giandcdalcorso11-coder/CNC-2D/documento-sessione-cnc-2d.md

# Documento di Sessione — CNC 2D Plotter

**Versione:** 32
**Ultimo aggiornamento:** 2026-10-17 09:24

## Regole di co-editing

Questo documento è scritto da **due sessioni Claude Code in parallelo sullo stesso branch**: una sul fronte **meccanica/firmware**, una sul fronte **contenuti e serie social**. Per non perdere voci a vicenda:

1. **`git fetch` e rebase prima di scrivere, push subito dopo.** Non lasciare modifiche locali non pushate: la finestra di collisione è tutta lì.
2. **Marca la voce di storico con il fronte di lavoro**, es. `### [2026-09-26 17:48] (meccanica) …`. Due sessioni diverse sono due voci diverse: la regola "una voce per sessione" non impone di fonderle.
3. **Le note dei singoli Step si appendono in fondo al proprio Step**, quindi non collidono mai finché le due sessioni lavorano su Step diversi.
4. **Se la Versione va in conflitto**, chi risolve mette `max(A, B) + 1` e tiene **entrambe** le voci, ordinate per data decrescente. Mai scartarne una.
5. Gli unici punti di contesa reali sono **le due righe di testata** e **la prima riga dopo `## Storico sessioni`**. Tutto il resto è partizionato per costruzione.

## Vision

Macchina CNC 2D per disegno/plotter, con:
- Assi X/Y motorizzati (NEMA17 modello 17HS4023 + driver A4988)
- Asse Z tramite servomotore per alzare/abbassare la penna
- Controllo firmware via ESP32 con FluidNC
- Invio G-code via Wi-Fi (WebUI di FluidNC), senza necessità di cavo USB durante il disegno
- In prospettiva, un software "stile slicer" per convertire SVG/immagini in G-code e caricarlo sulla macchina

## Pipeline

### Convenzioni valide per tutta la pipeline

**Nomi degli assi (dal 2026-10-15).** Secondo la convenzione cartesiana del
foglio, decisa dall'utente:

| Asse | Che cosa è | Staffa | Motore |
|---|---|---|---|
| **X** | la trave del portale: ci corre sopra il carrello che porta la penna | staffa LL, 550 | STEP D25 · DIR D33 |
| **Y** | le due rotaie di base: ci scorre sopra tutto il portale | staffe TT, 2 × 400 | STEP D4 · DIR D26 |

**Attenzione leggendo il resto del documento:** tutte le voci dello storico e
tutte le note anteriori al 2026-10-15 usano la nomenclatura precedente, in cui
X e Y erano **scambiati** rispetto a questa tabella. Non sono state riscritte —
le voci passate non si toccano. Quando una nota vecchia dice "corsa X 242,475"
intende la corsa del portale sulle rotaie di base, che oggi si chiama Y.

**Nomi delle staffe (dal 2026-10-12).** **Staffa TT** = le due rotaie da 400.
**Staffa LL** = la trave del portale da 550.

**Nomi delle due applicazioni (dal 2026-10-15).** Il progetto ne ha due, con
ruoli diversi, e non si sostituiscono a vicenda:

- **GDC CNC 2D SLICER** — l'applicazione vera: la webapp dello Step 4 (`webui/`)
  più la configurazione FluidNC che la esegue (`firmware/fluidnc/`). Importa il
  disegno, genera il G-code, comanda la macchina
- **Pannello di controllo manuale GDC CNC 2D** — lo strumento di collaudo dello
  Step 1.1 (`firmware/cnc2d_dashboard/`): frecce, un giro di pignone, slider del
  servo, log, OTA. Serve a montare e diagnosticare, non a disegnare

La cartella e il file dello sketch restano `cnc2d_dashboard`: l'IDE Arduino
esige che cartella e sketch abbiano lo stesso nome e non accetta spazi, quindi
il nome esteso vive nel titolo della pagina e nei README, non nel filesystem.

**Il repository GitHub si chiama `GDC-CNC-2D`** (rinominato dall'utente il
2026-10-15; GitHub non accetta spazi nei nomi e li sostituisce con trattini).
Non ha rotto nessun link: GitHub Pages non è attivo su questo repository,
l'applicazione è servita dall'ESP32 sulla rete locale, e GitHub redirige
automaticamente il vecchio URL. L'unico modo di rompere la redirezione è
creare un giorno un altro repository chiamato `CNC-2D` sullo stesso account.

### Step 1 — Bring-up alimentazione e logica ESP32

**Stato:** completato

**Obiettivo:** ESP32 funzionante e alimentabile sia da USB che da batteria, con GPIO verificati

**Decisioni progettuali:**
- Ramo alimentazione logica (5V, ESP32) separato dal ramo 24V dei motori
- **Una spina sola per tutta la macchina: 12 V / 3 A, due 7805 indipendenti.** Supera sia il ramo a 24 V sia la batteria 18650. Il mattone (DVE DSA-36W-12, 36 W) alimenta direttamente i VMOT dei due driver e, attraverso **due L7805CV separati**, il 5 V della logica e il 5 V del servo. Il punto non è il numero di regolatori: è che **i due 5 V non si possono tirare giù a vicenda**, perché ciascuno ha 7 V di margine e oltre 60 dB di reiezione. Un interruttore unico sui 12 V, a monte di tutto. Bilancio: picco ~2,15 A sui 3 A disponibili. **Alternative scartate:** un solo regolatore condiviso (è la configurazione che ha causato il brownout del servo); uno switching LM2596 (più efficiente e sarà l'upgrade, ma non ce l'aveva e due lineari separati sono elettricamente più puliti di uno switching condiviso); alimentazione separata del servo da una seconda presa, rifiutata dall'utente — una macchina si accende con una spina
- **Il 18650 e il modulo di ricarica escono dal progetto.** Hanno fatto il loro lavoro nel bring-up dei LED. Per motori e servo non reggono: il modulo dà ~1 A dichiarato con protezione che interviene prima, mentre il solo servo chiede 700 mA di spunto (1,4 A per un MG90S) e il boost ne tira 1,6 dalla cella per darne 1 in uscita
- **La breadboard resta il circuito definitivo, ma solo per i segnali.** Decisione dell'utente, con tre eccezioni concordate: i due 7805 coi loro condensatori vanno su millefori saldata (sono la parte più calda e con più corrente, e non cambieranno mai più); il ramo 12 V di potenza va su morsetti a vite (un contatto di breadboard è dato per ~1 A e lì ne passano fino a 2); la breadboard va fissata meccanicamente e i cavi ancorati con fascette. Il motivo delle eccezioni è la vibrazione: il portale accelera a 0,3 g sulla stessa tavola, e un contatto a frizione che diventa intermittente sulla linea STEP dà **passi persi**, cioè un difetto che si va a cercare nella meccanica dove non c'è
- Batteria 18650 + modulo boost/carica 5V Type-C (supporta "discharge while charging", quindi utilizzabile anche mentre è in carica)
- Interruttore SPST inserito solo sulla linea 5V+ verso il pin VIN dell'ESP32 (non sulla batteria), per non interrompere la ricarica quando la macchina è spenta
- GND comune tra guida breadboard, modulo batteria ed ESP32, verificato in continuità

**Criterio di completamento:** LED collegato a D2 lampeggia correttamente sia alimentato da USB sia da batteria+interruttore

**Note (cronologia dello step):**
- [2026-09-19] Verificati componenti hardware (batteria NASTIMA 12V, motori 17HS4023, driver A4988, alimentatore 24V riciclato da striscia LED) tramite confronto con i link Amazon e datasheet
- [2026-09-19] Test ESP32 standalone via USB-C con sketch Blink su D2 (GPIO2) e resistenza 220 ohm — riuscito
- [2026-09-19] Aggiunto modulo batteria 18650 (boost 5V + carica Type-C) e interruttore sulla linea 5V+ verso VIN — testato e funzionante
- [2026-09-26] **L'alimentatore non è più il 24 V recuperato dalla striscia LED**, ma un DVE DSA-36W-12: **12 V, 3 A, 36 W**. Supera il dato del 2026-09-19. Nota importante sulle conseguenze: a corrente impostata uguale, **la tensione di alimentazione non cambia né la coppia né la temperatura dei motori**, perché l'A4988 è un driver a corrente controllata — la tensione decide solo quanto in fretta la corrente sale, quindi conta alle alte velocità. Bilancio a 12 V con tre motori a 0,6 A: 0,28 A ciascuno, 0,85 A in totale, ~14 W su 36 disponibili (28% della corrente). L'unico punto in cui i 12 V stringono è il collegamento di due motori in serie su un solo driver: 6,0 V dei 12 se ne vanno fra caduta resistiva, induttanza e forza controelettromotrice, contro i 3,0 V di un motore per driver

#### Step 1.1 — Dashboard web di controllo e test

**Stato:** completato

**Obiettivo:** dashboard web autonoma ospitata direttamente sull'ESP32, raggiungibile dalla rete Wi-Fi di casa, con un controllo di test sul LED e configurazione Wi-Fi senza dover ricompilare/riflashare

**Decisioni progettuali:**
- Web server nativo (`WebServer.h`, incluso nel core ESP32) invece di `ESPAsyncWebServer`, per non richiedere librerie esterne da installare
- Credenziali Wi-Fi salvate in NVS (`Preferences`) e configurabili da una tab dedicata nella dashboard; fallback automatico ad Access Point di emergenza (`CNC-2D-Setup`) se la connessione alla rete salvata fallisce, così la pagina resta sempre raggiungibile per correggerle
- mDNS (`cnc2d.local`) per raggiungere la dashboard senza dipendere dall'IP assegnato dal router
- Frecce direzionali presenti in UI ma non collegate a nessuna funzione, in previsione del controllo assi X/Y (Step 2)
- Tab "Codice" lasciata come placeholder: in futuro servirà per caricare direttamente un file G-code dal browser (non per compilare sketch — l'ESP32 non può compilare C++ da solo), da attivare dopo aver validato motori (Step 2) e servo/pen-lift (Step 3)

**Criterio di completamento:** dashboard raggiungibile da browser sulla rete di casa, pulsante centrale che accende/spegne il LED su D2 in tempo reale, funzionamento verificato sia con ESP32 alimentato da USB sia da batteria+interruttore

**Note (cronologia dello step):**
- [2026-09-19] Implementato sketch `firmware/cnc2d_dashboard/cnc2d_dashboard.ino` con web server, pagina a 3 tab (Controllo, Wi-Fi, Codice), salvataggio credenziali Wi-Fi su NVS e fallback ad AP di emergenza
- [2026-09-19] Bug: errore di compilazione "unterminated raw string" — causato da copia-incolla manuale del codice in un nuovo sketch anziché apertura diretta del file `.ino`, con probabile perdita dell'ultima riga di chiusura della stringa raw; risolto scaricando il file raw direttamente da GitHub
- [2026-09-19] Test completo riuscito: provisioning Wi-Fi di casa dalla tab dedicata, dashboard raggiungibile su `http://cnc2d.local`, LED su D2 controllato correttamente sia da alimentazione USB sia da batteria 18650+interruttore
- [2026-09-20] Aggiunti alla dashboard: 2 nuovi LED di stato (verde su D18, giallo su D19) con pulsanti dedicati Rosso/Giallo/Verde sotto le frecce (il pulsante centrale del joystick è stato disabilitato, non usa più il LED); supporto ArduinoOTA per aggiornare il firmware via Wi-Fi dopo il primo upload USB; tab "Log" che mostra in tempo reale gli stessi messaggi del Serial Monitor (utile perché il Serial Monitor via USB non è più disponibile quando si aggiorna via OTA)
- [2026-09-20] Frecce sinistra/destra collegate al motore X (STEP/DIR/ENABLE): click singolo = un passo, pressione prolungata = rotazione continua non bloccante; aggiunti pulsanti "Giro completo ←/→" (200 passi) per test rapido — dettagli del cablaggio e del debug nello Step 2
- [2026-09-20] Rifattorizzato il motore della dashboard: il movimento non è più eseguito dentro l'handler HTTP (che bloccava per 3 secondi affamando `server.handleClient()` e l'OTA) ma da una coda di passi servita in `loop()`, prima e dopo `handleClient()`; DIR impostato una sola volta a inizio movimento con tempo di assestamento invece che a ogni impulso; aggiunta rampa di accelerazione opzionale sui primi 40 passi
- [2026-09-20] Aggiunta tab "Motore": intervallo tra i passi regolabile da browser (300 µs – 200 ms), numero di passi, rampa on/off, abilitazione diretta del driver e sezione "Test pin" che forza STEP/DIR/EN a un livello fisso per poterli misurare col multimetro. Ogni movimento registra nel log i passi effettivamente emessi, così si distingue subito un problema firmware da uno elettrico
- [2026-10-12] **Bug: il servo non si muove e la scheda si spegne**
  **Sintomo:** a ogni comando del servo il LED rosso dell'ESP32 e quello del modulo di ricarica si spegnevano per un istante; il servo non si muoveva affatto. I LED comandati dalla dashboard funzionavano, quindi scheda e rete erano sane. Con l'ESP32 spostato su alimentatore da muro il sintomo cambiava: la scheda restava accesa, il servo **vibrava** e i LED del modulo batteria lampeggiavano in continuazione
  **Causa:** il servo e la logica condividevano il 5 V del modulo 18650. Lo spunto del servo (700 mA, 1,4 A per un MG90S) faceva collassare quel ramo; l'ESP32 andava in brownout e, resettandosi, smetteva di generare il PWM — quindi il servo non arrivava mai in posizione. Nella seconda configurazione il collasso restava sul solo ramo servo e si vedeva per quello che era: **protezione che scatta e riparte in ciclo** (*hiccup mode*), con il servo alimentato a singhiozzo
  **Fix applicato:** due L7805CV separati dai 12 V, uno per la logica e uno per il servo. **Confermato dall'utente: tutti i test passano.** Il percorso diagnostico è costato due giorni perché l'alimentazione era stata classificata come causa poco probabile (vedi voce di storico del 2026-10-13)
- [2026-10-13] **Mancano i condensatori ceramici e per ora si va avanti così.** Montati solo gli elettrolitici. Funziona, ma l'elettrolitico alle alte frequenze non c'è: senza un ceramico vicino ai piedini il 7805 può oscillare nei MHz, e il sintomo non è un guasto netto — è riscaldamento inspiegabile, rumore sul 5 V, qualche reset a caso. Da aggiungere: **100 nF su IN e su OUT di ogni regolatore**, più uno in parallelo ai 100 µF sul VMOT di ogni driver

### Step 2 — Bring-up driver A4988 e motori (X/Y)

**Stato:** completato

**Obiettivo:** un motore NEMA17 pilotato correttamente da un driver A4988 tramite ESP32, poi due motori in parallelo

**Decisioni progettuali:**
- Vref target ~0.5-0.56V per 0.7A per fase (corrente nominale reale del 17HS4023, non 1.0A come inizialmente indicato da una fonte esterna consultata)
- Alimentazione di potenza: alimentatore switching DC **12V/3A** (DVE DSA-36W-12). Sostituisce l'alimentatore riciclato dalla striscia LED RGB, che si è rivelato inutilizzabile (vedi bug sotto). 12V sono ampiamente sufficienti per il plotter e fanno scaldare molto meno il driver rispetto a 24V
- **Condensatore elettrolitico 100 µF / 50 V obbligatorio tra VMOT e GND del driver**, il più vicino possibile al modulo: senza, i picchi induttivi generati dalle bobine a ogni commutazione distruggono l'A4988 (è la causa della perdita dei primi due moduli)
- Collaudo di accettazione di ogni nuovo modulo A4988 prima di alimentarlo: continuità tra STEP, DIR, EN e GND deve essere **muta** su tutti e tre. Venti secondi che smascherano subito un ingresso in corto
- Pin driver: STEP su D4, DIR su D26 (era D16), ENABLE su D27 (era D17) — spostati da D16/D17 per un problema di instabilità non ancora confermato con certezza (vedi bug nello storico sessioni)
- Bobine motore identificate via continuità: bobina 1 = fili rosso+blu, bobina 2 = fili nero+verde; mappate sul driver rispettivamente su 1A/1B e 2A/2B (l'assegnazione "1"/"2" rispetto ai colori è invertita rispetto al primo tentativo ma elettricamente corretta, non causa malfunzionamenti — cambia solo il verso di rotazione)
- Alimentatore 24V riciclato da striscia LED RGB: verificato con multimetro che il filo bianco è il vero 24V+ e il filo rosso è il GND (contro-intuitivo rispetto al colore); i fili blu e verde sono ridondanti (stesso nodo del bianco) e isolati, non utilizzati
- Scheda "Nano Terminal Adapter" (pensata per Arduino Nano) riadattata come morsettiera generica per i collegamenti di potenza (24V e fili motore), sfruttando il fatto che è puramente passiva (screw terminal + header pin sullo stesso nodo) — alternativa scartata: morsetti a vite dedicati, non disponibili al momento
- Velocità di step di partenza volutamente prudente (senza rampa di accelerazione) per il primo test, da aumentare più avanti con una rampa vera

**Criterio di completamento:** rotazione controllata e affidabile di entrambi i motori tramite comandi step/dir dall'ESP32

**Note (cronologia dello step):**
- [2026-09-20] Cablaggio completo del driver A4988 (logica + potenza) e del motore X, con verifica pin ENABLE tramite conteggio sull'etichettatura reale del modulo (foto)
- [2026-09-20] Bug: primo driver A4988 non muoveva il motore
  Sintomo: nessuna reazione del motore a "Giro completo" né alle frecce, solo un leggero ronzio; bloccato con forza al tatto (normale per uno stepper abilitato, non diagnostico da solo)
  Causa: sospetto danneggiamento del chip driver (probabile durante le prove di cablaggio in tensione) — tutti i controlli di continuità su STEP/DIR/ENABLE/VDD/RESET-SLEEP/VMOT/GND risultati corretti
  Fix applicato: sostituito con un secondo modulo A4988 di scorta — con il nuovo modulo il motore ha iniziato a muoversi (parzialmente), confermando che il primo era guasto
- [2026-09-20] Bug: Vref bloccato a 0,20V sul secondo modulo, il potenziometro sembrava non avere effetto
  Sintomo: valore instabile e comunque fermo a 0,20V (target 0,50–0,56V) girando il trimmer
  Causa: misura instabile a causa del motore collegato durante la prova (rumore/carico sul riferimento)
  Fix applicato: misurato Vref a motore scollegato — tarato correttamente a 0,55V
- [2026-09-20] Bug: il motore gira solo con passi singoli, non con pressione prolungata né con "Giro completo"
  Sintomo: ogni click singolo produce un piccolo movimento pulito senza perdere passi; in sequenza continua il motore non si muove (con solo un leggero ronzio) oppure avanza a scatti di circa 1/5 di giro senza completare la rotazione
  Causa: individuata con un test del "wiggle" — muovendo il filo che collega ENABLE (D17) durante il funzionamento, il motore si mette a girare; il problema persiste anche sostituendo il filo con uno nuovo o cambiando i fori della breadboard, e la continuità elettrica su quel filo risulta comunque corretta a riposo. Causa non ancora confermata con certezza: si sospetta un comportamento specifico dei pin GPIO16/GPIO17 (usati per DIR/ENABLE), che su alcune varianti di modulo ESP32 con PSRAM (WROVER) sono riservati e non utilizzabili come GPIO liberi — dalla foto del modulo (etichettato solo "ESP-32", nessuna scritta "WROVER" visibile) non è stato possibile confermare con certezza se questo sia il caso
  Fix applicato: non ancora confermato — spostati DIR (D16→D26) ed ENABLE (D17→D27) su pin sicuramente liberi da questo vincolo su qualunque variante ESP32; il test dopo lo spostamento non è ancora stato riportato a fine sessione — **da riprendere nella prossima sessione**
- [2026-09-20] Il bug sopra è stato **risolto**: lo spostamento su D26/D27 non c'entrava nulla e l'ipotesi PSRAM/WROVER era sbagliata. La causa reale era l'alimentatore di potenza (vedi bug successivo). I pin sono stati comunque lasciati su D26/D27, che vanno benissimo
- [2026-09-20] Bug: alimentatore di potenza inutilizzabile — **causa radice di tutta la sessione**
  Sintomo: tensione su VMOT del driver oscillante tra 1 V e 20 V invece che ferma; coppia di tenuta debolissima (l'albero si girava con due dita, mentre a 0,69 A/fase dovrebbe essere immobile); passi singoli occasionalmente corretti, rotazione continua mai
  Causa: l'alimentatore riciclato è un **controller per strisce LED RGB**, non un alimentatore DC. Dei 4 fili, il bianco è il +24V comune e rosso/verde/blu sono le tre uscite di canale, cioè MOSFET pilotati in PWM. Usare il filo rosso come massa significava alimentare il driver attraverso un interruttore che si apriva e chiudeva continuamente. Verificato misurando sotto carico su tutti e tre i canali: instabili tutti
  Fix applicato: sostituito con un alimentatore switching DC 12V/3A, misurato stabile a 12,2 V. **Confermato**
- [2026-09-20] Bug: secondo driver A4988 con ingresso STEP in corto verso massa
  Sintomo: dopo aver risolto l'alimentazione, l'albero era finalmente duro e il test ENABLE rispondeva, ma nessun comando produceva movimento e il motore restava in silenzio assoluto. Misurando il pin STEP sul driver si leggeva sempre 0 V pur avendo continuità verso D4
  Causa: individuata dividendo il nodo STEP in due metà e misurandole separatamente — lato ESP32 muto (GPIO4 sano), lato driver in corto a 0,2 Ω, e sfilando il modulo la breadboard tornava muta. L'ingresso STEP era quindi in corto **dentro il chip**, inchiodato a 0 V. Danno provocato dallo stesso alimentatore RGB
  Fix applicato: sostituito con il terzo modulo A4988, collaudato prima dell'installazione con il test di continuità STEP/DIR/EN verso GND. **Confermato**
- [2026-09-20] Motore X funzionante: Vref tarato a 0,54 V sul nuovo modulo, test ENABLE corretto (albero bloccato con spunta, libero senza) e movimento comandato dalla dashboard riuscito
- [2026-09-21] Sweep di velocità completato su tutta la gamma disponibile fino a 500 passi/s: nessuna banda di risonanza, nessun microstepping necessario per la stabilità
- [2026-09-21] Secondo asse cablato: driver Y con STEP su D25 e DIR su D33, ENABLE condiviso con X su D27. Al primo avvio il motore Y girava da solo senza controllo — causa: D25/D33 non erano ancora configurati come uscite nel firmware e, restando ingressi flottanti, raccoglievano rumore che il driver interpretava come impulsi di STEP. Risolto portando i pin STEP a livello basso come prima istruzione di `setup()`
- [2026-09-21] **Step chiuso:** entrambi gli assi pilotati correttamente, singolarmente e in contemporanea
- [2026-10-12] **Microstep confermati 1/16 da un dato dell'utente**, non più per ipotesi: MS1, MS2 e MS3 sono ponticellati insieme e portati a VCC, e sulla tabella dell'A4988 tutti e tre alti = sedicesimo di passo. Quindi **33,953 passi/mm** è il numero vero, e il default della dashboard era già giusto
- [2026-10-12] **Dashboard riscritta per la trasmissione reale.** Tre cambiamenti strutturali: (a) i passi non escono più da `loop()` ma da un **timer hardware a 20 kHz** con accumulatore a virgola fissa — con i microstep attivi la frequenza sale a qualche migliaio di impulsi al secondo e `server.handleClient()` può bloccare il loop per centinaia di millisecondi, cioè buchi nel treno di impulsi; (b) l'interfaccia parla in **millimetri** (velocità 1÷100 mm/s, distanza in mm) invece che in passi, e il pulsante "360°" diventa "1 giro" = 94,2478 mm calcolati dai microstep impostati; (c) due pulsanti eseguono **quadrato da 40 mm e cerchio R20** come macchina a stati non bloccante, movimenti di penna compresi, replicando i file in `gcode/test/`. Aggiunto anche uno slider dell'angolo servo dal vivo nella tab Controllo
- [2026-10-12] **Bug: lo sketch non compila, "variable or field 'setDir' declared void"**
  **Sintomo:** errori a catena su tutte le funzioni che prendono `Motor&` o `DemoStep&`, indicando righe di definizione scritte correttamente e con la struct dichiarata cinquanta righe più su
  **Causa:** l'IDE Arduino genera da solo i prototipi di tutte le funzioni e li inserisce **subito prima della prima funzione del file**, con una direttiva `#line` che fa riportare l'errore alla riga della definizione originale. Spostando le costanti della trasmissione in cima, la prima funzione era diventata `stepsPerMm()`, che sta sopra `struct Motor`: i prototipi generati nominavano un tipo non ancora dichiarato. Nelle versioni precedenti funzionava **per caso**, perché la prima funzione era `logMsg()`, che sta sotto la struct
  **Fix applicato:** `Motor` e `DemoStep` spostate in una sezione "Tipi" in cima al file, prima di qualunque funzione, col commento che spiega perché non stanno vicino al codice che le usa. **Confermato: compila e gira.** Il controllo di sintassi fatto qui con g++ non poteva vedere l'errore per costruzione, perché g++ non inietta prototipi — il controllo è stato esteso emulando quel passaggio, e validato al contrario facendogli riprodurre l'errore sulla versione vecchia
- [2026-10-12] **Rampa del servo in firmware** (`servoGoTo` + `serviceServo`): invece di saltare all'angolo richiesto il servo ci arriva di N gradi ogni 10 ms, con N impostabile da 0 (salto secco) a 10. Serve contro il brownout — un servo che vede un errore grande parte alla corrente di stallo — ma **non sostituisce l'alimentazione**: abbassa il picco, non il consumo totale. Come diagnosi era decisiva, come cura no, ed è andata così. Le prove d'insieme ora aspettano che la penna sia **arrivata** invece di un ritardo fisso
- [2026-10-13] **I motori rallentano mentre si muove il servo, e non è un problema.** Lo stack Wi-Fi maschera le interruzioni per brevi istanti durante il traffico HTTP, quindi qualche tick del timer salta. Ma il contatore dei passi scala **solo quando un impulso esce davvero**: un tick saltato allunga il tempo, non toglie un passo. **Costa tempo, non posizione** — e quindi non invalida la taratura dei passi/mm, che si misura in distanza. Sparisce comunque da sé: nella macchina vera la penna si muove solo a carrelli fermi, ed è il G-code a imporlo

### Step 3 — Configurazione FluidNC

**Stato:** completato

**Obiettivo:** FluidNC installato e configurato come firmware definitivo della macchina, con movimento coordinato X/Y e pen-lift sul servo

**Decisioni progettuali:**
- **FluidNC è il firmware definitivo**, lo sketch `cnc2d_dashboard` retrocede a strumento di collaudo hardware. Motivo: interpolazione coordinata, pianificazione dell'accelerazione fra segmenti e interpretazione del G-code sono settimane di lavoro già risolte e collaudate su migliaia di macchine
- **Pen-lift come asse Z vero** tramite il tipo motore `rc_servo`, non tramite l'uscita PWM dello spindle con M3/M5. Supera la decisione originale dello Step 3: trattare la penna come un asse permette al generatore di G-code di gestirla come un movimento qualsiasi
- **Microstepping 1/16** (MS1/MS2/MS3 a VDD su entrambi i driver): a passo intero la risoluzione sarebbe di circa 0,2 mm per passo, uno scalino visibile a occhio sul tratto. A 1/16 si scende attorno ai 0,02 mm. Il valore esatto di `steps_per_mm` dipende dal pignone scelto (vedi Step 5) e va comunque tarato sulla macchina
- **Nessun azzeramento automatico**: niente finecorsa di riferimento, l'origine si imposta a mano con `G92 X0 Y0`. Conseguenza: `soft_limits` resta disattivo, perché FluidNC lo consente solo su macchina azzerata, e la protezione contro le uscite dall'area passa all'interfaccia web
- **Driver mai disabilitati** (`idle_ms: 255`): con l'azzeramento manuale, un asse che si ammorbidisce e viene spostato a mano farebbe perdere la posizione senza che nessuno se ne accorga. Annulla l'idea, discussa e poi scartata, di un auto-spegnimento dei driver dopo inattività
- **Due pulsanti di emergenza** su D13/D14 nell'angolo in basso a sinistra, configurati come finecorsa rigidi: in teoria non vengono premuti mai, se succede FluidNC ferma tutto e va in allarme. Cablati normalmente aperti verso massa — accettabile per un backstop, da rivedere con microswitch veri
- **LED di stato come `user_outputs`**, comandati dall'interfaccia web con M62/M63: verde = tutto bene, giallo = attenzione (non calibrato, posizione non attendibile, in pausa), rosso = errore
- **Azzeramento sui due pulsanti d'angolo, `soft_limits` attivi e `must_home` vero.** Supera la decisione "nessun azzeramento automatico" presa il 2026-09-21. I due pulsanti su D13/D14 esistono già e sono cablati: aggiungendo un blocco `homing` per asse diventano **anche** riferimenti di azzeramento, e questo sblocca `soft_limits`, cioè il **rifiuto dei movimenti fuori area nel pianificatore** invece che nell'interfaccia. Costo in componenti: zero, è una modifica al YAML. Il motivo per cui conta: un limite che vive solo nella UI non è una protezione ma un suggerimento — un comando battuto a mano nella console di FluidNC, un file malformato o un bug nel generatore lo scavalcano. La ripetibilità di un pulsante a cupola è scarsa (±1 mm), ma per la **sicurezza** basta che sia conservativo, non preciso: la dispersione sposta il disegno sul foglio, il margine copre l'incidente. Microswitch veri (±0,03) restano l'upgrade
- **I limiti stanno in due posti diversi perché sono due cose diverse.** Le **corse meccaniche** sono proprietà della macchina e vivono in FluidNC (`max_travel_mm`); il **foglio** è proprietà del lavoro e vive nell'app (`paper` + `sheetOrigin`); il **margine di sicurezza** è un numero proprio, esplicito ed editabile, e il limite effettivo (`corsa − margine`) è calcolato e mostrato, mai salvato. Applicazione della regola già scritta in `webui/js/settings.js`: "due posti in cui scrivere lo stesso numero sono due posti che prima o poi si contraddicono". Azzerando in un angolo basta **un numero per asse** invece di min e max, che è anche la convenzione di FluidNC
- **Il riferimento va sul metallo, il margine nel software.** Parcheggiare "a circa 2÷3 cm dal fondo" a occhio fa diventare l'errore di parcheggio un errore di margine: si crede di essere a 25 mm e si è a 12. Si va in battuta su qualcosa di fisico (errore zero per definizione) e il margine lo sottrae il firmware. Corollario: **i limiti sopravvivono al riavvio, il riferimento no** — un passo-passo senza encoder non può sapere se qualcuno ha spostato il carrello mentre era spento. Serve uno stato `NON AZZERATA` in cui sono permessi solo jog relativi a passo limitato, e nessun movimento assoluto né esecuzione di file

**Criterio di completamento:** la macchina disegna un quadrato e un cerchio con movimento coordinato dei due assi, verificabile a vista sui motori anche senza struttura montata

**Note (cronologia dello step):**
- [2026-09-21] Scritta la configurazione di partenza `firmware/fluidnc/cnc2d-config.yaml` con la mappa dei pin già validata. Restano da tarare `steps_per_mm`, `max_travel_mm` e gli estremi dell'impulso del servo, tutti dipendenti dalla meccanica
- [2026-09-21] Installazione FluidNC avviata dal web installer (`installer.fluidnc.com`, richiede Chrome o Edge perché usa WebSerial). Scelte: versione **v4.1.0** (ultima non pre-release), processore **esp32** (DevKit WROOM-32 a 30 pin), variante **wifi** (l'unica con WebUI), tipo **fresh-install**, interfaccia **WebUI-2** — scelta fra le tre disponibili perché è quella su cui è costruita la documentazione del wiki, e se ne può installare una sola
- [2026-09-21] Da verificare alla prima accensione: la configurazione è stata scritta sullo schema FluidNC 3.x, mentre la versione installata è la 4.1.0. Eventuali nomi di campo cambiati vengono segnalati dal validatore all'avvio
- [2026-09-21] **Lo schema 4.1.0 ha accettato la configurazione scritta sul 3.x senza una sola modifica.** Il dubbio segnalato nella nota precedente è risolto: nessun nome di campo è cambiato fra le due versioni per i costrutti che usiamo
- [2026-09-21] Attivazione della configurazione: il pulsante "Seleziona configurazione" del browser dei file non ha avuto effetto, si è dovuto usare `$Config/Filename=cnc2d-config.yaml` dal terminale. Il comando di modifica a runtime `$/axes/shared_stepper_disable_pin=...` non restituisce nulla sulla 4.1.0, quindi le correzioni alla configurazione si applicano ricaricando il file e riavviando con `$Bye`
- [2026-09-21] WiFi configurato in modalità STA, hostname `cnc2d`, raggiungibile su `http://cnc2d.local` e `http://192.168.1.11`. Da qui in avanti l'installer non serve più: si lavora dalla WebUI-2
- [2026-09-21] LED verificati funzionanti con `M62 P0/P1/P2` e `M63 P0/P1/P2` (P0 verde gpio.18, P1 giallo gpio.19, P2 rosso gpio.2). La variante immediata M64/M65 non è stata necessaria. Il canale per legare le spie allo stato della macchina è quindi disponibile
- [2026-09-21] Microstepping 1/16 verificato su entrambi gli assi: 40 mm comandati (3200 microscatti con `steps_per_mm: 80`) producono un giro esatto dell'albero. A passo intero ne avrebbero prodotti sedici, quindi il test è inequivocabile a occhio. Ponticelli realizzati a catena RST→MS3→MS2→MS1, sfruttando il fatto che RST è già a VDD ed è adiacente a MS3: tre ponticelli cortissimi per driver, nessun filo lungo
- [2026-09-21] **Step completato**: quadrato da 40 mm e cerchio da raggio 20 mm eseguiti correttamente, con ritorno alle coordinate di partenza. Il criterio di completamento è soddisfatto
- [2026-10-06] **`steps_per_mm` nella configurazione è sbagliato di 2,36×, ed è il primo numero da correggere.** `cnc2d-config.yaml` porta ancora `steps_per_mm: 80` con il commento "vale per cinghia GT2 + puleggia 20 denti". La macchina non ha più cinghie: con pignone e cremagliera m1.5 z=20 il giro vale `π · m · z = 94,2478` mm (= 20 denti × passo 4,7124), e con 200 passi × 16 microstep fa **33,953 passi/mm**. Finché quel numero è sbagliato ogni limite inserito è sbagliato dello stesso fattore — si scrive "300 mm di corsa" e la macchina ne percorre 707 — e nessun pannello può intercettarlo, perché il pannello parla in mm e il mm è falso. Il criterio di completamento dello step resta soddisfatto (quadrato e cerchio verificati a vista sui motori), ma le quote erano 2,36× quelle comandate
- [2026-10-06] Conseguenze collaterali del rapporto vero: risoluzione **0,0295 mm per microstep** (il gioco di 0,235 è 8× il passo, quindi è il gioco a dominare, non la risoluzione) e `max_rate_mm_per_min: 2000` corrisponde ora a 1132 microstep/s invece di 2667, cioè **un settimo** di quello che la meccanica regge (il motore è validato a 500 passi interi/s ≈ 235 mm/s). Verifica del rapporto: `G91 G0 X100`, misurare col calibro, correggere in proporzione

### Step 4 — GDC CNC 2D SLICER (interfaccia web e generazione G-code)

**Stato:** in corso

**Obiettivo:** un'unica pagina web da cui caricare un disegno, vederne l'anteprima sul foglio, generare il G-code e mandarlo in esecuzione

**Decisioni progettuali:**
- **Tutta l'elaborazione nel browser, l'ESP32 solo esegue.** L'ESP32 ha circa 300 KB di RAM utilizzabile: vettorializzare un'immagine e generare G-code è fuori portata. Il browser produce il file, l'ESP32 lo conserva ed esegue — così il disegno prosegue anche se si chiude il portatile o cade il Wi-Fi
- **Vettorializzazione con algoritmi deterministici** (Potrace o equivalente in JavaScript), non con un modello generativo. Alternativa scartata: passare l'immagine a un AI esterna con prompt da copiare e incollare — un modello linguistico non ricalca un'immagine, inventa percorsi plausibili, diversi a ogni tentativo e senza controllo su dove passa la penna. L'AI resta utile a monte, per preparare il soggetto come disegno a tratto
- **Si parte dall'SVG e basta.** I percorsi sono già vettoriali, non serve tracciamento: è il caso d'uso più frequente e costa una frazione del lavoro. Line art e planimetrie (soglia + tracciamento) vengono dopo. Le foto richiedono algoritmi dedicati — stippling, campi di flusso, retinatura — e sono un progetto a sé
- **Interfaccia servita dall'ESP32 come file separati**, non più come stringa dentro lo sketch: il codice resta leggibile e l'interfaccia si aggiorna dal browser senza ricompilare
- **Layout**: colonna menu a sinistra, foglio centrale con formati A4/A5/A6 e dimensioni modificabili, drop box con anteprima, colonna a destra per scorrere l'anteprima del movimento — che durante il disegno vero diventa indicatore di avanzamento. Tab separate per log e impostazioni
- L'anteprima distingue **tratti disegnati e spostamenti a vuoto** con colori diversi: vedere gli spostamenti a vuoto è il modo per accorgersi che il disegno è ordinato male
- **L'interfaccia dovrà essere servita dall'ESP32 per comandare la macchina.** FluidNC espone il suo HTTP senza intestazioni CORS, e una pagina in HTTPS non può comunque interrogare un dispositivo in HTTP semplice: online-ovunque più comando diretto è una combinazione che il browser vieta. Conseguenza operativa: niente framework, niente librerie, niente processo di build, perché la pagina deve stare nella memoria dell'ESP32
- **Il calcolo resta nel browser anche quando la pagina è servita dall'ESP32.** Il microcontrollore consegna il file, il processore del PC o del telefono fa il lavoro. L'ottimizzazione del percorso del logo di prova ha impiegato 1 ms
- **Il criterio dell'ottimizzazione è il tempo, non la distanza.** Un'alzata di penna costa circa mezzo secondo fra movimento del servo e assestamento; cinquanta millimetri di spostamento a 2000 mm/min ne costano uno e mezzo. Saldare i tratti contigui vale quindi più che accorciare gli spostamenti, e viene prima nella catena
- **Modalità finta sempre disponibile**: l'interfaccia simula le risposte della macchina, così ci si lavora senza accendere nulla — che è la maggior parte del tempo
- **Il nome è GDC CNC 2D SLICER** (deciso dall'utente il 2026-10-15). Regge il confronto con quello che l'applicazione fa davvero: non è solo una pulsantiera, converte un disegno in percorsi utensile — che è esattamente il lavoro di uno slicer, con la differenza che il risultato è piano invece che a strati
- **La tab Impostazioni è l'unica fonte di verità dei numeri della macchina** (deciso il 2026-10-15). Oggi gli stessi valori vivono in tre posti che non si parlano: i `#define` del firmware della dashboard, il `cnc2d-config.yaml` di FluidNC e i default dell'anteprima nel browser. Finché è così, tarare la macchina vuol dire ricordarsi di cambiare lo stesso numero tre volte, e il giorno che se ne dimentica uno l'anteprima mostra un disegno che la macchina non fa. La tab deve **contenere i valori, salvarli e poterli esportare**, e anteprima, generatore di G-code e macchina devono leggerli tutti da lì
- **Due passi/mm, uno per asse, non uno globale** (2026-10-15). Le due cremagliere sono stampate separatamente e si sono ritirate di quantità diverse: un valore solo fa uscire i quadrati rettangoli. Oggi il firmware della dashboard ne ha uno solo, calcolato da `MM_PER_REV`; FluidNC li ha già separati per asse

**Che cosa deve contenere la tab Impostazioni** (lista di lavoro, da completare
mano a mano che le misure arrivano):

| Gruppo | Valori |
|---|---|
| Trasmissione | passi/mm **per asse**, microstep impostati sui ponticelli, inversione di direzione per asse |
| Corse | corsa utile per asse (`max_travel_mm`), origine dell'area di disegno, posizione e formato del foglio nel piano |
| Dinamica | velocità massima e accelerazione per asse, velocità di disegno distinta da quella di spostamento a vuoto |
| Penna | **angolo di battuta** (cuscinetti in fondo ai blocchi inferiori: limite meccanico, il software non scende sotto), **angolo penna appoggiata** (sopra la battuta; è anche l'angolo a cui tenere il servo mentre si infila e si stringe la penna), **angolo penna alzata** (sopra l'appoggio), **angolo di battuta alta** (secondo limite meccanico), raggio del pignone del servo (18,750 → 0,32725 mm/grado, per inserire alzata e appoggio in millimetri invece che in gradi), verso di rotazione, passo della rampa del servo, pausa dopo ogni su/giù (150÷250 ms) |
| Utensile | offset della punta rispetto al riferimento del carrello (X e Y), altezza del piano carta |
| Compensazioni | gioco d'ingranamento per asse, se si deciderà di compensarlo |

**Criterio di completamento:** caricare un SVG, vederlo posizionato nel foglio, generare il G-code e farlo eseguire alla macchina

**Note (cronologia dello step):**
- [2026-09-24] Costruita l'impalcatura completa (`webui/`, dodici file): tre colonne, tab Disegno/Log/Impostazioni, foglio con formati, cursore verticale per scorrere l'anteprima del percorso
- [2026-09-24] Rifatta l'area centrale: il riquadro è ora **il piano della macchina**, fisso, con reticolo da 10 mm e lo zero macchina marcato; il foglio è un rettangolo disegnato dentro, trascinabile col puntatore, e il suo bordo diventa rosso quando esce dall'area. Il disegno è tenuto in coordinate del foglio, quindi lo segue per costruzione
- [2026-09-24] Importazione SVG funzionante: l'appiattimento delle curve lo fa il browser campionando `getPointAtLength` per lunghezza d'arco, e lo stesso campionamento riconosce i sotto-tracciati (due campioni non possono distare più del passo, quindi un salto più lungo è uno stacco di penna dentro lo stesso elemento — il foro di una "o")
- [2026-09-24] Ottimizzazione e G-code funzionanti. Sul logo dell'utente: 11 tratti, 294 punti, spostamenti da 769 a 424 mm, circa 1 min 15 s stimati, calcolo in 1 ms. La stima del tempo usa un profilo trapezoidale per polilinea, perché il look-ahead di FluidNC mantiene la velocità fra segmenti consecutivi
- [2026-09-24] Resta da fare: invio del programma alla macchina, avanzamento in tempo reale, caricamento della pagina sull'ESP32, conversione da fotografia a tracciato
- [2026-10-15] **Battezzata GDC CNC 2D SLICER** su proposta dell'utente, e stabilito che la tab Impostazioni va riprogettata bene prima di riprendere il resto: è lì che finiranno tutte le misure di taratura, e progettarla male significa doverla rifare dopo averci messo dentro i numeri
- [2026-10-15] Registrato che **il firmware della dashboard espone un solo passi/mm** per entrambi gli assi (`stepsPerMm()`, calcolato da `MM_PER_REV`): va separato per asse prima della taratura
- [2026-10-17] **Il gruppo Penna della tab Impostazioni diventa quattro angoli più una conversione**, su richiesta dell'utente. Il valore che mancava è l'**angolo di battuta**, cioè quello a cui i cuscinetti arrivano in fondo ai blocchi inferiori: è un limite meccanico, non una preferenza, e il software non deve poter scendere sotto. Sopra c'è l'angolo di appoggio — che è anche quello a cui tenere il servo mentre si infila la penna e si stringono i morsetti, perché è la stessa posizione — e sopra ancora quello di penna alzata. Aggiunta mia: serve anche la **battuta alta**, perché la pista è limitata dalle due parti (15,350 di salita contro 11,000 di discesa), e serve il **raggio del pignone** come unico parametro di conversione, così alzata e appoggio si inseriscono in millimetri e la pagina li traduce in gradi (0,32725 mm/grado a r = 18,750). Senza quel campo ogni numero della sezione penna è in gradi e nessuno è leggibile

### Step 5 — Struttura meccanica

**Stato:** completato nella struttura (2026-10-15) — staffa LL tagliata, portale montato sulla base, i due assi si muovono da dashboard senza difficoltà. Resta aperto solo il modulo penna (Step 6), senza il quale la macchina non disegna e non si può tarare

**Obiettivo:** struttura a portale che porta la penna su un'area di **circa 242 × 256 mm**, con entrambi gli assi motorizzati e il pen-lift solidale al carrello Y. *(Formato ridimensionato il 2026-10-06: l'obiettivo originale era "tutta l'area di un foglio A4 in orizzontale", ma con cremagliere in un pezzo solo il lato da 297 non entra su nessuno dei due assi — il massimo raggiungibile è 281,6 × 292,8. L'area è equivalente a un A4, la forma è quadrata. Un A4 vero richiede una cremagliera giuntata.)*

**Decisioni progettuali:**
- **Trasmissione a cremagliera e pignone**, non a cinghia. Motivo: si stampa in 3D a costo quasi nullo, mentre le cinghie richiedono cinghia, pulegge e tenditori acquistati. Alternativa scartata: cinghia GT2, che avrebbe gioco quasi nullo e motori fissi — resta la via di ripiego se il gioco della cremagliera risultasse ingestibile, e non richiederebbe di rifare la struttura ma solo i supporti dei motori
- **Motore solidale al carrello**, conseguenza intrinseca della cremagliera: per tenere il motore fermo dovrebbe muoversi la cremagliera, raddoppiando lo spazio necessario. Comporta ~300 g di massa mobile in più sull'asse X, da compensare con velocità moderate
- **Gioco gestito assottigliando il dente della cremagliera di 0,2 mm, non con un precarico a molla.** Supera la decisione del precarico a molla: il gioco effettivo si regola con la profondità di ingranamento (per una cremagliera `j = 2·Δc·tan20°`, quindi 0,2747 mm di avvicinamento azzerano lo 0,2), e il metodo pratico è la striscia di carta da 0,10 mm nel punto più stretto. Una molla avrebbe aggiunto un grado di libertà su un carrello che ne ha già abbastanza. Impostazione precedente: precarico a molla del pignone contro la cremagliera: il motore non è fissato rigido ma su una piastrina che oscilla attorno a un perno, tirata verso i denti da una molla. È la contromisura al gioco fra denti stampati, che su un plotter — che inverte direzione a ogni segmento — si tradurrebbe in contorni che non chiudono e tratti sdoppiati
- **Due vincoli a livelli diversi**: il carrello è catturato dalla guida e non può sollevarsi, il motore resta libero di flottare sul carrello. I due vincoli agiscono su corpi diversi e non si annullano a vicenda
- **Cuscinetti 608ZZ (8 × 22 × 7) per la pinza sui labbri, MR63 (3 × 6 × 2,5) per la guida laterale.** Supera la scelta dei 623ZZ del 2026-09-25: i 608 erano già in casa, e il profilo reale acquistato ha labbri sporgenti che si prestano a essere pinzati da una ruota sopra e una sotto. Otto 608 (due per stazione, due stazioni per fianco) più quattro MR63 dentro il canale. La pressione di contatto di un 608 a 3 N è 27 MPa contro i 150 a cui cede l'alluminio: margine 5×. Impostazione precedente, mantenuta come principio: cuscinetti 623ZZ (3 × 10 × 4) che rotolano su guide metalliche, non cuscinetti lineari su barre tonde. Il diametro è scelto sulla pressione di contatto: a 3 N un Ø10 preme sull'alluminio con 53 MPa contro i 27 di un 608 e gli 86 di un MR62, e l'alluminio cede attorno ai 150. Il foro da 3 mm è M3, **la stessa vite di tutto il resto della macchina** — motore, cremagliera, regolazioni. Le superfici di rotolamento devono essere metallo: l'anello esterno è acciaio temprato e in poche ore scava un solco nella plastica stampata
- **Ruote impilate a coppie, non sfalsate**, possibile perché due Ø10 stanno in 20 mm. La ruota di sopra e quella di sotto pinzano lo stesso punto del canale, quindi la regolazione è diretta invece che a distanza
- **Regolazione con asole M3, non con eccentrici.** Un eccentrico da mezzo millimetro di offset copre un millimetro di corsa; il gioco da recuperare può essere di due o tre. L'asola dà tutta la corsa che serve e usa M3 invece di M8
- **Perni stampati Ø3 per le ruote fisse, viti M3 con tratto liscio per quelle regolabili.** Il conto sul perno stampato dà 5,7 MPa contro i 50 del PLA. Il cuscinetto non deve mai girare sulle creste di un filetto: appoggia su tre punti e balla
- **Un profilo unico a U al posto di due staffe separate.** Le due pareti di un estruso sono parallele per costruzione, mentre due staffe avvitate a mano divergono di qualche decimo lungo la corsa. Questo toglie alla radice il problema dell'iper-vincolo, e sull'asse X rende superflua la regola della guida maestra qui sotto — che resta però valida sull'asse Y, dove le due guide sono per forza pezzi distinti a distanza di 385 mm
- **Una guida comanda, l'altra sostiene** (vale sull'asse Y, dove le guide restano due pezzi separati). La maestra vincola quota verticale, beccheggio, posizione laterale e imbardata; la secondaria vincola solo il rollio e resta libera lateralmente. Due guide montate a mano sul legno non sono mai parallele entro un decimo, e se entrambe vincolassero il laterale quell'errore diventerebbe attrito variabile lungo la corsa — il tipo di errore che non si riesce nemmeno a compensare
- **Un eccentrico per carrello**, sul cuscinetto laterale di contrasto: stampando non si azzecca mai il gioco al primo colpo. Il gioco verticale si regola invece con le asole dei profili superiori, che agiscono su tutta la lunghezza in una volta sola
- **Motore, pignone con cremagliera e cuscinetti occupano bande laterali distinte.** Il corpo del motore è 42 mm e scende quindi 21 mm sotto l'asse, mentre la cremagliera arriva a 15 mm sotto: si sovrappongono in altezza e devono per forza stare affiancati. Circa 110 mm di larghezza complessiva del carrello. Conseguenza: la flangia di fissaggio della cremagliera va su un lato solo, quello opposto al motore
- **Formato A4 in orizzontale**, corsa X ~230 mm (cremagliera da 59 denti, corsa utile ~250) e corsa Y ~317 mm. Supera il formato A5 del 2026-09-21: l'A4 in orizzontale copre l'A4 senza bisogno della corsa X da 317, perché il disegno si ruota di 90° nel software. Il vincolo che teneva la macchina piccola era la massa mobile, e si è rivelato inesistente (tetto 3410 g contro ~1150 stimati). Impostazione precedente: formato massimo A5, corse utili 200 mm su X e 300 mm su Y; un portale corto riduce anche la tendenza del ponte a mettersi di traverso, essendo spinto da un lato solo
- **Ponte in alluminio rigido**: un ponte che non flette non può sbandare
- **Base in compensato da 10 mm, 385 × 455 mm** (acquistata). Rigida e pesante: la massa assorbe le vibrazioni invece di trasmetterle alla penna. Supera l'indicazione precedente dell'MDF da 15-18 mm, scelta prima di sapere cosa si trovasse
- **Ogni millimetro di lunghezza del carrello è un millimetro di corsa in meno**, mentre la larghezza trasversale non costa corsa. Le due dimensioni vanno quindi trattate in modo diverso: stringere in larghezza quanto si vuole, non accorciare lungo la corsa per guadagnare foglio che non serve
- **Pignone modulo 1,5 con 20 denti, tutto stampato in PLA+.** Diametro primitivo 30 mm, 33,95 passi/mm, risoluzione 0,029 mm. La risoluzione non è il fattore limitante — l'errore reale della macchina sarà attorno ai 0,2 mm, dieci volte tanto — quindi quel margine conviene spenderlo in robustezza del dente
- **La compensazione dimensionale sta nello slicer, non nei modelli** (`X-Y contour compensation` a circa −0,10, `hole compensation` a 0). È una proprietà della stampante, non del pezzo: nel modello andrebbe replicata su pignone e cremagliera e si sommerebbe a quella dello slicer
- **Foro sagomato sull'albero, senza grano, da verificare sul campo.** Il calcolo dà 0,6 MPa contro i circa 50 a cui cede il PLA, quindi la coppia non è un problema; i rischi veri sono lo sfilamento assiale e l'arrotondamento dello spigolo del piatto dopo migliaia di inversioni. Verifica prevista: una riga di pennarello che attraversa pignone e albero, controllata dopo un'ora di movimento
- **Cavi mobili da progettare subito**: sette fili fra motore X e servo seguono il carrello per migliaia di cicli, servono catena portacavi o ansa flessibile
- **Motore dell'asse Y sotto la trave, a cavallo dell'anima.** La gabbia del motore è centrata sul piano dell'anima (interno Y da −6,750 a +17,250), quindi il corpo può stare solo sotto il bordo inferiore dell'anima: la quota dell'asse non è un parametro libero, è una conseguenza. Alternative verificate e scartate: **motore sopra il carrello** (costa 44 mm di franco verticale alla macchina, perché il punto più basso passerebbe da −7 a −51 — ma il modulo penna verrebbe più corto, quindi il conto vero è quasi in pari e ha deciso la comodità di attacco del modulo punta); **motore tutto fuori sul lato −Y** con la cremagliera direttamente sotto l'ala, che geometricamente funziona ma porta il baricentro a Y ≈ −37, fuori dalla carreggiata, e l'ala finisce a −42,05 quindi non c'è dove allargare l'appoggio. **Conseguenza accettata: la cremagliera non può stare sull'ala della trave, deve scendere su una base alta ~44 mm**
- **Anti-sollevamento sul bordo inferiore dell'anima, non sotto l'ala.** Due MR63 ad asse Y spingono verso l'alto contro il bordo inferiore dell'anima. Alternativa scartata: una seconda coppia di 608 sotto l'ala, che avrebbe leva migliore (Y −19,45 invece di Y 0) ma cadrebbe esattamente dove scende la cremagliera. Il carico lo giustifica: la forza tangenziale agisce sul punto primitivo a Z −20,881 mentre l'attrito che la contrasta agisce sui 608 a Z 23,500, cioè **44,381 mm di braccio** scaricati sui 60 mm di passo perni — a stallo sono ±5,4 N contro 2,15 N di peso per stazione, e una stazione si stacca
- **Un solo lato dell'asse X motorizzato, l'altro folle.** Il secondo carrello è lo stesso pezzo specchiato a X = 0, con la sede motore predisposta ma vuota. Il conto che ha deciso: con spinta da un solo lato l'estremità libera ritarda della propria deflessione elastica, `EI ≈ 2,6·10⁹ N·mm²` per la sezione a T, e a 0,3 g fa **3÷9 µm con trave da 430** (50÷150 con 1002). Contro i **235 µm di gioco** dell'ingranamento e i **0,83 mrad** di imbardata per carrello: 25÷80 volte meno, e motorizzare il secondo lato non tocca nessuno dei due. E la forza non è mai stata il problema: il pancake dà 8,67 N sul raggio 15,000, cioè **0,86÷1,1 g** di accelerazione disponibile, mentre la configurazione ne chiede 0,02 — **40×** di margine. Se il portale farà fatica sarà sovravincolo o attrito, non coppia. Alternative scartate: un motore con albero di collegamento fra i due lati (squadratura perfetta, meccanica complicata); due motori in serie su un driver (sincronismo garantito ma induttanza doppia); due motori in parallelo (ripartizione di corrente non garantita); due driver con squadratura in firmware (serve un driver libero e una routine). **Da rivedere se:** la spinta a mano sul lato folle varia di più del doppio lungo la corsa (sovravincolo) o è uniformemente oltre ~3 N (precarico dei cuscinetti)
- **Fisso e flottante sul montaggio della trave Y, con i due gradi di libertà in direzioni diverse.** Due staffe che stringono rigidamente le due estremità sovravincolano il portale: il non-parallelismo fra le rotaie diventa precarico, e il sintomo è attrito che cambia lungo la corsa — cioè esattamente quello che farebbe dire "serve il secondo motore". Lato motorizzato = fisso, vincola tutto. Lato folle = **scorrimento lungo l'asse della trave** (permanente, assorbe il non-parallelismo) **più registrazione di squadratura in direzione di corsa** (bloccabile). Le due direzioni non vanno confuse: nel giunto a guance con viti ad asse Y il gioco dei fori Ø4,600 registra in X e in Z, **non** in Y, e Y è la direzione della squadratura — quindi serve l'asola larga con grani laterali sul lato folle
- **La trave Y appoggia sotto l'ala, non sotto l'anima, e il serraggio è nello stesso punto dell'appoggio.** Le viti stanno nell'ala: se si appoggiasse l'anima sul piano e si tirasse l'ala in basso con le viti, si piegherebbe una lamina da 1,500 proprio dove corrono i 608. Corollario costruttivo: il piano che porta le nervature sta **0,500 sotto** il fondo dell'anima, perché non deve toccare — due appoggi in serie dovrebbero essere complanari e non lo saranno
- **Il vuoto dietro al motore si chiude, non si riempie di niente — e il motore si cambia smontando la trave.** Scelta fra accessibilità e piano d'appoggio: il piano lavora ogni secondo che la macchina gira, il motore si cambia forse una volta in due anni. Supera l'indicazione data poche ore prima di tenere il vuoto libero come via d'uscita del motore, che era incompatibile con il piano d'appoggio. Nota tecnica che smonta mezzo argomento: su un pezzo stampato **lo slicer svuota comunque**, quindi un blocco modellato pieno a 15% di infill fa ~37 g contro i ~35 di una scatola progettata a pareti da 4 mm. Il cuneo autoportante a ~27° dalla verticale che è stato scelto è meglio di entrambi: nessun ponte da stampare, materiale dove c'è il momento
- **Formato: ~242 × 256 mm, A4 rinviato.** Le cremagliere stampate danno 242,475 (X, 59 denti) e 256,613 (Y, 62 denti) di corsa. L'**area** è quella di un A4 (62.100 contro 62.370 mm²) ma la **forma** è quadrata, quindi il lato da 297 non entra su nessuno dei due assi. E non entrerebbe nemmeno rifacendo le cremagliere finché si vogliono in un pezzo solo: il piatto da 256 in diagonale (`a + b ≤ 362,04`) ammette al massimo 292,8 di corsa in Y e 281,6 in X. **Per un A4 vero serve una cremagliera giuntata**, con il gradino di passo alla giunzione che si era deciso di evitare. Da rivedere se: il formato A4 diventa un requisito invece di un desiderio

**Criterio di completamento:** gioco misurato sotto 0,1 mm e `steps_per_mm` tarato sulla macchina reale

**Note (cronologia dello step):**
- [2026-09-21] Definito il metodo di taratura in loco, da usare a struttura montata: muovere quasi tutta la corsa (non 100 mm: l'errore di misura è sempre mezzo millimetro, quindi più lunga è la corsa più la taratura è precisa), misurare lo **spostamento del carrello** con un calibro e non la lunghezza della linea disegnata, e partire sempre nello stesso verso per non includere il gioco nella misura. Formula: `nuovi passi/mm = vecchi × comandata / misurata`
- [2026-09-21] Definita la misura del gioco: comandare +200 mm, poi −200 mm, e misurare di quanto il carrello non è tornato al punto di partenza. Sotto 0,1 mm il precarico funziona, sopra 0,3 mm va ristudiato prima di procedere
- [2026-09-24] **Primo pignone stampato e provato.** Foro sagomato disegnato con 0,2 mm di gioco: "entra a fatica ma entra", che è il risultato voluto. Stampata anche la versione a doppia elica: la dentatura è venuta pulita, quindi la stampante regge il modulo 1,5
- [2026-09-24] **Bilancio dell'errore atteso** con questa costruzione: ripetibilità ±0,1÷0,2 mm, precisione assoluta ±0,3÷0,5 mm dopo la taratura. Sotto i due decimi tutto sparisce dentro la larghezza del tratto di un pennarello. L'errore più insidioso non è il gioco ma **l'ortogonalità fra i due assi**: mezzo grado fa 1,3 mm di sbieco sull'angolo di un A5, più di tutti gli altri messi insieme. Si misura confrontando le diagonali di un quadrato disegnato, e il residuo si compensa via software
- [2026-09-24] Segmenti delle cremagliere fissati: asse X un pezzo da 53 denti (249,76 mm) in diagonale sul piatto, asse Y due pezzi da 37 denti (174,36 mm) dritti. Ogni segmento è un multiplo esatto del passo con il primo dente a mezzo passo dall'estremità, così il passo si mantiene attraverso il giunto
- [2026-09-24] Fissaggio della cremagliera: **un solo foro tondo al centro dell'intera cremagliera, asole dappertutto altrove**, una ogni 50 mm alternate sui due lati. Il PLA si dilata tre volte più del legno e su 350 mm cresce di oltre tre decimi: bloccato rigidamente in più punti si inarcherebbe, cambiando l'interasse col pignone nel mezzo della corsa
- [2026-09-24] Geometria del carrello ancora aperta: l'utente ha proposto due staffe a T affacciate avvitate al legno, con il carrello stampato in mezzo. Da chiarire se i cuscinetti appoggiano sull'ala orizzontale o sul gambo verticale. Problema già individuato: le staffe avvitate solo al piede sono mensole che flettono sotto il precarico, che inverte verso a ogni cambio di direzione — rimedio previsto, viti ogni 40-50 mm più un dorso stampato dietro la gamba verticale
- [2026-09-25] **Materiali acquistati**, e il progetto si adatta a quello che si trova in ferramenta invece del contrario: base in compensato 385 × 455 × 10; viti M3 da 10, 16 e 25 mm **con tratto liscio sotto la testa** (indispensabile per i perni dei cuscinetti); angolare forato 23,5 × 23,5 × 1,5; profilo a U 67,5 × 23,5 × 1,5
- [2026-09-25] **Il profilo a U più due angolari formano il canale chiuso già progettato**, con misure che coincidono: interno 64,5 × 22 mm, e due ruote Ø10 impilate ne occupano 20, lasciando 2 mm da recuperare con le asole. Gli angolari bullonati sopra le ali, flangia verso l'interno, lasciano una fessura centrale di 20,5 mm per il collo del carrello. Quattro superfici di rotolamento in due pezzi comprati
- [2026-09-25] **Verifica delle corse sulla base reale**: con un carrello da 90 mm restano circa 325 mm di corsa in Y e 230 in X, contro i 260 × 200 che servono per un A5 con margine. Circa 65 mm di margine in Y — abbastanza da permettersi un carrello fino a 150 mm senza perdere foglio
- [2026-09-25] Geometria del carrello X definita: il carrello abbraccia **una guida centrale sola**, che va bene perché il profilo è largo 67,5 mm. Sull'asse Y non funzionerà: il ponte è largo 385 mm e su una guida sola si metterebbe di traverso
- [2026-09-25] Da verificare con una calamita: i profili sono acciaio o alluminio. Un metro di quel profilo pesa 1,35 kg in acciaio contro 465 g in alluminio, e sul ponte mobile dell'asse X quel peso lo muove il motore a ogni riga
- [2026-09-25] **La guida va rialzata dal pannello**, scoperto disegnando il CAD: le ruote inferiori sporgono sotto il profilo, quindi con la guida appoggiata direttamente al legno striscerebbero sul pannello. Serve un distanziale continuo sotto tutta la guida — non blocchetti isolati, perché il profilo da 1,5 mm flette fra un appoggio e l'altro sotto il precarico
- [2026-09-25] **Conseguenza da non dimenticare: il rialzo della guida alza tutto.** Il carrello sale, quindi sale l'asse del motore, quindi la cremagliera deve salire dello stesso identico valore perché il pignone continui a ingranare. La relazione resta `fondo cremagliera = asse motore − 26,875`: se si rialza la guida di 5 mm e ci si dimentica della cremagliera, il pignone non tocca più i denti
- [2026-09-25] Il rialzo va misurato, non stimato per eccesso: ogni millimetro in più allontana la penna dal piano delle ruote e amplifica l'errore di beccheggio e rollio di circa l'1% al millimetro. Regola: sporgenza reale delle ruote più 2 mm di franco
- [2026-09-26] **Sezione reale del binario ricavata dallo STEP**, e non è un U come si pensava: è un profilo a cappello, 66,4 largo × 23,2 alto, scatola centrale 23,7, canale interno 20,0 × 21,9, fondo e labbri 1,3 mm, pareti 1,85. I labbri sporgono in fuori da X 11,85 a 33,2: sono loro la superficie di rotolamento, pinzata fra un 608 sopra e uno sotto
- [2026-09-26] **Architettura del carrello: U rovesciata che cavalca il binario.** Due fianchi verticali da 3 mm fuori dal binario (X ±35 ÷ ±38, con 1,8 mm di aria dal bordo del labbro), perni Ø8,1 con collare Ø10,1 che puntano verso l'interno, e un ponte a Z ≈ 52 che lega i fianchi al blocco centrale. Verificato sullo STEP: i fianchi sono piastre **continue su tutti gli 80 mm** da Z 10,8 a Z 34,2, quindi l'anello di forza fra perno basso e perno alto sta interamente dentro un unico pezzo di materiale, e le due stazioni sono legate rigidamente
- [2026-09-26] **L'ordine dei pezzi lungo l'asse del motore è obbligato:** corpo motore → flangia → pignone → cremagliera. L'albero esce dal lato flangia, quindi mettendo il motore fuori dai cuscinetti il pignone finirebbe dentro, dove c'è il binario. Conseguenza: il corpo del motore deve stare verso l'interno, cioè sopra il carrello, e questo fissa l'altezza minima dell'asse
- [2026-09-26] **Interasse dei 608 a 23,40 mm** (labbro 1,3 + due raggi da 11 = 23,30), cioè 0,10 mm di gioco nella pinza. Validato: mezzo carrello scorre su tutta la lunghezza in entrambi i versi. Da rifare con il carrello completo, perché con entrambi i lati montati conta la complanarità dei due labbri lungo la corsa
- [2026-09-26] **Doppia elica a 30° su pignone e cremagliera, confermata funzionante.** Verificate sullo STEP la compatibilità geometrica (stesso modulo trasversale, stesso angolo, apice a metà fascia su entrambi) e la dentatura (spessore in testa 1,065 e vano al piede 1,191 sulla cremagliera, spessore su primitiva 2,3562 nominale sul pignone: gioco totale 0,20 tutto sulla cremagliera). Prezzo della doppia elica: il pignone va centrato sull'apice della cremagliera entro **±0,17 mm**, contro i ±2 mm che darebbero i denti retti
- [2026-09-26] **Il pignone non ha vite di fermo, e va bene così.** L'accoppiamento a pressione è talmente serrato che per smontare la prova sono serviti morsetti concatenati. La vite serviva a poter *regolare* la posizione assiale per il centraggio della doppia elica, ma quella regolazione si è spostata sulla cremagliera. Da ricontrollare fra qualche settimana di funzionamento, perché il PLA sotto tensione circonferenziale si rilassa; il sintomo di uno slittamento è un disegno progressivamente sfalsato senza alcun errore segnalato
- [2026-09-26] **Alzare il piano del foglio è la leva più efficace di tutto il progetto**, non un dettaglio ergonomico. Con 0,10 mm di gioco su 60 mm di interasse ruote l'inclinazione è 1,67 mrad, e l'errore sulla punta scala linearmente con l'altezza della penna: 0,250 mm a 150 mm di sbalzo, 0,117 a 70 mm. La risoluzione della trasmissione è 0,029 mm, quindi a 150 mm l'errore geometrico è otto volte la risoluzione. Vincolo: il carrello spazza una striscia larga ±38 mm attorno all'asse del binario da Z 2,7 a Z 74, e il piano non può entrare in quel volume
- [2026-09-26] Metodo per misurare l'attrito, da usare come metrica di qualità confrontabile: cercare l'**angolo minimo a cui il carrello si muove da solo** sul binario inclinato. La tangente è il μ effettivo — 5° = 0,09 (buono), 30° = 0,58 (qualcosa striscia). Con 1,5 kg in movimento, μ 0,09 costa 20 N·mm al pignone e μ 0,58 ne costa 130, su un NEMA 17 che alle velocità di lavoro ne dà 150÷200 utili
- [2026-09-26] **Dati reali del motore** (17HS4023 iMetrx, etichetta): coppia di tenuta **130 mN·m**, corrente nominale **1,0 A/fase**, resistenza **~4,0 Ω/fase** (4,1 V a 1,0 A), peso **204 g**. È un pancake 42 × 42 × **23 mm**, non un NEMA 17 standard: circa **un terzo** della coppia di un 40 mm
- [2026-09-26] **Corrente, calore e coppia sono la stessa manopola.** La coppia scala con la corrente; la corrente che si può dare la decide il PLA della culla. Con P = 2·I²·R sui 74 cm² di superficie del motore, e tenuto conto che la culla come disegnata copre il **51%** di quella superficie: a 0,6 A la carcassa sta a **74 °C con la culla piena** e a **58 °C con la culla alleggerita**. Alleggerire la culla (nervature invece di superfici piene sul fondo e sui due fianchi) vale quindi **0,1 A di corrente in più, cioè il 13% di coppia** — non è rifinitura
- [2026-09-26] **Bilancio di coppia al punto di lavoro** (0,6 A, culla alleggerita): coppia 78 mN·m, e con il fattore 0,85 per la caduta a 21 giri/min su un raggio primitivo di 15 mm restano **4,42 N alla cremagliera**. Togliendo la quota per accelerare, l'angolo di distacco ammesso è 14° a 1,3 kg e 10° a 1,6 kg; **il target con margine 2× è sotto i 7°**. Il fattore 2 non è pignoleria: senza encoder una perdita di passo non viene segnalata da nulla e il disegno esce sbagliato da lì in poi
- [2026-09-26] **Leve in riserva se la coppia risulta stretta**, in ordine di convenienza: (1) togliere massa, che agisce su entrambi i termini; (2) accelerazione da 1000 a 400 mm/s², che restituisce 0,9 N di budget attrito e si paga solo in tempo; (3) pignone z17 invece di z20 — **+18% di forza e risoluzione da 33,95 a 39,9 passi/mm, con la stessa cremagliera** perché dipende solo dal modulo, al costo di rifare la catena delle quote (l'asse scende di 2,25 mm); (4) motore da 40 mm, che triplica la coppia per ~10 € e +140 g
- [2026-09-26] **La massa punisce due volte** (aumenta insieme l'attrito e la forza per accelerare), quindi il test della calamita sui profili pesa più di quanto sembri: la trave da 385 mm vale 174 g in alluminio contro 506 in acciaio, cioè **circa due gradi** di angolo ammesso in meno

- [2026-09-27] **Carrello X completo misurato:** angolo di distacco ~10°, moto costante su tutta la corsa ~15°, massa 290 g. Tradotto in forza sono **0,50 N e 0,76 N** contro i 4,42 N disponibili al pignone: margine 5,8×. Il μ apparente di 0,27 non descrive un attrito grande, descrive un attrito piccolo diviso per un peso ancora più piccolo
- [2026-09-27] **Il drag è attrito interno dei cuscinetti, quindi costante e non proporzionale al carico.** Otto 608ZZ con coppia di spunto 0,3÷1,0 mN·m su raggio 11 danno 0,25÷0,83 N, che copre esattamente il misurato. Conseguenza operativa: **caricando il portale il μ effettivo scende**, perché il numeratore resta fermo e il denominatore cresce. A 1,1 kg totali il μ scende da 0,27 a ~0,082
- [2026-09-27] **Test della calamita fatto: i profili NON sono magnetici, quindi alluminio.** 452 g/m sulla sezione a cappello (167 mm²), contro i 1314 g/m che avrebbe l'acciaio. Chiude il punto aperto dal 2026-09-25
- [2026-09-27] **Il tetto di massa mobile non è più un vincolo di progetto.** Con drag da rotolamento (μ 0,05) il tetto è 3410 g a 0,6 A contro i ~1150 g stimati per la macchina completa. Fra il formato più piccolo e il più grande in tabella ballavano 84 g: la massa ha smesso di essere il criterio di scelta del formato
- [2026-09-27] **Cremagliera v2 controllata sullo STEP, tre difetti trovati e corretti in v3.** (a) Due fori Ø8 passanti dall'alto tagliavano la dentatura fino in testa: a Y=0 mancavano due denti interi a X≈14 (salto di 11,551 invece di 4,712) e uno a X≈256, con la fascia portante che crollava da 17,32 a 9,32 mm; (b) restavano due schegge di dente spesse **0,030 mm**, sotto la larghezza dell'ugello, che sarebbero diventate bave dentro un vano; (c) il Ø2,5 passante avrebbe autofilettato nel PLA impedendo il serraggio, e il cono si apriva solo a Ø4,5, troppo poco per una testa svasata M3
- [2026-09-27] **Cremagliera v3 verificata pulita:** 59 denti, tutti spessi 2,1562 sulla primitiva, tutti i passi 4,7124, nessuna anomalia. Profilo confermato al centesimo a sette altezze (testa 1,0643, primitiva 2,1562, piede 3,5211, pendenza fianco 2·tan20° = 0,728). **Chevron simmetrico a ogni altezza di fascia**: le coppie ±Y danno posizioni identiche fino all'ultima cifra. Lunghezza 284,223 = 60,314 passi, avanzo 1,480 — da portare a **282,743** (60 passi esatti) perché il pezzo resti giuntabile in futuro
- [2026-09-27] **Il rettangolo ruotato a 45° sul piatto è davvero l'ottimo**, verificato: con piatto 256 e larghezza 60 il massimo è 302,04 mm esatti a 45°. Dettaglio controintuitivo da ricordare allo slicer: **ruotare poco peggiora**, fra 5° e 25° l'ingombro ammesso scende sotto i 256 mm che si avrebbero a 0°. O si va a 45 o non si ruota
- [2026-09-27] **Il riempimento non raggiunge mai i denti.** Con ugello 0,4 e 4 perimetri il dente è pieno ovunque (2,52 mm di pareti contro 2,156 di spessore sulla primitiva). Il pattern influenza solo la soletta, che regge 4,4 N su 11 viti: la scelta va fatta sulla **stabilità dimensionale**, non sulla resistenza
- [2026-09-27] **Altezza del pignone ricavata dal carrello:** i fori NEMA sono a Z 58,650 con interasse 31,00 verificato, quindi **asse pignone Z 74,150**, primitiva cremagliera Z 59,150, faccia inferiore della cremagliera Z 47,275. Equazione di vincolo della catena verticale: **D = t_binario + 59,150 − t_cremagliera**, dove D è la distanza dalla faccia inferiore della cremagliera alla primitiva (oggi 11,875). Da confermare sul pezzo reale: l'asse del motore deve venire a filo del cielo del carrello, che in CAD sta a Z 74,159
- [2026-09-27] **La catena delle quote non chiude sui nominali, e va chiusa in montaggio.** Sensibilità: 1 mm di errore in altezza = 0,728 mm di gioco, quindi il budget è ±0,275 mm. Le tolleranze reali sommano ±0,60 mm col multistrato e ±0,89 col massello — due e tre volte il budget. I contributi: taglio del legno ±0,30, **planarità del riporto su 284 mm ±0,50**, movimento stagionale ±0,05 (multistrato di costa) contro ±0,66 (massello di costa), stampa ±0,10, alluminio ±0,10
- [2026-09-27] **Il regolatore della catena verticale sono i fori Ø4,0 del motore con viti M3**: ±0,5 mm di gioco radiale, cioè ±0,364 mm di gioco d'ingranamento. Basta ad assorbire tutto quello che resta dopo aver misurato il legno
- [2026-09-27] **Architettura dell'asse Y aperta.** Frequenze proprie della trave da 437 mm con 430 g al centro: **145 Hz in verticale, 388 Hz in orizzontale** (la direzione di corsa è quella larga del profilo). Freccia 0,013 mm, e comunque **la freccia non tocca l'ingranamento** perché cremagliera e pignone stanno entrambi sulla trave e scendono insieme. La rigidezza non è un criterio di scelta del profilo
- [2026-09-27] **Il piano di simmetria della sezione azzera due errori su tre.** Con penna e pignone sull'asse dell'anima, l'imbardata non sposta la punta (una rotazione non muove ciò che sta sull'asse) e la torsione è nulla per definizione (forza sul piano di simmetria). Fuori asse si paga doppio: a 150 mm di offset sono 0,250 mm di imbardata **più** 0,209 di torsione della trave, contro uno spessore di tratto di 0,3÷0,5 mm
- [2026-09-27] **Il motore non deve contendere lo spazio alla penna nella sezione: può essere sfalsato lungo la corsa.** In sezione si sovrappongono, in pianta stanno a 40÷60 mm di distanza. Così penna, pignone e cremagliera restano tutti sul piano di simmetria
- [2026-09-27] **Un perno stampato non si può ingrossare fra due cuscinetti coassiali**, perché il cuscinetto interno si infila dalla punta e non passerebbe. La soluzione è quella già usata sull'asse X: **due tronchetti contrapposti**, uno per cuscinetto, radicati ciascuno nella propria parete. Lunghezza 8÷10 mm invece di 30, e la freccia scende col cubo: da 0,0149 a 0,0004 mm. Se invece il perno deve restare passante, va tenuto Ø8 pieno e **appoggiato a entrambe le pareti** (0,0009 mm contro 0,0149 a sbalzo, 16× in rigidezza e 4× in resistenza)
- [2026-09-27] **La resistenza dei perni stampati non è mai stata il problema:** un Ø8 a sbalzo su 30 mm rompe a 84 N e ne porta 1, coefficiente 84×. Il motivo per irrigidirli è lo **scorrimento viscoso**: il PLA sotto carico permanente triplica la freccia in un anno, quindi 0,045 mm che si presentano da soli come gioco sul labbro
- [2026-09-27] **Il profilo a cappello dell'asse X non è riutilizzabile sull'asse Y** con la conformazione scelta: è una C con le punte che formano un pezzo esterno, e i cuscinetti non possono fare il giro necessario. Cade l'ipotesi di riusare lo stesso profilo su entrambi gli assi
- [2026-09-28] **Trave Y comprata e misurata sullo STEP.** Alluminio, sezione a T asimmetrica: ala **67,100 × 1,500** (bordi a Y −42,050 e +25,050, quindi 42 mm di ala da un lato dell'anima e 25 dall'altro), anima **3,100** centrata su Y 0, altezza totale **23,500**. Due bande asolate sull'ala, a Y 11,05…15,65 e −11,75…−7,15, larghe 4,6 e piene all'82%
- [2026-09-28] **La prima cosa da verificare su un profilo asolato è dove passano i cuscinetti.** Le piste scelte (Y 18,05…25,05 e −22,95…−15,95) cadono fuori dalle bande asolate con 2,40 e 4,20 mm di margine: un 608 che passa sopra un'asola non fa rumore, fa un salto di quota che la penna disegna. Verificato anche il contrario, che serve per l'anti-sollevamento: il piano Z 0,000 della trave misura 3106,2 mm² su 1002 di lunghezza, cioè **1002 × 3,100 esatti — il bordo inferiore dell'anima è continuo, nessuna asola lo interrompe**
- [2026-09-29] **Schema di guida del carrello Y:** quattro 608 che *appoggiano* sul piano superiore dell'ala (non pinzati), due 608 sotto l'ala in anti-sollevamento, quattro MR63 che pinzano l'anima lateralmente. Il carrello poggia, non è precaricato in verticale: è lo schema giusto, e il gioco sui due inferiori non è gioco di scorrimento ma corsa prima che l'anti-sollevamento intervenga. Passo perni 60,000 come sull'asse X, carreggiata 41,000
- [2026-09-29] **Il perno superiore lungo non era un problema.** Era la preoccupazione dell'utente: un Ø8 stampato da ~52 mm che porta due cuscinetti. In realtà è appoggiato sul tetto per 29 mm al centro e a sbalzo solo 6,45 e 5,55 alle estremità: **0,26 MPa** contro i ~50 del PLA, freccia 0,0004 mm. Cade l'idea del pezzo centrale avvitato fra i cuscinetti
- [2026-09-29] **Difetto che si ripete di versione in versione: i 608 del lato +Y sono a filo esatto del bordo dell'ala** (Y 18,050…25,050 contro bordo 25,050). Il carrello trasla di 0,10 per lato col gioco dei MR63, quindi in esercizio il cuscinetto sborda e rotola sullo spigolo, che su un estruso è anche la zona con raggio di bordo e bave. La fascia pulita è larga 9,40: la posizione giusta è **17,05…24,05**. Segnalato su prova 1, 2, 3 e 4, mai corretto
- [2026-09-29] **Motore sotto o sopra: il conto non era quello che sembrava.** L'argomento dell'utente ("sopra devo alzare la penna di 5 cm") non regge sui numeri — l'attacco del modulo penna è più basso di soli 13 mm col motore sotto, ma col motore sotto tutta la macchina deve stare 19 mm più alta sulla carta, quindi il modulo penna col motore sopra viene **6 mm più corto**, non 50 più lungo. L'argomento che regge davvero è un altro, ed è migliore: **il corpo del motore è alluminio**, quindi quei millimetri di discesa non li fa un braccio stampato in PLA
- [2026-09-30] **La gabbia a cavallo dell'anima forza la quota del motore.** Interno Y da −6,750 a +17,250: il corpo può vivere solo sotto il bordo inferiore dell'anima, e il bordo superiore del motore finisce 0,35 mm sotto il piatto del carrello. Non c'è margine verso l'alto. Da qui discende tutto il resto: la cremagliera non arriva all'ala e deve scendere fino al pignone
- [2026-09-30] **Pattern dei fori motore sbagliato per tre versioni di fila:** 31,000 × **32,000** su prova 2 e 3, poi 31,000 × **31,450** su prova 4. Il NEMA 17 è 31,000 × 31,000. Con Ø4 su M3 ci sono 0,5 di raggio libero, quindi entra comunque — ma l'errore se lo mangia tutto, e proprio su **Z, che è l'asse dell'interasse**: resti senza registrazione del gioco. Su prova 4 la fila inferiore è esatta (−51,500 = −36,000 − 15,500) e **solo la fila superiore è alta di 0,450**. Il carrello X, controllato per confronto, ha 31,000 esatti: la copia non aveva portato la quota perché il carrello X ha una sola fila di due viti, non quattro
- [2026-09-30] **La doppia elica di cremagliera e pignone aveva mano opposta: non potevano ingranare.** Inseguendo un singolo dente al variare di Y, la cremagliera dà pendenza dX/dY **+0,60** e il pignone **−0,576**: stesso angolo di 30°, ma le punte delle V guardano da parti opposte e le tracce dei denti si incrociano a 60° invece di essere parallele nel punto di contatto. Verifica: 74,1 mm³ di compenetrazione che non scende sotto ~35 né ruotando il pignone, né facendolo rotolare davvero (rotazione + traslazione r·θ), né aumentando l'interasse di 0,8 mm. **La correzione è gratuita: si gira la ruota sottosopra** (essendo simmetrica rispetto al piano di mezzeria, ribaltarla inverte la mano senza spostare nient'altro) e la compenetrazione va a **0,000** con una finestra di gioco di ~0,26 mm. Ruotarla sul mozzo, che era l'istinto, cambia la fase e non la mano
- [2026-09-30] **Correzione di un errore mio sul segno dello 0,1 di aria fra cremagliera e ala.** Avevo scritto che stringendo la cremagliera contro l'ala l'ingranamento si stringe: è il contrario. Denti in giù e pignone sotto, quindi tirandola su l'interasse **aumenta** e il gioco cresce. Il margine di montaggio voluto dall'utente va nel verso giusto
- [2026-09-30] **La cremagliera Y non raggiunge le asole della trave:** il suo piano superiore va da Y −13,822 a −42,278, le asole sono a −11,750…−7,150. Vanno forati fori nuovi nell'ala, e la zona giusta è **Y −28…−38** per tre motivi che coincidono: è oltre Y −24,950 dove finisce il carrello (teste delle viti di qualsiasi altezza, montaggio dall'alto), è oltre Y −22,950 quindi fuori dalla pista dei cuscinetti 5 e 6, ed è oltre Y −27,678 dove finisce la gamba verticale, quindi le cave esagonali per i dadi sono accessibili da sotto
- [2026-10-01] **Prima stampa del carrello Y: si solleva.** Premendo con un dito sul retro del motore il carrello si alzava. Causa: niente teneva giù il lato −Y (i 608 lì sopra solo appoggiano), e qualsiasi forza applicata molto sotto l'ala genera un momento enorme. I numeri dicono che non era una sensazione: a stallo il momento di beccheggio è 324 N·mm, cioè **±5,4 N** contro 2,15 N di peso per stazione — una stazione si stacca. In marcia normale non solleva ma **dimezza il carico** su una stazione, ed è quella cedevolezza che poi esce come isteresi nel disegno
- [2026-10-01] **La nuova catena di tolleranze è il rischio principale aperto.** Il progetto dipende ormai da **tre quote della trave comprata, nessuna misurata**: spessore ala 1,500 (presa 608, gioco progettato 0,100), spessore anima 3,100 (MR63 laterali, 0,050), e la novità, **altezza totale 23,500** (MR63 anti-sollevamento, **gioco 0,000**). Prima la presa verticale lavorava su 1,5 mm di lamiera, adesso lavora su tutta l'altezza del profilo — che per di più è fatto di due profili a L imbullonati, quindi ha anche il problema che **le due gambe devono finire a filo sul bordo inferiore**, altrimenti un cuscinetto da 2,5 corre mezzo a sbalzo su un bordo da 3,1
- [2026-10-01] **Altezza della cremagliera Y fissata dalla catena:** con asse pignone a Z −36,000 e raggio operativo 15,119 (il Ø testa 33,237 dà x = +0,079), la primitiva va a **Z −20,881**, la punta del dente a **−22,381**, il dorso contro l'ala a 22,000 → **altezza totale 44,381**. Cresciuta di 7,3 mm rispetto al layout precedente, conseguenza diretta dell'aver abbassato il motore. La lama alta non preoccupa: la forza tangenziale è nel piano della lama e la doppia elica non genera spinta assiale, quindi non c'è niente che la fletta in Y
- [2026-10-01] **Lunghezza della cremagliera Y: due pezzi identici da 37 passi** (174,359 ciascuno, 348,718 totali, ~322 di corsa utile). In un pezzo solo non ci sta: servirebbero ~343 di dentatura, il piatto a 45° con larghezza 28,456 ne ammette 333,6 teorici e ~300 pratici. A 174 mm si stampano **dritti sul piatto**, niente rotazione a 45°. Due regole per il giunto: ogni pezzo multiplo esatto di 4,7124 tagliato su un confine di dente, e **il passo attraverso il giunto lo deve dare l'incastro fra i due pezzi** (maschio/femmina, stesso file) e non la foratura dell'alluminio, che vale ±0,2
- [2026-10-01] **Gioco e scorrevolezza non sono la stessa cosa, e vanno curati con strumenti diversi.** Dopo la prima stampa i giochi nominali sono stati stretti (608 da 0,150 a 0,100, MR63 laterali da 0,100 a 0,050, anti-sollevamento a 0,000). Tarare su una stampa reale è il metodo giusto, ma 0,050 è **sotto la tolleranza di stampa**: la prossima stampa può uscire con 0,15 di gioco o con 0,05 di interferenza, e in nessuno dei due casi c'è modo di aggiustare. Il rimedio al gioco è la **regolazione** (asole), non un nominale più stretto — che aggiunge precarico su tutta la corsa e lo fa pagare dove il profilo è un po' più spesso, con un punto duro. L'attrito è stato il vincolo del progetto per settimane: non va buttato via per una sensazione al tatto
- [2026-10-02] **Il raggio primitivo del pignone è 15,000, non 15,119: l'errore veniva dal bounding box.** Il Ø di testa letto dal bbox era 33,237, da cui si ricavava una correzione di profilo x = +0,079. Misurando i cilindri veri: **testa Ø33,000** (= 1,5 · (10+1) esatto) e **fondo Ø26,250** (= 1,5 · (10−1,25) esatto), cioè un ingranaggio standard senza alcuna correzione. Lo scarto del bbox è 0,1185 per lato, metà esatta di 33,237 − 33,000: su una dentatura a spina di pesce OCC circoscrive le facce NURBS con margine. Conseguenza: **l'altezza della cremagliera Y passa da 44,381 a 44,500**
- [2026-10-02] **Altezza cremagliera Y verificata in tre modi indipendenti.** (a) Catena di quote riferita all'estradosso dell'ala: `estradosso → asse pignone 59,500` (fissato dal carrello stampato), `asse → primitiva 15,000`, `primitiva → punta 1,500` → `H = 46,000 − t_ala`, cioè **44,500** con t = 1,500. (b) Il gioco di testa che ne risulta viene **0,375 = 0,25·m**, il valore normalizzato, senza averlo imposto. (c) Misura diretta sulla geometria dell'utente: ingranaggio ribaltato messo in presa, scansione di fase su un passo intero e bisezione sui bordi della finestra libera → **gioco 0,226 mm** a interasse teorico, che è lo 0,200 già presente nello spessore del dente (misurato: 2,1562 sulla primitiva contro 2,3562 nominali, passo 4,7124, ripetuto identico su 62 denti). Sensibilità misurata **0,69 mm di gioco per mm di interasse** (teoria 0,728)
- [2026-10-02] **Banda di tolleranza della cremagliera: 44,32 … 44,71**, presa forzata a 44,83. Il margine verso il grippaggio dal nominale è solo **0,33 mm**, e `dH/dt_ala = −1` esatto. La direzione della correzione non è simmetrica: **uno spessore sotto il dorso stringe**, quindi si sbaglia corto e si stringe con spessori da 0,1, mai il contrario — limare il dorso su 174 × 28 tenendolo piano è l'operazione che non si vuole fare. E il ritiro del PLA è la trappola: le due parti ritirano insieme e il modulo si auto-compensa, ma **H è riferita a una trave di alluminio che non ritira**, quindi è l'unica quota del sistema dove il ritiro non si cancella (0,4% su 44,5 = 0,18 mm, tutta la banda)
- [2026-10-02] **Orientamento di stampa della cremagliera:** dorso sul piatto e denti in su, perché in quell'orientamento **non serve nessun supporto** (la flangia parte dal piatto e finisce con la faccia rivolta in alto). Il prezzo è che la scalettatura dei layer sul fianco del dente è `h_layer · tan20°` = **0,073 mm con layer da 0,2**: è il motivo per cui un gioco nominale sotto ~0,15 non può funzionare — sarebbe più piccolo della rugosità geometrica del fianco che lo deve rispettare. Per guadagnare precisione si stampa a layer più fini (0,1 → 0,036), non si stringe l'interasse
- [2026-10-03] **Lo spessore dell'anima non va più misurato.** L'asola da 3,140 del carrello X ha accolto la trave vera, quindi l'anima è 3,10 ± poco. Una delle tre quote mai misurate si chiude per via empirica
- [2026-10-04] **Il difetto dei 608 a filo del bordo d'ala si chiude come non-problema, dopo averlo segnalato quattro volte.** Rifacendo il conto: il gioco laterale degli MR63 è 0,050, quindi nel caso peggiore il cuscinetto sborda di **0,050 su 7,000 di larghezza**, cioè lo 0,7% dell'appoggio, e il contatto di rotolamento è una linea lungo la larghezza. Non succede niente. L'insistenza era sbagliata: la nota del 2026-09-29 sopravvalutava l'effetto perché ragionava sullo spigolo senza rapportarlo al gioco che lo può raggiungere
- [2026-10-05] **L'ingombro del carrello Y lungo la trave è 116,000 per estremità, non 82,5.** Misurato montando i due solidi nello stesso sistema e cercando il primo contatto per bisezione: **px = −78,000**, con zona di contatto X −38,00…−36,00 / Z 81,65…85,93. Il contatto non è fra guance e cuscinetti, è **corpo contro corpo** — il carrello Y è largo 80 mm (±40 dal pignone) e la faccia esterna del carrello X sta a 38 dal suo asse rotaia. La stima precedente contava solo le guance (49,5) e i cuscinetti laterali (33,0) e ignorava le due gabbie motore. È il numero che ha spostato la trave da 430 a 550
- [2026-10-05] **La trave Y va a 550, e la ragione non è solo il minimo.** Corsa utile = `L − 2·116 − 2·g`: a 430 sarebbero 188 (si butterebbero 69 mm di cremagliera già stampata), a 500 esattamente i 256,6 della cremagliera attuale, a **550** la capacità sale a 308 e **ci sta anche la cremagliera Y più lunga stampabile in un pezzo solo** (292,8 di corsa). Costa 29 g di massa mobile in più. Supera le indicazioni di 430 e poi 500 date nella stessa sessione
- [2026-10-06] **Interferenza degli MR63 laterali con la rotaia X confermata sull'assieme reale: 8 × 2,81 mm³, cioè 0,500 di penetrazione per lato.** Zona di contatto X −303,4…−302,9, su entrambi i carrelli X. Il dato che la rende diagnostica: **gli MR63 laterali del carrello Y non interferiscono per niente** — lì il gioco modellato è 0,050 e torna. Quindi è il profilo della rotaia TT nel modello a essere sbagliato (luce interna 20,000 contro perni a ±7,500), non i carrelli, che infatti scorrono
- [2026-10-06] **L'assieme non è affidabile sotto il millimetro sugli accoppiamenti di motori e ingranaggi.** Motore e ingranaggio Y piazzati 0,350 sopra l'asse della sede (asse misurato Z 68,535 contro 68,185 richiesto), ingranaggio X 0,466 sotto. Risultato: l'assieme legge l'interasse Y **0,475 troppo stretto** e quello X 0,343 troppo largo, mentre la macchina vera funziona. Quello che invece è affidabile e torna al micron: la trave appoggia a Z 104,1846 contro un fondo asola calcolato a 104,184, le guance si fermano 1,005 sotto l'intradosso dell'ala, e **l'anima della trave sta a Y −33,531 contro il centro dei carrelli a Y −33,51** — 0,021 mm, centrata come da progetto
- [2026-10-06] **Quote del portale assemblato:** interasse rotaie **473,40** (centri X −313,40 e +160,00), facce esterne dei carrelli a X −351,40 e +198,00 → **trave da esterno a esterno 549,40**. Le due rotaie nel CAD sono **sfalsate di 62,08 mm in Y** (centri a Y +62,08 e 0), da allineare. La cremagliera Y è **decentrata di 25,88**: margini 4,5 da un lato e 56,3 dall'altro invece di 30,4 per parte
- [2026-10-06] **Il piano di base non basta più, e il centro dell'area di disegno non è dove si crede.** `base legno` è 385 × 455 e la **rotaia sx è fuori dal piano di 154 mm**. Serve ~570 × 430 con le rotaie allineate e tagliate a 400. E l'area di disegno è centrata su **X −102,6 / Y −87,9**, non su (0,0): il piano va centrato lì. Quota che serve al modulo penna: il punto più basso del carrello Y sta a **Z 46,68** sopra il piano, quindi il piano carta va a **Z ≈ 44,2** — serve una piattaforma alta 44 mm
- [2026-10-07] **Nomenclatura fissata dall'utente, e da qui in avanti è quella:** **staffa TT** = le due rotaie da 400, **staffa LL** = la trave del portale da 550. Serviva perché le due sessioni usavano vocabolari diversi ("trave a T", "rotaia TT") e in una lista di tagli l'ambiguità si paga
- [2026-10-07] **La base deve ospitare anche l'elettronica, e questo la ridimensiona.** Il vincolo che decide: **fra le due rotaie non ci sta niente di più alto di 46,68 mm**, e il piano carta ne usa già 44,2. L'elettronica non può stare dentro la macchina, va in una fascia dietro le rotaie — dove per contro **non c'è nessun limite di altezza**. Due breadboard da 830 punti affiancate chiedono 130 mm di profondità; l'utente ha poi comprato una tavola **600 × 700**, che ne lascia 190
- [2026-10-09] **I tagli li fa l'utente in proprio, con seghetto a pendolo.** La lama giusta è la **T118G** (passo 0,7), e la ragione è geometrica: la staffa LL è alta 23,5 e larga 67,1, quindi si taglia per forza appoggiata sull'ala, e **per 64 dei 67 mm di taglio la lama attraversa l'ala da 1,500 mm**. A passo 0,7 sono 2,1 denti in presa, con la T118A (1,2) sono 1,25 e con la T118B (2,0) sono 0,75 — sotto il dente, il dente aggancia invece di tagliare e strappa il bordo, che è la pista dei 608. Regole: **pendolo a 0** (nel metallo fa strappo), velocità bassa (l'alluminio ad alta velocità si salda sui denti), lubrificante, legno di sacrificio sotto, morsa sull'anima o sulla scatola mai sulle ali, nastro sotto il pattino per non rigare le piste. **Staffa TT tagliata, risultato dichiarato ottimo**
- [2026-10-11] **L'interasse delle rotaie non è una scelta libera: lo quantizzano i fori della staffa LL.** Il profilo ha **22 fori Ø4,6 nell'anima a passo 25,000 esatto**, e i due fori di serraggio delle guance del carrello X sono distanti **esattamente 25,000**, cioè un passo. Montando entrambi i carrelli **sui due fori più esterni** si ottiene l'interasse massimo possibile, **473,400**, e la staffa da 550 lo copre con 0,600 mm di avanzo totale. Supera l'indicazione data il 2026-10-07 di ricavare l'interasse come `lunghezza trave − 76,0` (che dava 474,0): quella formula ignorava che la posizione dei carrelli è discreta
- [2026-10-11] **Prova_2 contro prova_3: la mossa che ha fatto spazio è stata di 25,000 mm.** Nel prova_2 l'interasse era 448,400 e la trave sbordava di 23,3 mm da un lato; spostando il carrello sinistro di un passo-foro si arriva a 473,400 e la trave viene usata tutta
- [2026-10-11] **Il carrello Y non lo ferma il motore né il pignone: lo ferma lo spigolo interno della cremagliera X.** Misurato per bisezione con booleane, un ostacolo alla volta (il metodo si auto-valida: contro il corpo del carrello X trova il contatto a pignone Y = +82,002, cioè faccia a faccia a X 122,000, che riproduce al centesimo l'A = 116 misurato a ottobre). La cremagliera X è larga **38,660 di base ma solo 17,321 di dentatura**: 21,34 mm di flangia di fissaggio sporgono verso il centro macchina, e sono quelli che mangiano la corsa. Col vecchio riporto in legno il margine a fine corsa era **+3,475** a destra e **+1,714** a sinistra se si motorizza anche quel lato: non un margine, il non-toccarsi
- [2026-10-11] **Cremagliera X v5: il rialzo in legno sparisce dentro il pezzo stampato.** Decisione dell'utente. Il pezzo passa da 13,375 a **68,375 mm di altezza totale** (+55,000 esatti), appoggia direttamente sul legno e la cresta dei denti resta dove stava. 59 denti, passo 4,7124 uniforme, corsa 242,475: la dentatura non si è mossa. Il guadagno non previsto: il piede largo sta **solo nei primi 10 mm**, e sopra la sezione si stringe ai 17,321 della dentatura — ma il carrello Y tocca in una fascia a **Z 46,7÷59**, trentasette millimetri più in alto. Quindi l'ostacolo arretra di **21,339 mm** e i margini diventano **+11,5** e **+9,8**
- [2026-10-11] **Il conto della stampa:** 364,82 cm³ di modello (452 g se fosse pieno, ~150 g con 3 perimetri e infill al 15%, 12÷18 ore). In pianta 283 × 38,7, quindi a 45° fa `a+b = 321,7` contro i 362 ammessi dal piatto: ci sta in un pezzo solo, e c'è il precedente della cremagliera Y che era più lunga. Piede sul piatto e denti in su, nessun supporto
- [2026-10-11] **Due numeri miei da correggere.** (a) L'ingombro del carrello X **lungo la rotaia è 82,000**, non 51: i 51 sono la sola gabbia motore, ma i quattro 608 stanno a passo 60,000 e con Ø22 arrivano a 82. Il taglio a 400 resta giusto, ma la corsa meccanica disponibile è **308** e non 339, e il minimo teorico era 334,5 non 303,5. (b) L'interasse è 473,400 e lo danno i fori, non 474,0 dalla lunghezza della trave
- [2026-10-12] **Il ritiro del PLA ora agisce su 68,375 invece che su 13,375.** Allo 0,3% fa ~0,21 mm contro 0,04, ed è la quota dove il ritiro non si auto-compensa perché è riferita all'alluminio. Ma è **sistematico e in una direzione sola: più basso, cioè gioco più largo**, mai verso il grippaggio — la stessa direzione in cui sbaglia uno spessore sottodimensionato. Aspettarsi di dover spessorare di ~0,2 sotto il piede, e considerarlo normale. In cambio sparisce il termine dominante della vecchia catena: la **planarità del riporto su 284 mm, ±0,50**, che da sola valeva il doppio del budget di ±0,275 — la faccia di riferimento non è più una superficie segata ma il piatto della stampante
- [2026-10-15] **Macchina montata.** Tagliata la staffa LL — l'unico taglio del progetto senza seconda possibilità — e assemblato il portale sulla base. I due assi si muovono dalla dashboard vecchia, le quattro frecce vanno nel verso giusto, la struttura è rigida e i motori non faticano. Il disallineamento delle rotaie è stato **risolto in montaggio**, quindi i 22,9 mm di corsa che costava sono recuperati sulla macchina vera (nell'assieme CAD va ancora riportato)
- [2026-10-15] **Gli assi cambiano nome** per allinearsi alla convenzione del foglio: la trave del portale diventa X, le rotaie di base diventano Y. Vedi le Convenzioni in testa alla Pipeline — e attenzione che tutte le note qui sopra usano i nomi vecchi
- [2026-10-15] **Le misure di taratura sono rinviate al modulo penna, per decisione dell'utente.** Non è un rinvio a vuoto: col modulo penna la taratura si fa disegnando una linea lunga e misurandola, che è una misura di tutta la catena in una volta e per asse, invece di una misura del solo passo della cremagliera. Il metodo col calibro resta scritto e valido in `misure/primo-asse.md` per il giorno in cui servisse separare i contributi

**Problemi aperti su questo step (al 2026-10-15):**
- ~~Profondità del vano motore da verificare~~ — **risolto il 2026-09-26.** Il motore è un **pancake da 23,1 mm**, non un NEMA 17 standard da 34÷48: il vano da 23,5 mm è quindi corretto e le viti posteriori arrivano eccome al coperchio. Resta però **0,4 mm di gioco assiale**, che è più dei ±0,17 mm di tolleranza di centraggio della doppia elica: il motore va messo **in battuta sulla parete anteriore** (che è il riferimento della quota del pignone) con **due rondelle piane M3 da 0,5 mm** fra coperchio posteriore e parete posteriore, così le viti di dietro lo spingono in avanti invece di tirarlo indietro. Resta da verificare la profondità dei fori filettati posteriori (spesso 4÷5 mm) per scegliere la lunghezza delle viti
- ~~Test della calamita sui profili~~ — **risolto il 2026-09-27: alluminio**, 452 g/m. Toglie di mezzo il rischio peggiore sul peso del portale
- ~~Attrito del carrello completo da caratterizzare~~ — **risolto il 2026-09-27.** 10° di distacco, 15° di moto costante, e la causa è attrito interno dei cuscinetti (costante), non strisciamento (proporzionale). Il carrello è accettabile così com'è
- ~~Profilo della trave Y da comprare~~ — **risolto il 2026-09-28.** Trave a T in alluminio, ala 67,100 × 1,500, anima 3,100, altezza 23,500, due bande asolate. Le piste dei cuscinetti cadono fuori dalle asole con 2,40 e 4,20 mm di margine
- ~~Layout del carrello Y da chiudere~~ — **chiuso nella sostanza il 2026-10-01** attraverso quattro iterazioni (prova 1→4): guida, motore sotto a cavallo dell'anima, anti-sollevamento sull'anima, cremagliera sotto l'ala su base alta. Resta aperto il solo **modulo penna**
- ~~Tre quote della trave Y da misurare~~ — **chiuso per via empirica il 2026-10-03.** L'asola da 3,140 del carrello X ha accolto la trave (anima = 3,10 ± poco) e i tre carrelli stampati scorrono sulla trave vera, quindi ala e altezza totale sono confermate dall'uso. Non serve più il calibro
- ~~Verificare la mano dell'elica anche sull'asse X~~ — **risolto il 2026-10-06.** Nell'assieme entrambi gli ingranaggi sono istanze di `Spur gear (20 teeth)-Mirrored`: la correzione è applicata su tutti e due gli assi
- ~~Fori motore, fila superiore da Z −20,050 a −20,500~~ — **accettato come è il 2026-10-05.** L'utente ha stampato e montato: le viti entrano, perché i 0,500 di scarto stanno esattamente dentro il gioco Ø4,000 su M3. Segnalato tre volte, la prova fisica batte la misura sul CAD per la domanda "ci entra". Resta vero che la flangia motore si carica di sbieco e che il gioco di registrazione è esaurito, ma non è un difetto che blocca
- ~~I 608 del lato +Y a filo del bordo d'ala~~ — **ritirato il 2026-10-04: non era un problema.** Con 0,050 di gioco laterale il cuscinetto sborda di 0,050 su 7,000 di larghezza, lo 0,7% dell'appoggio. Segnalato quattro volte a torto
- ~~Cremagliera Y da disegnare~~ — **risolta e stampata il 2026-10-02**, gioco dichiarato ottimo dall'utente. 62 denti, 289,613 di dentatura, 297,360 di pezzo, in **un pezzo solo** a 45° sul piatto (niente giunto, quindi nessun gradino di passo). Dodici asole 4,600 × 7,300 elongate in Y per la registrazione del parallelismo
- ~~Interferenza cremagliera / fianco del carrello X~~ — **risolto il 2026-10-06**: il carrello X v2 è stampato e funzionante, e le booleane sull'assieme non trovano contatti in quella zona
- ~~Gioco della pinza con il carrello X completo~~ — **risolto il 2026-10-06**: i tre carrelli sono assemblati e scorrono bene
- ~~Quanto alzare il piano del foglio~~ — **risolto il 2026-10-06: Z ≈ 44,2 sopra il piano di base**, perché il punto più basso del carrello Y sta a Z 46,68. Serve una piattaforma alta 44 mm
- ~~PRIORITÀ: misurare col calibro la luce interna fra le due anime della rotaia X. È l'unica misura rimasta e blocca la squadratura del portale. Nel modello è 20,000 con i perni MR63 a ±7,500, cioè 0,500 di interferenza per lato su otto cuscinetti — e i carrelli invece scorrono, quindi il modello è sbagliato. Quel numero è il gioco laterale dell'asse X, e il gioco laterale è l'imbardata del portale: 0,05 → 0,83 mrad → 0,18 mm all'estremità di una trave da 550; 0,5 → 8,3 mrad → 1,8 mm. Va saputo prima di squadrare, non dopo~~ — **chiuso il 2026-10-12, e non come previsto.** La luce da 20,000 è la **quota ufficiale del profilo**: l'informazione è arrivata dall'utente, non dal calibro. Le otto interferenze da 2,81 mm³ nell'assieme hanno quindi una spiegazione sola — nel CAD c'è ancora il **carrello della prima versione**, mentre quello stampato ha i perni MR63 già spostati sulla base delle prime prove. Il ragionamento ("i carrelli scorrono, quindi il modello è sbagliato") era giusto, il colpevole no: era il pezzo che si era mosso, non la rotaia. Resta da registrare **di quanto** sono stati spostati i perni, perché quel numero è il gioco laterale e quindi l'imbardata del portale
- ~~Lista tagli da eseguire (fuori casa, non ci sono gli attrezzi): trave Y a T 1 × 550, rotaia X a TT 2 × 400, tolleranza ±0,5. Avanzi da conservare: 452 mm di trave (una seconda trave intera) e 600 di rotaia. Specificare a chi taglia: stringere in morsa sull'anima per la T e sulla scatola per la TT, mai sulle ali (sono le piste dei 608); lama a denti fini o troncatrice da alluminio, niente flessibile; sbavare i quattro spigoli di ogni taglio, che è l'operazione più importante del lavoro. E non usare le facce di taglio come riferimento: segnare la posizione dei carrelli misurando dal centro della trave~~ — **superata il 2026-10-09: i tagli li fa l'utente.** Comprato un seghetto alternativo a pendolo e quattro lame. **Staffa TT tagliata, risultato ottimo.** Resta da tagliare la staffa LL, rimandata di proposito finché il primo asse non si muove: dalla stecca da 1002 restano 452 mm, meno di un secondo pezzo, quindi è l'unico taglio del progetto senza seconda possibilità
- ~~Piano di base da rifare: circa 570 × 430, centrato su X −102,6 / Y −87,9. Quello attuale è 385 × 455 e la rotaia sx ne sta fuori di 154 mm~~ — **chiuso il 2026-10-12: comprata una tavola 600 × 700**, che copre anche la fascia per l'elettronica. Il layout quotato è nelle note dello step
- **Tre correzioni nell'assieme CAD** prima di ricavarne altre quote: allineare le due rotaie in Y (−62,08 sulla sx), spostare la cremagliera Y di **+25,88** per bilanciare i margini, riaccoppiare motori e ingranaggi sulle loro sedi (oggi sono fuori di 0,15÷0,47 e falsano tutti i numeri di ingranamento)
- **Quale altezza ha la cremagliera Y stampata, 44,500 o 44,625?** Nell'assieme misura 44,625, cioè 0,100 in meno di quanto era stato togliuto invece di 0,225. A 44,625 il gioco è **0,140** invece di 0,226: funziona, ma è sul lato stretto per una coppia stampata dove la scalettatura dei layer sul fianco è già 0,073
- **Carrello X sinistro: specchiare non basta.** Il mirror a X = 0 è la trasformazione giusta (tutto quello che tocca la rotaia è simmetrico, cambiano lato solo vano motore e guance), ma il sinistro deve essere il **lato flottante**: asola dell'anima a **4,500 con due grani M3 di registro laterale per guancia** (±0,700 in Y = la squadratura) e **fori di serraggio asolati in X a 4,600 × 8,000** (lo scorrimento che assorbe il non-parallelismo). Con fori tondi su entrambi i lati si torna a sovravincolare
- **Secondo canale servo da riservare nel fascio cavi adesso.** Tirare un filo in più oggi è gratis, farlo passare dopo in una catena portacavi montata no. Lo chiederà il modulo taglierino
- **Parallelismo cremagliera-binario entro 0,17 mm su tutta la corsa** (conseguenza della doppia elica). Va allineata **al binario**, non al bordo della base: far scorrere il carrello e controllare la distanza pignone-apice in quattro o cinque punti prima di fissare. Sintomo di errore: scorre bene in mezzo e si irrigidisce verso le estremità
- **Piano B se il riporto della cremagliera X esce storto:** buttarlo e appendere la cremagliera a staffe stampate fissate al binario. Vantaggio concettuale: la cremagliera verrebbe riferita allo stesso pezzo su cui corre il pignone, invece che al tavolo
- ~~PRIORITÀ: le tre misure del primo test di movimento~~ — **rinviate per decisione dell'utente il 2026-10-15**, dopo il modulo penna, quando si potranno fare disegnando. La procedura resta in `misure/primo-asse.md`, aggiornata due volte: i 6400 impulsi non si misurano con un calibro da 150, e il passo si ricava a perni (due tondini identici nelle cave, `p = (R30 - R10)/20`, dove il diametro del perno si cancella nella sottrazione). Il gioco, provato a mano a montaggio fatto, è risultato "quasi zero" — resta da quantificarlo
- **Corsa utile reale di ciascun asse, da fermo a fermo.** Basta il metro, ±1 mm. Oggi in `cnc2d-config.yaml` c'è `max_travel_mm: 300.000` su entrambi, con scritto "DA TARARE"
- **Due passi/mm, uno per asse.** Le due cremagliere si sono ritirate di quantità diverse: un valore solo fa uscire i quadrati rettangoli. Da misurare per asse e da separare nel firmware della dashboard, che oggi ne ha uno globale
- ~~La quota a cui è stata tagliata la staffa LL non è registrata~~ — **chiuso il 2026-10-15: 550 mm**, la quota di progetto, senza scarti. Dalla stecca da 1002 restano 452 mm di avanzo
- **Il config di FluidNC non è mai stato provato** sulla macchina montata. Contiene ancora `steps_per_mm: 80.000` (residuo dell'ipotesi a cinghia: sbaglia di 2,36 volte), nessun blocco `homing:`, e i due assi sono stati rinominati il 2026-10-15 senza poterli verificare
- ~~Il reticolo dei fori motore è 31,0000 × 31,4500 invece di 31 quadrato~~ — **chiuso dall'utente il 2026-10-16: non è un errore, è una quota del progetto.** Ha stampato e avvitato con questo reticolo più volte e le viti entrano sempre, perché il gioco Ø4 su M3 vale 0,500 e lo scarto 0,450. E siccome *tutti* i pezzi del progetto portano lo stesso scarto, sono coerenti fra loro. Resta vero solo che la registrazione con le viti è esaurita, quindi l'offset utensile andrà misurato e non registrato — cosa che comunque va fatta
- **Aggiornare il carrello X nell'assieme CAD con la versione stampata.** Finché c'è quello vecchio, ogni controllo di interferenza ripesca le stesse otto collisioni finte degli MR63 — e una vera ci si nasconde dentro
- ~~Le due rotaie nell'assieme sono sfalsate di 31,252 mm in Y, e costano 22,9 mm di corsa~~ — **risolto in montaggio il 2026-10-15.** L'utente ha allineato le rotaie sulla macchina vera, quindi i 22,9 mm sono recuperati. Resta da riportare l'allineamento **nell'assieme CAD**, altrimenti ogni quota che se ne ricava è sbagliata di 31 mm
- **Il margine del carrello Y a fine corsa è 11,5 mm a destra e 9,8 a sinistra** con la cremagliera X v5, contro i 3,5 e 1,7 di prima. È accettabile, ma è il numero da ricontrollare quando il modulo penna aggiungerà materiale sul lato basso del carrello: la fascia critica è **Z 46,7÷59**
- **I 12 V di potenza passano ancora per i rail della breadboard**, dati per ~1 A contro i 2 A di picco dei due motori. Va portato su morsetti a vite quando l'elettronica si fissa alla base

### Step 6 — Modulo penna e interfaccia utensili

**Stato:** in corso (CAD in mano all'utente, 2026-10-15) — e ora è il collo di bottiglia di tutto: senza penna la macchina non disegna, e senza disegnare non si tara

**Obiettivo:** la penna si appoggia e si solleva in modo ripetibile, con pressione costante, e il modulo è intercambiabile con altri utensili senza ritarare la macchina

**Decisioni progettuali:**
- **Un solo stadio mobile, nessun giunto a gioco morto: è quello che il CAD ha costruito.** *Supera la decisione del 2026-10-16* ("architettura a due stadi sulla stessa pista, con giunto a gioco morto da 6 mm"), non per un ripensamento ma perché l'architettura a due stadi **non è mai stata messa nel CAD**: dalla `prova_1` alla `prova_4` c'è un solo pezzo mobile (`pz2`, 12 cuscinetti) che porta sia la cremagliera sia i morsetti della penna. Rilevato il 2026-10-17 e confermato dall'utente nella stessa sessione, che descrive la taratura come tre angoli di servo — cioè esattamente la presa rigida. Lo schema `modulo-penna/schema.html` (rev. 2) descrive quindi un modulo che non esiste, e porta ora una nota in testa che lo dice. **Conseguenza principale:** l'unica cedevolezza della catena sono i **0,30 mm di gioco d'ingranamento** della coppia cremagliera/pignone — dentro quei 0,30 mm `pz2` si muove senza che il pignone giri, quindi la penna appoggia col proprio peso. È un gioco morto venti volte più piccolo di quello progettato, ma della stessa natura, ed è la ragione per cui l'angolo di appoggio è tarabile invece che critico al centesimo
- **Denti dritti sul pen-lift, non doppia elica** (deciso dall'utente il 2026-10-17, dopo averla impostata a 40° il 2026-10-16). La motivazione è sua ed è migliore di quella che avevo dato io: **l'ingranaggio è avvitato a un braccetto, quindi la sua quota assiale non è un riferimento** — dipende da quanto a fondo il braccetto va sullo spline, dalla profondità della tasca e da due viti M2 in torrette stampate. I denti dritti danno un **range** su quella quota; l'elica lo converte in errore nel piano di rotazione, cioè direttamente in quota della punta. Il progetto ha già il numero, misurato sugli assi X e Y il 2026-09-26: la doppia elica chiede il centraggio sull'apice entro **±0,17 mm**, i denti dritti entro **±2 mm**. Sugli assi il riferimento assiale esiste (il pignone è piantato a pressione sull'albero, e c'è la nota del 2026-09-26 sul motore in battuta con due rondelle); qui non esiste. *Questa decisione sostituisce il motivo che avevo scritto il 2026-10-16* — "il giunto a gioco morto scollega il pignone dalla punta" — che si appoggiava a un giunto che nel CAD non c'è: la conclusione regge, il ragionamento no
- **La quota di appoggio la dà il servo, in presa rigida nei due versi.** *Supera la decisione del 2026-10-01* ("il servo fa solo il sollevamento, la penna scende per peso proprio e galleggia"), su scelta dell'utente del 2026-10-15: il timore è che la catena non sia abbastanza sciolta perché il peso della penna la porti giù, e la preferenza è dare l'altezza e provare. **Conseguenza meccanica:** il gioco morto di 1,5 mm fra naso del braccetto e linguetta della biella va a zero, e il servo resta in coppia mentre si disegna. **Conseguenza sul software:** l'angolo di appoggio diventa un **valore tarato**, che vive nella tab Impostazioni del GDC CNC 2D SLICER e va regolabile a passo fine con la penna appoggiata sul foglio
- **Il numero da tenere d'occhio con la presa rigida è la risoluzione del servo.** Un SG90/MG90S ha una banda morta di circa 10 µs, che su 2000 µs per 180° fa **circa 1° di granularità**. Con il braccetto da 30 mm dell'architettura del 2026-10-01, 1° vale **0,52 mm** alla punta e l'intera corsa di 4 mm sta in 7,6° di servo: otto posizioni distinte in tutto, troppo poche per regolare l'appoggio di una punta in fibra. Per usare 90° di servo sui 4 mm di corsa il braccetto deve scendere a **~2,5 mm**, e lì a dominare diventa il gioco dei giunti. È il vincolo di progetto vero di questa strada, e va risolto nel CAD prima della stampa, non dopo
- **Mitigazione a costo quasi nullo, se la presa rigida si rivela troppo secca: una molla in serie** fra braccetto del servo e carrello della penna. Il servo continua a dare la quota — che è quello che l'utente vuole — ma l'errore di quota si trasforma in un piccolo errore di forza invece che in punta schiacciata o linea mancante. Con una molla morbida (~0,05 N/mm), mezzo millimetro di errore vale 0,025 N su un appoggio di 0,1÷0,3 N
- **Alternativa accantonata (non scartata): discesa per gravità con servo meccanicamente staccato in appoggio.** Restano validi i tre motivi del 2026-10-01 (carta non piana, nessuna taratura di Z, nessun jitter del servo sulla punta). **Da rivedere se:** la linea esce di spessore diverso secondo il punto del foglio, o se tarare l'angolo di appoggio richiede di rifarlo a ogni cambio di foglio. Nota tecnica per quel giorno: la discesa per gravità **non chiede che il servo sia reversibile** — il servo allontana attivamente il braccetto e il carrello scende da solo — quindi quello che decide è l'attrito della guida e dei giunti, non la scioltezza del servo
- **Parallelogramma articolato, non leva basculante.** Il parallelogramma mantiene la morsa **sempre verticale** (penna di qualunque lunghezza, nessuna spazzata della coda) e con le bielle orizzontali nella posizione di disegno è **insensibile al primo ordine al trascinamento della punta**. Il conto che ha escluso la leva: con pivot 46 mm sopra la punta e braccio 30, l'attrito di trascinamento (0,15÷0,3 N) cambia la forza sulla punta del ±45% **e cambia segno col verso di tracciamento** — linee più marcate in una direzione. Alternative scartate: leva basculante su due MR63 (un solo giunto, gioco quasi nullo, ma la geometria obbliga a una penna da ≤46 mm: resta la scelta giusta se si passa a refill D1 da 67 mm con corsa 2,5); tubi telescopici in ottone Ø6 in Ø8 (la soluzione più elegante e la migliore sul trascinamento, ma l'anima da 5,1 mm accetta un refill, non una penna); slitta su aste con bronzine stampate (il gioco della bronzina va diretto sulla punta e genera isteresi)
- **La geometria è forzata dall'ingombro: l'unica colonna libera a tutte le quote è Y > 36,050.** Mappato lo spazio sul piano YZ al centro del carrello: la faccia +Y è uno smusso a ~30° che va da Y 36,05 a Z −15 fino a Y 20,05 a Z −44. Più dentro il tetto lo mette prima lo smusso, poi la parete, poi il bordo d'ala a Y 25,050. Quindi **asse penna a X −42,500 (centro carrello, dentro l'interasse dei 60 mm) e Y ≈ 44**, appena fuori dalla piastra: la penna sta in aria libera a ogni quota, **la si infila dall'alto** e si vede. Dentro (Y ≈ 23) ci sono solo 82 mm, cioè refill D1 e nient'altro
- **Corsa 4 mm, servo MG90S.** *(La pressione dalla zavorra e il gioco morto da 1,5 mm valgono per l'architettura a gravità del 2026-10-01, accantonata il 2026-10-15: con la presa rigida la pressione la dà la quota imposta dal servo e il gioco morto non c'è.)* Coppia richiesta ~9 N·mm contro i 180÷220 disponibili: 20× di margine, quindi il servo si scegle per gli ingranaggi metallici, non per la coppia. Gioco morto di **1,5 mm** fra naso del braccetto e linguetta della biella: è quello che disaccoppia il servo mentre si disegna. Alimentazione 5 V dedicata (spunto ~700 mA) e **150÷250 ms di pausa in firmware** a ogni su/giù, altrimenti a 50 mm/s si sbavano 4 mm di tratto
- **Il modulo è un'interfaccia per una famiglia di utensili, non un pezzo singolo.** Conseguenza della scelta dell'utente di fare più moduli (pennarelli diversi, in prospettiva un taglierino). Requisito che cambia: l'interfaccia deve essere un **riferimento**, non solo un fissaggio — **due spine Ø3 asimmetriche** che definiscono la posizione, con le viti che fanno solo forza, altrimenti l'offset utensile va rimisurato a ogni cambio. Più **connettore invece di fili saldati** e un secondo canale servo riservato nel fascio
- **La sede dell'utensile permette la rotazione (ritegno assiale sì, blocco in rotazione opzionale).** Così la **lama trascinata** si ha gratis: è offset rispetto al suo asse e si orienta da sola seguendo il percorso, zero assi aggiuntivi. Alternativa scartata per ora: lama tangenziale orientata attivamente, che vuole un asse A vero coordinato con X e Y (un servo non basta — ha 180° e il percorso accumula angolo) e la punta **esattamente** sull'asse di rotazione
- **Offset utensile nel modello dati del firmware adesso, a zero.** La punta non sarà dove è il riferimento del carrello: col modulo previsto sta a ~44 mm in Y. Senza il campo, il giorno in cui si monta la penna tutti i limiti e tutti i disegni si spostano di 44 mm

**Criterio di completamento:** la macchina disegna un quadrato e un cerchio su carta, con tratto di spessore costante nei due versi di tracciamento e senza salti all'appoggio

**Note (cronologia dello step):**
- [2026-10-01] Architettura progettata per intero su richiesta dell'utente, poi **rinviata**: la macchina non disegna senza il secondo appoggio dell'asse X, e senza modulo penna si muove comunque e dà già informazioni. Supera la raccomandazione data poche ore prima di fare il modulo penna **prima** del secondo asse X, che si basava sul fatto che la penna è lo strumento di misura della macchina — argomento valido ma secondario rispetto al fatto che senza appoggio il portale non si può muovere
- [2026-10-06] **Il piano carta è fissato: Z ≈ 44,2 sopra il piano di base**, perché il punto più basso del carrello Y nell'assieme sta a Z 46,68. Serve una piattaforma alta 44 mm. E l'area di disegno è centrata su X −102,6 / Y −87,9, non sul centro della macchina
- [2026-10-12] **Il requisito "alimentazione 5 V dedicata" scritto il 2026-10-01 è stato pagato in anticipo, e male.** Il servo collegato al 5 V condiviso ha mandato in brownout l'ESP32 e tenuto fermo il progetto due giorni. Ora il servo ha il suo regolatore (vedi Step 1): quando il modulo penna arriverà, l'alimentazione è già quella giusta, e il secondo canale per il taglierino si attacca allo stesso ramo
- [2026-10-06] **La precisione della punta dipende dall'altezza, non solo dall'ingombro.** Il rollio del carrello si trasferisce sulla punta con braccio ~83 mm: **1 mrad di rollio = 0,083 mm di errore**. Quindi ogni 10 mm che si alza la carta si guadagna il 12% su quell'errore. Il limite è il fondo della gabbia motore, che ha 4,9 mm di PLA sotto all'ingranaggio: portandolo da −57,5 a −55 si guadagnano 2,5 mm gratis
- [2026-10-15] **L'utente sta disegnando il CAD.** Penna scelta: **Tratto Pen, Ø 10 mm**. Fissaggio con **due morsetti a 30÷40 mm di distanza verticale** — scelta giusta per la rigidezza angolare: anche con un decimo di gioco per morsetto l'inclinazione è 0,16°, che a 60 mm sotto vale 0,17 mm, meno del tratto della penna
- [2026-10-15] **L'attacco al carrello X è sui quattro fori del motore**: reticolo quadrato da 31,0 mm, M3, con la bozza Ø22 attorno all'albero. Da verificare quale delle due facce del motore è libera, perché su quella anteriore il modulo deve scavalcare albero e pignone
- [2026-10-15] **Promemoria di posizionamento, visto che Y è motorizzato su un lato solo:** in pianta la punta va il più vicino possibile alla mezzeria dei cuscinetti del carrello X e alla trave. L'errore di posizione è l'imbardata moltiplicata per lo sbalzo, quindi ogni millimetro di sbalzo la moltiplica invece di subirla. Si misura disegnando un quadrato grande e confrontando **le due diagonali**: è anche la misura che dirà se vale la pena motorizzare il lato sinistro, per cui lo spazio è già previsto dalla prova_3
- [2026-10-15] **L'attacco è sulla faccia posteriore del motore:** nessun conflitto con albero, pignone e cremagliera. È però la faccia **più lontana dalla trave**, quindi il modulo nasce allo sbalzo massimo — la direzione in cui l'imbardata si moltiplica. Non c'è alternativa pratica, quindi il vincolo diventa tenere il modulo compatto e portare la punta il più possibile verso il lato trave
- [2026-10-15] **Quota dalla faccia inferiore del carrello X al piano: 45 mm col metro, 46,7 nel CAD.** 1,7 mm di scarto, dentro l'errore di un metro a nastro: le due misure non si contraddicono. E la quota **non serve saperla con precisione**, perché l'aggiustamento è la penna che scorre nei morsetti — motivo per cui i morsetti non vanno usati come riferimento di quota, ma solo come serraggio. Il numero serve invece per l'altezza della piattaforma della carta, e conferma i 44 mm già previsti
- [2026-10-15] **Pignone e cremagliera al posto del braccetto, per il sollevamento: il confronto.** A parità di raggio le due soluzioni hanno la stessa cinematica (corsa = r × angolo), quindi la scelta non è sul rapporto. Decide un altro numero: **il gioco di una coppia stampata, ~0,2 mm**. Su una catena rigida (~5 N/mm) vale **1 N di incertezza sulla forza di appoggio**, cinque volte la forza voluta — presa rigida e ingranaggi stampati sono incompatibili. Con una **molla morbida in serie (~0,05 N/mm)** lo stesso gioco costa **0,01 N**, e con essa diventa irrilevante anche la banda morta del servo (0,9°, che a r = 7,5 vale 0,131 mm, cioè 0,007 N). Conseguenza: la molla in serie non è un accessorio, è ciò che rende praticabile la strada scelta — e una volta che c'è, **il pignone si sceglie sullo spazio disponibile, non sul rapporto**
- [2026-10-15] **Il vero punto debole del pignone non è il pignone: è la guida verticale.** L'attrito della slitta è in serie con la forza di appoggio, quindi 0,1 N di aderenza su 0,2 N voluti sono ±50% e isteresi (la penna preme diverso dopo un'alzata e dopo essere stata spinta su dalla carta). È l'unico punto in cui il parallelogramma del 2026-10-01 resta superiore, perché un perno su cuscinetti ha attrito molto minore di una slitta. Le due cose si possono combinare: parallelogramma o lamine flessibili per **guidare**, pignone e cremagliera per **muovere**
- [2026-10-16] **L'utente sceglie cuscinetti MR63 per lo scorrimento del portapenna, e la scelta ribalta il gruppo molla.** L'attrito della guida passa da ~0,150 N (bussola stampata, μ 0,3 su 0,5 N di carico) a ~0,001 N (cuscinetto che rotola): due ordini di grandezza, e il punto debole segnalato il 2026-10-15 sparisce. Conseguenza non ovvia: **il peso proprio dello stadio flottante basta e avanza**. Un cannotto da 25 g pesa 0,25 N, cioè più dei 0,2 N che si volevano ottenere comprimendo una molla di 4 mm. Una molla che spinge in giù non serve — sommerebbe la sua forza al peso; semmai servirà **in tiro, per alleggerire**, o si toglie materiale dal cannotto
- [2026-10-16] **Architettura a due stadi sulla stessa pista**, conseguenza della precedente. Stadio comandato: 2 cuscinetti, porta la cremagliera, la sua quota è l'angolo del servo. Stadio flottante: 4 cuscinetti in due coppie, porta i morsetti e la penna, appoggia per peso proprio. Fra i due un **giunto a gioco morto da 6 mm** (perno in asola) che impedisce alla quota imposta dal servo di arrivare alla punta. Con esso l'angolo di appoggio torna **non critico** e **il servo si può rilasciare a penna giù** — era l'unico vantaggio che la soluzione a gravità del 2026-10-01 aveva e che la presa rigida aveva perso. La decisione del 2026-10-15 regge quindi nella sostanza (il sollevamento è positivo e comandato), ma la forza d'appoggio torna al peso proprio
- [2026-10-16] **L'interasse fra le due coppie di cuscinetti è la quota che decide la precisione.** Il gioco residuo arriva alla punta amplificato: `errore = gioco × (1 + h/s)`, con h = quanto la punta sta sotto la coppia inferiore e s = interasse. Con 0,05 di gioco e h = 40: s = 15 → 0,18 mm; s = 25 → 0,13; s = 40 → 0,10; s = 55 → 0,09. Non si azzera, si diluisce — conviene spendere in altezza ogni millimetro che l'inviluppo concede
- [2026-10-16] **Due accorgimenti di stampa e montaggio per la pista:** precarico obbligatorio (un perno eccentrico per coppia, come sui carrelli), altrimenti il rotolamento non serve a niente perché il gioco va dritto alla punta; e righe di strato **nel verso dello scorrimento**, perché un cuscinetto da 6 mm che rotola perpendicolare agli strati li scavalca uno per uno
- [2026-10-16] **Primo CAD del modulo (`modulo_tratto-pen_tot_prova_1`), analizzato.** Nessuna interferenza fra i 21 componenti — il contrario degli assiemi precedenti, dove le booleane ripescavano otto collisioni finte. **La guida è vincolata correttamente:** 8 cuscinetti stringono una piastra in Z (spessore 5,000, luce fra i cuscinetti 5,400) e 4 stringono una nervatura in X (larghezza 5,600, luce 6,000); insieme bloccano cinque gradi di libertà e lasciano libera solo la traslazione lungo l'asse della penna. L'imbardata, che è l'errore che si dimentica più spesso, è vincolata
- [2026-10-16] **BUG EREDITATO: il reticolo dei fori motore è 31,0000 × 31,4500, non 31 quadrato.** Verificato su `pz1` e, nello stesso file, **sul carrello: identico, 31,0000 × 31,4500**. È lo stesso scarto di 0,450 registrato il 2026-10-05 sui fori motore del carrello e accettato perché "le viti entrano, i 0,500 di scarto stanno dentro il gioco Ø4 su M3". Allora era un pezzo, ora sono due, e la nota di allora diceva già il punto: **il gioco di registrazione è esaurito**. Conseguenza nuova e peggiore: la posizione di `pz1` sul motore è la posizione della punta, cioè l'offset utensile — e non c'è margine per registrarla con le viti
- [2026-10-16] **Il gioco della guida è 0,200 per lato su tutti e dodici i cuscinetti**, cioè 0,400 totali in entrambe le direzioni. Amplificato dalla leva vale **0,942 mm alla punta** (interasse coppie 35,450, punta 48,022 più in basso, fattore 2,355). I fori Ø3,2 su perni Ø3 danno esattamente 0,200 di ripresa: l'intenzione c'è, ma il margine è zero e i fori sono tondi, quindi il cuscinetto scappa in qualunque direzione mentre si stringe. Ripreso a 0,05 l'errore scende a 0,118 mm
- [2026-10-16] **Bilancio della massa flottante: 44÷61 g, cioè 0,44÷0,60 N, contro i 0,20÷0,29 N previsti.** `pz2` è 67,54 cm³ di solido (25÷42 g stampato secondo i parametri), più penna ~10 g, dodici cuscinetti ~5,4 g, attacchi e coprivite ~4,1 g. La forza d'appoggio si regola con una molla di richiamo **in tiro**, non alleggerendo il pezzo: 25 g di pezzo stampato non si raggiungono svuotando
- [2026-10-16] **Corsa sulla pista: 25,350 mm totali, ma 10,000 esatti in discesa e 15,350 in salita.** La pista è lunga 69,800 e il gruppo cuscinetti ne occupa 44,450. I 10 mm di corsa ci stanno, ma in discesa il margine è **zero**: conviene spostare il gruppo verso l'alto sulla pista finché è un parametro nel CAD e non un pezzo stampato
- [2026-10-16] **Il morsetto, come modellato, non tocca la penna** — ed è giusto, è disegnato aperto. Ma le distanze dicono due cose: la sede in `pz2` è una **parete piana** a 0,500 dalla penna (nessuna faccia cilindrica con asse penna in `pz2`), e l'attacco è un arco Ø12 su una penna Ø10, a 1,000. A morsetti stretti **l'asse della penna si sposta fino a 0,5 mm** rispetto al modello, e il contatto avviene sui due spigoli dell'arco. Una sede a V in `pz2` definirebbe l'asse per costruzione e distribuirebbe il contatto
- [2026-10-16] **I due coprivite sono fuori posizione:** stanno a X 42÷49, a 13,5 mm dal pezzo più vicino, dove non c'è nient'altro, e non hanno nessuna faccia cilindrica (nessun alloggiamento per la vite). Da posizionare e finire
- [2026-10-16] **Interasse dei morsetti: 40,000 mm**, cioè il massimo della forchetta 30÷40 che l'utente aveva indicato. Scelta giusta: la rigidezza angolare cresce con l'interasse
- [2026-10-16] **prova_2 analizzata.** Zero interferenze fra 23 componenti. `pz1` allungato di 6,000 mm sul lato basso: la corsa sulla pista passa da 10,000/15,350 a **16,000 in discesa e 15,350 in salita, 31,350 totali**, ben centrata sui 10 mm di corsa utile. `pz2` alleggerito del 6,6% (da 67,54 a 63,08 cm³). Servo spostato di −6,000 in Y e +3,400 in Z. Aggiunte le due viti dei morsetti
- [2026-10-16] **L'albero del servo è lungo Z, non lungo X.** Ø4,800 a X −37,450, Y −4,080, uscente verso il basso da Z −52,800. Quindi il pignone gira nel piano XY e la cremagliera è una stecca verticale lungo Y con i denti rivolti verso −X — coerente con la zona evidenziata dall'utente sulla faccia di `pz2` a X −16,500
- [2026-10-16] **Il diametro del pignone lo decide una distanza sola:** dall'albero (X −37,450) alla linea primitiva della cremagliera. E siccome il pignone sta sotto Z −52,800, cioè **sotto `pz1` che finisce a Z −41,200**, il suo ingombro laterale non interferisce con il corpo del modulo: si sceglie liberamente. `z28` → cremagliera a filo della faccia (sporgenza 1,45) ma disco Ø45; `z20` → sporgenza 7,45 e Ø33, **ed è il pignone che il progetto già stampa per gli assi**; `z14` → sporgenza 11,95 e Ø24. Con il gioco morto la risoluzione non è un criterio, quindi la scelta è fra sbalzo della cremagliera e ingombro del disco
- [2026-10-16] **Le due viti dei morsetti pesano ~19 g in acciaio** (Ø5,49 × 36,9), cioè **circa un terzo della massa flottante**. Bilancio aggiornato: 62÷70 g = **0,61÷0,69 N**, peggiore della prova_1 nonostante `pz2` sia più leggero, perché prima le viti non erano modellate. La testa sta a X 47, cioè 28,6 mm fuori dalla faccia di `pz2`: accorciare la vite è il risparmio di massa più grosso disponibile, e toglie anche lo sbalzo
- [2026-10-16] **I coprivite restano a X 42÷49**, ora accoppiati alla testa delle viti. L'insieme vite + coprivite sporge quindi di 28,6 mm dal fianco di `pz2`, in aria. Da chiarire se è voluto (una manopola che si raggiunge con le dita) o se vanno riavvicinati
- [2026-10-16] **DECISIONE: l'ingranaggio si attacca al braccetto in dotazione, non si stampa la scanalatura.** Proposta dell'utente, ed è la scelta giusta per una ragione quantitativa: lo spline di un SG90 ha 21 denti in modulo 0,2, cioè denti che sporgono di **0,20 mm** sopra la primitiva (altezza totale 0,45) — metà di una larghezza di estrusione. In PLA non ingrana, o ingrana e si spiana al primo carico. Il braccetto è stampato a iniezione, ha lo spline fatto bene e arriva con la vite di ritegno assiale. Si annega in una tasca dell'ingranaggio, si centra **sul mozzo tondo** (concentrico allo spline) e si indicizza sui bracci, tagliando i due lunghi a filo e tenendo i due corti. La coppia in gioco è ~2 N·mm, che su un braccio da 10 mm fa 0,2 N: due bracci avanzano. Fissaggio con due viti M2 nei fori che il braccetto ha già, meglio della colla perché smontabile. **Dettaglio che non va dimenticato: foro di accesso Ø3 sull'asse**, passante, altrimenti dopo l'incollaggio non si arriva più alla vite del servo e per smontare si distrugge l'ingranaggio
- [2026-10-16] **Il diametro del pignone ora dipende anche dal braccetto.** La tasca non può superare `m·(z − 2,5) − 4` (2 mm di spalla sotto i denti): z14 → 13,25; z20 → 22,25; z24 → 28,25; z28 → 34,25. Da misurare col calibro la campata dei due bracci corti e scegliere di conseguenza. Resta il compromesso dell'altro verso: più denti, meno sporgenza della cremagliera da `pz2` (z20 → 7,45; z28 → 1,45)
- [2026-10-16] **Cremagliera del pen-lift quotata** in `modulo-penna/cremagliera-e-pignone.html`. Modulo 1,5, angolo di pressione 20°: fianchi **rettilinei** — l'evolvente sta tutta nel pignone — quindi bastano tre semilarghezze e due altezze. Semilarghezza 0,63214 alla cresta, 1,17810 alla primitiva, 1,86054 al fondo; addendum 1,500, dedendum 1,875, passo 4,71239. Vano al fondo 0,99131, quindi raccordo massimo 0,496 e consigliato 0,3÷0,4. **Sei denti (28,274) bastano** per i 10 mm di corsa con presa di un dente per lato; larghezza della stecca 2 mm più del pignone, 1 per lato
- [2026-10-16] **Le quote del braccetto non sono standardizzate, e lo spline è incerto di 0,3 mm.** Cercate: nessun produttore pubblica un disegno quotato del braccetto a croce dell'SG90, e le dimensioni cambiano fra i cloni. Sul diametro esterno dello spline le fonti danno 4,6 / 4,8 / 4,9 — per un accoppiamento a contatto è una divergenza inaccettabile. Concorde invece il numero di denti, 21, da cui si deduce il modulo 0,2 (primitivo Ø4,2, esterno Ø4,6). Conseguenza di metodo: il disegno del braccetto è stato fatto **parametrico su sei quote da rilevare col calibro** (`modulo-penna/braccetto-e-ingranaggio.html`), non su valori presi da internet
- [2026-10-16] **Il numero di denti del pignone lo decide la campata dei bracci corti:** `z ≥ (A + 4) / 1,5 + 2,5`, dove A è la campata dopo aver tagliato i due bracci lunghi. Sotto A = 22 il pignone resta lo **z20 già in uso sugli assi**. E il centraggio dell'ingranaggio va fatto **sull'alloggiamento del mozzo** (tornito concentrico allo spline) con 0,2 di gioco, mentre la tasca dei bracci ha 0,4 di gioco e non centra niente: centrare sui bracci importerebbe nell'ingranaggio l'eccentricità dello stampo del braccetto
- [2026-10-16] **MIO ERRORE, segnalato dall'utente: il profilo della cremagliera gliel'avevo dato a gioco zero.** Le quote di accoppiamento avevano il loro gioco (tasca del braccetto A+0,4, mozzo C+0,2, stecca 1 mm per lato più larga del pignone), ma il profilo del dente erano le quote teoriche. **Una coppia stampata a gioco zero non ingrana.** Corretto: gioco di ingranamento **j = 0,30 mm**, scaricato tutto sulla cremagliera assottigliandone i denti sulla primitiva — semilarghezza da 1,17810 a **1,02810**, cresta 0,48214, fondo 1,71055, vano al fondo 1,29131 (che in cambio permette un raccordo fino a 0,645)
- [2026-10-16] **Perché 0,30 e non meno.** La posizione della cremagliera rispetto all'albero del servo è una catena che passa per la sporgenza stampata su `pz2`, la posizione dei cuscinetti e la sede del servo in `pz1`: realisticamente ±0,3 mm. E un errore di interasse cambia il gioco di `2·tan20° = 0,728` volte sé stesso. Con j nominale 0 il gioco reale va da −0,218 a +0,218, cioè **grippa metà delle volte**; con j = 0,30 va da +0,082 a +0,518 e non grippa mai. E qui il gioco **non costa niente**, perché il giunto a gioco morto rende la forza sulla carta indipendente dalla posizione del pignone: conviene esagerare
- [2026-10-16] **Il gioco non si fa mai riducendo il modulo.** Mettere 1,48 invece di 1,50 cambia il passo, quindi i denti si disallineano progressivamente lungo la stecca e un ingranamento buono in mezzo si impunta alle estremità. Si fa sullo spessore del dente o sull'interasse
- [2026-10-16] **Onshape: la feature Spur Gear ufficiale non ha un campo per il gioco** (verificato sul forum Onshape; alcune versioni custom l'hanno aggiunto spostando l'angolo dell'evolvente). È il motivo pratico per cui il gioco va messo nella cremagliera, che è uno sketch a mano e quindi sotto controllo. Parametri del pignone: teeth 20, module 1,5 mm (non diametral pitch), pressure angle 20°, depth 6, root fillet attivo, nessun bore. Tasca, alloggiamento del mozzo, foro di accesso Ø3 e fori M2 come feature separate sul corpo generato
- [2026-10-16] **prova_3: pignone modellato e `pz2` alleggerito del 27%** (da 63,08 a 46,20 cm³). Zero interferenze fra 24 componenti. Pignone z25 confermato nel CAD: centro X −37,500, Ø esterno 40,41 × 40,48, spessore 10,009. Profondità portata a 10 perché l'incavo del braccetto è 7 e con 8 restava 1 mm solo di presa filetto per le M2; con 10 ne restano 3. **Ci sta, ma è il massimo**: sotto l'albero del servo (Z −52,800) e il fondo di `pz2` (Z −63,100) ci sono 10,30 mm, e il disco ne usa 10
- [2026-10-16] **Corsa in discesa di `pz2`: 11,000 mm.** La limitano i cuscinetti inferiori (2 e 8) che arrivano in fondo alla pista; la scansione per collisione conferma il primo contatto a 11,1 mm, stesso evento. Fra prova_2 e prova_3 la pista si è accorciata di 5 mm sul lato basso (da Y −35,978 a −30,978) e la discesa è passata da 16,000 a 11,000: allungare la pista verso il basso è la leva se servisse più corsa. Salita 15,350, corsa totale **26,350**
- [2026-10-16] **La cremagliera vuole 9 denti (42,412).** Con l'origine sulla faccia inferiore di `pz2` (Y −30,000): nella posizione modellata il pignone ingrana a 25,922 dal fondo della stecca, a fine discesa a 36,922, a fine salita a 10,572. Con un dente di presa oltre ciascun estremo servono denti da 5,860 a 41,634, cioè 8,84 passi. **8 denti (37,699) non bastano**
- [2026-10-16] **Il servo non è il vincolo, e questo smonta il timore del montaggio.** A raggio 18,750 valgono 0,3272 mm per grado: l'intera corsa della guida (26,350) sta in **80,5° su ~180 disponibili**, e la corsa utile di 10 mm in 30,6°. Margine di montaggio **±49,7°, cioè ±16,3 mm**. Lo spline ha 21 denti, quindi le posizioni di montaggio sono quantizzate ogni 17,14° = 5,61 mm: con quel margine va bene qualunque dente entro ±2 posizioni da quella ideale
- [2026-10-17] **Il range assiale che i denti dritti concedono, misurato: 4,0 mm in tutto, ma 3,796 sotto e 0,196 sopra.** La stecca è larga 14,000 e il pignone 10,009, quindi la sovrapposizione di fascia tollera 4 mm di sfalsamento assiale — è esattamente il margine che l'utente dice di volersi tenere scegliendo i denti dritti. Non è però centrato: nella posizione modellata il pignone può scendere di 3,8 mm e salire di due decimi. In montaggio il pignone va quindi tenuto **alla quota modellata o più in basso**, mai più in alto; se si vuole il margine da entrambe le parti, basta spostare la fascia dentata di ~1,8 mm verso l'alto in Z
- [2026-10-17] **prova_4 analizzata: la cremagliera è modellata, geometricamente esatta, e a gioco zero.** Unica differenza da `prova_3`: `pz2` cresce di 1,800 in −X (la dentatura) e di 1,43 cm³. Zero interferenze fra tutti gli altri 23 componenti. Passo 4,712, profondità 3,375, fianchi a 20,00°, interasse 18,750: tutto esatto al millesimo. **10 denti** da Y −30,000 a +16,133, cioè 1,24 denti di margine sotto e 0,95 sopra il campo che serve (−24,140 ÷ +11,634). Corsa invariata, 11,000 in discesa e oltre 20 in salita escludendo i cuscinetti. Larghezza della stecca 14,000 contro i 10,009 del pignone, non centrata: sporge 3,796 sotto e **0,196 sopra**, quindi se il pignone deve spostarsi assialmente in montaggio ha margine solo verso il basso
- [2026-10-17] **MIO ERRORE, secondo giro sulle stesse tolleranze: il gioco j = 0,30 non è nel CAD.** Misurato traslando la stecca lungo Y a pignone fermo a passi di 0,025: la finestra senza compenetrazione è larga **0,000 mm** — un punto solo, non un intervallo. La curva è simmetrica attorno a quel punto (0,286 mm³ da una parte, 0,302 dall'altra), quindi i profili sono coniugati esatti: il disegno è giusto, è solo troppo pieno. Le quote disegnate sono le nominali (pianetto di cresta 1,264, vano al fondo 0,991) e non quelle della sezione 2 della scheda (0,964 e 1,291). **Causa probabile:** la scheda metteva le quote con l'offset in una tabella di semilarghezze, che non sono le quote che si disegnano in uno sketch — i pianetti sì. Corretta la scheda con le due quote da cambiare espresse come larghezze
- [2026-10-17] **CORREZIONE DI UN MIO NUMERO: il centro del pignone è X −37,450, non −37,500,** e quindi la primitiva della stecca è a **X −18,700**, non −18,750. L'avevo letto dal bounding box del pignone, che per una dentatura non allineata agli assi non è simmetrico (40,410 × 40,482). Il centro vero si legge dai cilindri di testa (R 20,250) e di fondo (R 16,875), concentrici. Nel CAD la stecca è a −18,700, cioè **giusta**: l'interasse misurato è esattamente 18,750. Il valore −37,450 era già scritto correttamente nella nota del 2026-10-16 sull'albero del servo: l'errore è stato usare il bounding box nella scheda invece di quel numero
- [2026-10-17] **La massa flottante non è più un problema di budget, perché non è più la forza d'appoggio.** Il bilancio aggiornato su `prova_4` dà 46÷56 g con riempimento 35÷50% (0,45÷0,55 N), di cui **19,15 g sono le due viti dei morsetti** in acciaio (9,58 g ciascuna, M6 × ~41). Ma con la presa rigida la forza sulla carta la dà la quota, non il peso: il peso serve solo a essere sollevato, e il servo a r = 18,750 dà 9,4 N contro 0,55, cioè **17× di margine**. Il target 0,20÷0,29 N scritto il 2026-10-16 valeva per l'architettura a gravità e **non si applica più**. Resta un motivo più debole per alleggerire (inerzia e vibrazione sull'alzata), e resta che dentro i 0,30 mm di gioco la penna appoggia col proprio peso: lì 0,55 N è il doppio di quello che si voleva
- [2026-10-17] **I bulloni esagonali nei morsetti: sì, ma il verso del carico decide dov'è la tasca.** La vite non tira, **spinge**: avanza nel filetto e la sua punta preme sul magnete dell'attacco, che schiaccia la penna. La reazione spinge quindi il bullone **verso l'esterno**, cioè fuori da una tasca aperta sul lato della testa. La tasca va aperta verso l'interno (lato penna) e la spalla deve stare sul lato esterno. Misure rilevate: la parete del morsetto va da X 7,50 a X 16,50 (**9,0 mm**), foro Ø5,500 passante, punta della vite a X 6,10. Un dado M6 standard (10,0 sulle facce, 5,0 di spessore) sta in tasca da X 7,50 a 12,70 e lascia **3,80 mm di spalla**: ci sta senza ingrossare niente. Il foro residuo va aperto a Ø6,5. Il fastidio è che la tasca guarda in orizzontale, quindi il dado cade mentre si monta: tasca a 10,1 sulle facce (presa a frizione) e si inserisce prima dell'attacco, che poi lo intrappola
- [2026-10-16] **Pignone grande o piccolo, per la forza del servo: non è un criterio.** Forza alla cremagliera = coppia / raggio. Con 1,8 kg·cm (≈177 N·mm) e r = 18,750 escono **9,4 N**; con r = 10,5 (z14) 16,9 N. Ma la massa flottante da sollevare è 0,55÷0,60 N, quindi il margine è **15×** già col pignone grande. Quello che il pignone grande compra davvero: la cremagliera cade sulla parete di `pz2` invece che su una mensola (meno massa flottante, che è il parametro fuori budget) ed è **1,8× più veloce** nell'alzata (0,051 s contro 0,091 per 10 mm), il che però conta poco contro il tempo di assestamento. Criterio vero: la geometria, non la coppia

## Storico sessioni

### [2026-10-17 09:24] (meccanica) prova_4: la cremagliera è esatta e a gioco zero, lo schema descrive una macchina che non esiste, e i denti restano dritti

**Riepilogo:** la cremagliera di `prova_4` è geometricamente perfetta (passo, profondità, fianchi e interasse esatti al millesimo, 10 denti con margine da entrambe le parti) ma il gioco d'ingranamento misurato è 0,000 mm — l'offset j = 0,30 non è arrivato nel CAD; nel verificarlo è emerso che il modulo costruito ha **un solo stadio mobile** e non i due con giunto a gioco morto descritti nello schema, cosa che cambia il senso di tre numeri già registrati.

**Cosa è stato fatto:**
- **`prova_4` analizzata con OCP.** Unica differenza da `prova_3`: `pz2` cresce di 1,800 in −X (la dentatura) e di 1,43 cm³. Zero interferenze fra tutti gli altri componenti; la corsa sulla pista è invariata (11,000 in discesa, limite ancora dei cuscinetti inferiori)
- **Conteggio dei denti confermato con margine.** 10 denti da Y −30,000 a +16,133; il campo che il pignone percorre su tutta la corsa va da −24,140 a +11,634, quindi avanzano 1,24 denti sotto e 0,95 sopra. Il "ne ho fatti un po' di più" dell'utente è esattamente la quantità giusta
- **Misurato il gioco invece di stimarlo.** Traslando la stecca lungo Y a pignone fermo a passi di 0,025 mm e cercando le posizioni senza compenetrazione: finestra larga 0,000 mm. La simmetria della curva attorno a quel punto (0,286 mm³ da una parte, 0,302 dall'altra) dimostra che i profili sono coniugati esatti
- **Rilevata la divergenza fra schema e CAD** sull'architettura (un solo stadio, nessun giunto a gioco morto), e messa una nota in testa a `schema.html` che dice quali sezioni restano valide e quali no
- **Risposto sui bulloni esagonali dei morsetti** misurando la parete (9,0 mm, da X 7,50 a 16,50) e la posizione della punta della vite (X 6,10), da cui la geometria della tasca e il verso in cui va aperta
- **Registrato il nuovo parametro della tab Impostazioni** chiesto dall'utente (angolo di battuta dei cuscinetti) più i tre che ne conseguono

**Bug: il gioco d'ingranamento della cremagliera è ancora zero, al secondo giro**

**Sintomo:** nel CAD di `prova_4` la coppia cremagliera/pignone ha una sola posizione di non-interferenza invece di una finestra: gioco 0,000 mm. Le quote disegnate sono le nominali (pianetto di cresta 1,264, vano al fondo 0,991) invece di quelle con l'offset (0,964 e 1,291).
**Causa:** la scheda consegnata il 2026-10-16 esprimeva il profilo corretto come tabella di **semilarghezze** (0,48214 / 1,02810 / 1,71055). Non sono le quote che si mettono in uno sketch: in uno sketch si quotano i due pianetti e l'angolo dei fianchi. Il profilo nominale ha le stesse semilarghezze meno 0,15, quindi la differenza fra la tabella giusta e quella nominale sono tre terze cifre decimali — facile da non vedere. È una causa accertata sulla forma del documento, non una supposizione sull'utente.
**Fix applicato:** aggiunta alla scheda una sezione 6 che dà **due sole quote da cambiare**, espresse come larghezze misurabili: pianetto di cresta da 1,26424 a 0,96424 e vano al fondo da 0,99131 a 1,29131. Tutto il resto invariato, mezzerie dei denti comprese. Verificato sul disegno, non ancora in stampa.

**Bug: il centro del pignone era sbagliato di 0,050 nella scheda della cremagliera**

**Sintomo:** la scheda dava il centro del pignone a X −37,500 e quindi la primitiva della stecca a X −18,750. Nel CAD la stecca è a −18,700.
**Causa:** avevo letto il centro dal **bounding box** del pignone, che per una dentatura non allineata agli assi non è simmetrico (40,410 × 40,482). Il centro vero, letto dai cilindri di testa (R 20,250) e di fondo (R 16,875) che sono concentrici, è X −37,450. Il numero giusto era già nel documento, nella nota del 2026-10-16 sull'albero del servo.
**Fix applicato:** corretti nella scheda il centro, la primitiva, la linea di fondo e la cresta, con una nota datata che spiega l'errore. Conseguenza fortunata: la stecca nel CAD è **giusta** e non va spostata, l'interasse misurato è esattamente 18,750.

**Decisioni prese:**

- Contesto: lo schema di principio (rev. 2) descrive due stadi sulla stessa pista con un giunto a gioco morto da 6 mm, e tre note del 2026-10-16 ragionano come se quel giunto ci fosse. Il CAD, dalla `prova_1` alla `prova_4`, ha un solo pezzo mobile.
  Decisione: **si prende per buono il CAD.** Un solo stadio mobile, presa rigida, quota data dal servo — che è la strada che l'utente aveva chiesto il 2026-10-15 e che ha appena riconfermato descrivendo la taratura come tre angoli di servo. *Supera la decisione del 2026-10-16* sull'architettura a due stadi.
  Alternative scartate: rimettere il giunto a gioco morto nel CAD adesso. Costa una riprogettazione di `pz2` e dei cuscinetti per risolvere un problema che non si è ancora visto.
  Da rivedere se: alla prima stampa il tratto cambia spessore secondo il punto del foglio. In quel caso la banda morta da aggiungere non è 0,3 mm ma **quanto è fuori piano il piano carta**, che su 300 mm può valere mezzo millimetro: va misurata prima di dimensionare il giunto.

- Contesto: con un solo stadio rigido, non c'è niente che disaccoppi la quota imposta dal servo dalla forza sulla carta.
  Decisione: **i 0,30 mm di gioco d'ingranamento sono l'unica cedevolezza della catena, e sono voluti.** Dentro quei 0,30 mm `pz2` si muove senza che il pignone giri: la penna appoggia col proprio peso (0,45÷0,55 N) e non con la quota. È un giunto a gioco morto di 0,30 mm invece di 6, della stessa natura. Conseguenza operativa: la taratura di *penna abbassata* deve cadere **dentro** quella banda, e il gioco della cremagliera **non va ridotto** cercando precisione.
  Alternative scartate: inseguire il gioco minimo possibile sulla coppia. Sarebbe il contrario di quello che serve, e in più non si tiene: lo stack di tolleranze è ±0,3 mm.
  Da rivedere se: si rimette un giunto vero, e allora il gioco della coppia torna irrilevante in entrambi i versi.

- Contesto: l'utente ha i bulloni esagonali per le viti dei morsetti e chiede se usarli invece del filetto autofilettato nel PLA.
  Decisione: **sì, e la raccomandazione è di metterli.** Un filetto autofilettato in PLA su una vite che si svita a ogni cambio di penna è il caso in cui il PLA cede per primo; e il foro è Ø5,500 su una M6, cioè meno della metà della profondità di filetto, quindi anche il primo serraggio è debole. La tasca va **aperta verso l'interno** (lato penna), con la spalla sul lato esterno, perché la vite spinge e la reazione spinge il dado verso l'esterno. Nella parete da 9,0 mm (X 7,50 ÷ 16,50) un dado M6 da 5,0 di spessore lascia 3,80 mm di spalla.
  Alternative scartate: inserto filettato a caldo (fa lo stesso lavoro ed è tenuto su tutta la lunghezza, quindi non chiede spalla — ma va comprato, e il dado ce l'ha già); scendere a M4 per risparmiare ~9 g sulle viti (il risparmio non serve più, vedi la decisione sulla massa); mettere il dado nell'attacco invertendo il tiro (l'attacco è 10 × 10 mm, un esagono da 10 non ci sta).
  Da rivedere se: il dado scappa dalla tasca in montaggio nonostante la presa a frizione — allora inserto a caldo.

- Contesto: l'utente aveva impostato la doppia elica a 40° sul pignone del pen-lift, e la raccomandazione data il 2026-10-16 era denti dritti ma con un motivo che si appoggiava al giunto a gioco morto.
  Decisione: **denti dritti**, decisa dall'utente, con una motivazione che non dipende dal giunto e che è più forte della mia: l'ingranaggio è **avvitato a un braccetto**, quindi la sua quota assiale non è un riferimento — dipende da quanto a fondo il braccetto va sullo spline, dalla profondità della tasca e da due M2 in torrette stampate. I denti dritti danno un range su quella quota, l'elica lo converte in errore nel piano di rotazione. Il numero che lo conferma era già nel documento, misurato sugli assi X e Y il 2026-09-26: ±0,17 mm di centraggio con la doppia elica contro ±2 mm con i denti dritti. *Sostituisce il motivo scritto il 2026-10-16*, non la conclusione.
  Alternative scartate: doppia elica a 40° con battuta assiale netta nella tasca del braccetto. Costa un riferimento che va costruito e misurato per comprare continuità di ingranamento su una corsa di 26 mm, dove non serve.
  Da rivedere se: il pen-lift passasse a una trasmissione con riferimento assiale vero.

- Contesto: il bilancio della massa flottante è fuori budget da tre sessioni (0,45÷0,55 N contro 0,20÷0,29 N di target).
  Decisione: **il target non si applica più.** Era il target dell'architettura a gravità, dove il peso *era* la forza d'appoggio. Con la presa rigida il peso va solo sollevato, e il servo ha 17× di margine. Il problema si chiude come problema di budget.
  Alternative scartate: continuare a tagliare materiale da `pz2` e accorciare le viti per rientrare in un numero che non è più un vincolo.
  Da rivedere se: la penna appoggia dentro la banda morta di 0,30 mm e 0,55 N si rivelano troppi per la punta in fibra. Allora il peso torna a contare, ma come forza d'appoggio da ridurre, e la leva giusta sono le due viti M6 (19,15 g, un terzo del totale), non lo svuotamento di `pz2`.

**File consegnati/modificati:**
- `modulo-penna/cremagliera-e-pignone.html` — nuova sezione 6 (verifica su `prova_4`, il gioco misurato, le due quote da cambiare, le mezzerie come sono nel CAD, la nota sulla larghezza); corretti centro del pignone, primitiva, linea di fondo e cresta nella sezione 4, con nota datata sull'errore
- `modulo-penna/schema.html` — nota in testa: lo schema descrive l'architettura a due stadi, il CAD ne ha uno; quali sezioni restano valide; cosa ha preso il posto del gioco morto
- `documento-sessione-cnc-2d.md` — v31

**Impatto su Vision/Pipeline:** Step 6 — aggiunte in testa alle decisioni quella sull'unico stadio mobile (supera l'architettura a due stadi del 2026-10-16) e quella sui denti dritti (sostituisce il motivo scritto il 2026-10-16, non la conclusione); sei note nuove. Step 4 — la riga *Penna* della tab Impostazioni passa da due angoli a quattro più il raggio del pignone come parametro di conversione, su richiesta dell'utente, con una nota che spiega il perché di ciascuno.

---

### [2026-10-16 18:38] (meccanica) Dal primo CAD del modulo penna alla cremagliera quotata, passando per un errore mio sulle tolleranze

**Riepilogo:** tre revisioni del CAD del modulo Tratto Pen analizzate con OCP una dopo l'altra, con il peso della parte flottante sceso del 27% e la geometria del pen-lift chiusa: pignone z25 sul braccetto del servo, cremagliera a 9 denti quotata e posizionata, e un gioco di ingranamento che nella prima versione del disegno avevo dimenticato del tutto.

**Cosa è stato fatto:**
- **Analizzate `prova_1`, `prova_2` e `prova_3`** con OCP: interferenze fra tutti i componenti, estrazione dei fori, distanze minime, scansione di collisione lungo la corsa. Tutte e tre pulite, zero interferenze — il contrario degli assiemi di settembre, dove le booleane ripescavano otto collisioni finte
- **Consegnate tre schede di disegno**: lo schema di principio del modulo (due figure, i tre stati del meccanismo), la cremagliera e il pignone quotati, e il braccetto con l'ingranaggio
- **Verificate le quote del braccetto SG90 su internet: non esistono.** Nessun produttore ne pubblica un disegno e le dimensioni cambiano fra i cloni; sul diametro esterno dello spline le fonti divergono di 0,3 mm. Da cui la scelta di fare quel disegno **parametrico su sei quote da rilevare col calibro**
- **Calcolata la corsa che l'utente chiedeva:** `pz2` scende di 11,000 mm, fermato dai cuscinetti inferiori che arrivano in fondo alla pista. Da lì i 9 denti della cremagliera
- **`pz2` alleggerito del 27%** dall'utente (63,08 → 46,20 cm³) dopo il bilancio di massa della sessione precedente

**Bug: il profilo della cremagliera era a gioco zero**

**Sintomo:** le quote del dente che avevo consegnato (semilarghezza 1,17810 alla primitiva) sono le quote teoriche di una coppia a contatto perfetto. Una coppia stampata con quelle quote non ingrana: si impunta.
**Causa:** avevo dato il gioco su tutti gli accoppiamenti tranne quello che conta — tasca del braccetto A+0,4, mozzo C+0,2, stecca 1 mm per lato più larga del pignone, ma il profilo del dente nominale. L'ha intercettato l'utente chiedendo esplicitamente delle tolleranze, non me ne ero accorto.
**Fix applicato:** gioco j = 0,30 mm scaricato tutto sulla cremagliera, semilarghezza alla primitiva da 1,17810 a **1,02810**. Il valore è giustificato: la catena di tolleranze sull'interasse vale ±0,3 e si trasferisce sul gioco moltiplicata per `2·tan20° = 0,728`, quindi a gioco nominale zero si grippa metà delle volte. Verificato sul disegno aggiornato, non ancora in stampa.

**Decisioni prese:**

1. **L'ingranaggio si attacca al braccetto in dotazione, non si stampa la scanalatura.**
   - Contesto: proposta dell'utente, che preferiva non stampare uno spline con denti minuscoli
   - Decisione: braccetto annegato in una tasca, centrato sul mozzo tondo e indicizzato sui bracci, fissato con due viti M2 nei fori che ha già
   - Il numero che la rende obbligata: lo spline dell'SG90 è modulo 0,2, quindi i denti sporgono di **0,20 mm** sopra la primitiva — metà di una larghezza di estrusione. In PLA o non ingrana, o si spiana al primo carico
   - Alternative scartate: stampare la scanalatura; incollare il braccetto di piatto senza tasca (nessun indice contro la rotazione, e nessun accesso alla vite del servo)
   - Da rivedere se: si passa a un servo con spline più grosso

2. **Pignone z25 invece di z20.** *Supera la raccomandazione data poche ore prima nella stessa sessione*, che era z20 per riusare il profilo degli assi.
   - Contesto: noto che l'albero del servo è lungo Z e non lungo X, si è potuto calcolare dove cade la cremagliera in funzione del diametro
   - Decisione: z25, Ø primitivo 37,5. Con questo diametro la linea primitiva cade a X −18,750 e il fondo della cremagliera a −16,875, cioè **0,375 fuori dalla parete di `pz2`**: i denti sono intagliati nel fianco invece che su una mensola
   - Il motivo per cui supera la z20: il pignone sta sulla parte **fissa**, la cremagliera su quella **flottante**. La massa del disco è gratis, quella della mensola no. Il riuso del profilo z20 non valeva niente, perché la feature di Onshape lo genera comunque
   - Alternative scartate: z14 e z20 (mensola da 11,95 e 7,45 mm); z28 (cremagliera a filo ma disco Ø45)
   - Da rivedere se: cambia la posizione del servo

3. **Doppia elica: no sul pen-lift, pur funzionando bene sugli assi.**
   - Contesto: l'utente l'ha impostata a 40° per coerenza con X e Y
   - Decisione dell'utente ancora da confermare; la raccomandazione è denti dritti
   - Motivo: la doppia elica compra continuità di ingranamento, che sugli assi finisce nel tratto disegnato su 300 mm di corsa continua, mentre qui il giunto a gioco morto **scollega del tutto il movimento del pignone dalla punta**. In cambio introduce un vincolo assiale (a 40° uno sfalsamento `d` sposta il dente di 0,839·d, quindi si grippa oltre 0,358 mm con j = 0,30) su una catena che non ha nessuna battuta: quanto a fondo il braccetto va sullo spline, più due quote stampate
   - Da rivedere se: si decide di farla comunque — in quel caso cremagliera elicoidale uguale, mano specchiata, e battuta assiale netta nella tasca del braccetto

4. **La forza del servo non è un criterio nella scelta del diametro.**
   - Contesto: domanda esplicita dell'utente
   - Con 1,8 kg·cm e raggio 18,750 escono 9,4 N alla cremagliera, contro 0,55÷0,60 N di massa flottante da sollevare: **margine 15×** già col pignone grande. Quello che il diametro decide davvero è dove cade la cremagliera e, in second'ordine, la velocità di alzata (1,8× più veloce con z25 che con z14)

**File consegnati/modificati:**
- `modulo-penna/schema.html` — schema di principio, riscritto in revisione 2
- `modulo-penna/cremagliera-e-pignone.html` — profilo, tolleranze, parametri Onshape, stecca finita quotata e posizionata
- `modulo-penna/braccetto-e-ingranaggio.html` — nuovo, parametrico sulle sei quote da calibro
- `documento-sessione-cnc-2d.md` — questa voce e le note dello Step 6

**Impatto su Vision/Pipeline:** solo note dello Step 6, che resta in corso. Corretta inoltre in questa revisione una data sbagliata su cinque note dello Step 6, scritte come 2026-10-17 quando erano del 2026-10-16: avevo messo la data senza chiederla al sistema.

---

### [2026-10-16 12:36] (meccanica) Schema del modulo penna, e i cuscinetti che tolgono di mezzo la molla

**Riepilogo:** disegnato lo schema di principio del modulo Tratto Pen, e riscritto il giorno dopo perché la scelta dell'utente di usare cuscinetti MR63 al posto di bussole striscianti ha spostato l'attrito della guida di due ordini di grandezza, rendendo inutile la molla che la prima versione aveva messo lì apposta per tollerarlo.

**Cosa è stato fatto:**
- **Consegnato `modulo-penna/schema.html`**, schema cinematico in due figure: la catena dal servo alla punta, e i tre stati del meccanismo. Dichiarato esplicitamente che è uno schema di principio e non un disegno di fabbricazione — le quote derivano dai conti, l'impacchettamento dentro l'inviluppo del carrello richiede il CAD, che è dell'utente
- **Rifatto il giorno dopo in revisione 2**, con l'architettura a due stadi su pista comune e il giunto a gioco morto al posto della molla
- Registrate le quote della staffa LL (550), della faccia posteriore del motore e dello scarto 45 / 46,7 mm fra metro e CAD

**Decisioni prese:**

1. **Scorrimento del portapenna su cuscinetti MR63, non su bussole striscianti.**
   - Contesto: la revisione 1 dello schema segnalava la guida verticale come il pezzo critico del modulo, perché il suo attrito è l'unica cosa in serie con la forza di appoggio
   - Decisione dell'utente: gli stessi cuscinetti usati sui carrelli
   - Effetto: attrito da ~0,150 N (μ 0,3 su 0,5 N di carico) a ~0,001 N. Il punto critico sparisce
   - **Conseguenza non prevista, che supera la scelta della molla fatta il 2026-10-15:** con l'attrito a un millesimo di newton il peso proprio basta a far scendere la penna, e un cannotto da 25 g pesa già 0,25 N — più dei 0,2 N che si volevano ottenere comprimendo una molla di 4 mm. Una molla che spinge in giù sommerebbe la sua forza al peso invece di darla. Se servirà, servirà **in tiro, per alleggerire**
   - Da rivedere se: il tratto esce troppo marcato (togliere materiale dal cannotto o aggiungere una molla di richiamo) o troppo debole (zavorra)

2. **Due stadi sulla stessa pista, uniti da un giunto a gioco morto da 6 mm.**
   - Stadio comandato: 2 cuscinetti, porta la cremagliera, quota = angolo del servo. Stadio flottante: 4 cuscinetti in due coppie, porta morsetti e penna, appoggia per peso proprio
   - La decisione del 2026-10-15 regge nella sostanza — il sollevamento resta positivo e comandato dal servo, che era il punto dell'utente — ma la **forza** d'appoggio torna al peso proprio, come nell'architettura del 2026-10-01
   - Due vantaggi recuperati: l'angolo di appoggio torna **non critico**, e **il servo si può rilasciare a penna giù**, cosa che la presa rigida aveva perso

**File consegnati/modificati:**
- `modulo-penna/schema.html` — nuovo, poi riscritto in revisione 2
- `documento-sessione-cnc-2d.md` — questa voce e le note dello Step 6

**Impatto su Vision/Pipeline:** solo Step 6, che resta in corso con il CAD in mano all'utente.

---

### [2026-10-15 19:20] (contenuti) Catalogo completo delle riprese raccolte e primo smistamento per episodio

**Riepilogo:** l'utente ha girato la maggior parte delle riprese fino al montaggio completo della macchina (modulo penna escluso) e ha condiviso l'intera cartella — rinominando ogni file con una descrizione di cosa contiene — per avviare lo smistamento negli episodi della serie; in parallelo si è chiuso il confronto sulle tecniche per un effetto di luce giorno/notte su un timelapse.

**Cosa è stato fatto:**
- **Trascritto in chat l'elenco completo e ordinato delle riprese raccolte finora** (184 file, dalle schermate della cartella locale dell'utente: due riferimenti CAD, i file `IMG_05xx`–`IMG_57xx`/`IMG_E0643`/`LCKK3120` e due riprese finali della macchina), nello stesso ordine della cartella — propedeutico allo smistamento nelle cartelle `EP0`/`EP1`/`EP2`/`EP3`/`MORE` già create dall'utente. Segnalato un salto di numerazione (`IMG_0759` → `IMG_4587`), probabile reset del rullino del telefono, non riprese mancanti
- **Avviato lo smistamento su richiesta puntuale** (l'utente chiede per categoria, non tutto insieme): per l'Ep.0 individuati i clip di "sbrocco" (`IMG_0650`, `IMG_0651`), i video dei componenti (`IMG_5225`–`IMG_5227`), le aperture di Spotify/Claude (`IMG_5231`, `IMG_5228`) e il B-roll generico alla scrivania/pc/tastiera (una dozzina di file tra `IMG_05xx` e `IMG_53xx`–`IMG_53xx`)
- **Discusso l'effetto "timelapse di più giorni" (ciclo luce giorno/notte) su un filmato reale di lavoro al pc:**
  - Valutata la strada Higgsfield (video-to-video generativo): sconsigliata — i modelli generano a clip corte (4-15s), quindi un timelapse lungo andrebbe spezzato e ricucito con rischio di scatti/flicker alle giunzioni, e soprattutto *rigenerano i pixel* frame per frame (rischio concreto di deformare viso/mani/oggetti), in contrasto col principio di autenticità già fissato per la serie
  - Raccomandata la via deterministica: color grading in DaVinci Resolve con keyframe ciclici su temperatura colore/luminosità (caldo-giorno ↔ freddo-notte), che mantiene il girato reale intatto e dà controllo totale sul numero di cicli
  - L'utente ha proposto un'alternativa migliore: **piazzare il telefono e registrare davvero per 2-3 giorni** con un'app a intervalli. Opinione data: è la soluzione preferibile, a patto che nell'inquadratura ci sia una finestra o luce naturale che renda visibile il ciclo giorno/notte — altrimenti il trucco non si vedrebbe

**Decisioni prese:**
- Contesto: come ottenere l'effetto "il tempo passa" su un timelapse di lavoro al pc senza violare il principio "il girato reale resta reale, non va rigenerato via AI"
- Decisione: provare prima la ripresa reale su più giorni (telefono fisso, intervalli, finestra in campo); il color grading in Resolve resta il piano B se la luce naturale non basta
- Alternative scartate: relight via AI generativa (Higgsfield/Kling) — rischio artefatti e incoerente col principio di autenticità della serie
- Da rivedere se: la stanza non ha abbastanza luce naturale per rendere leggibile il ciclo giorno/notte, allora si passa al color grading in Resolve

**File consegnati/modificati:** nessun file nel repository — elenco riprese e smistamento consegnati solo in chat, su richiesta esplicita dell'utente di non salvarli ancora in un file persistente (lo smistamento è in corso, a richiesta per singole categorie)

**Impatto su Vision/Pipeline:** nessuno

---

### [2026-10-15 17:41] (meccanica) Macchina montata, assi rinominati sul foglio, e la penna torna in presa rigida

**Riepilogo:** la struttura è finita — staffa LL tagliata, portale montato, i due assi si muovono senza difficoltà — e con la macchina davanti sono cambiate tre cose di impostazione: i nomi degli assi passano alla convenzione cartesiana del foglio, la penna torna a prendere la quota dal servo invece che per gravità, e la webapp prende un nome, GDC CNC 2D SLICER, con la tab Impostazioni promossa a unica fonte di verità dei numeri di taratura.

**Cosa è stato fatto:**
- **Tagliata la staffa LL e montata tutta la macchina**, modulo penna escluso. Era l'unico taglio del progetto senza seconda possibilità: dalla stecca da 1002 restavano 452 mm, meno di un secondo pezzo
- **Il disallineamento delle rotaie è stato risolto in montaggio**, non in CAD: i 22,9 mm di corsa che costava sono recuperati sulla macchina vera
- **Rinominati gli assi in tutto il codice.** Non era solo nomenclatura: nel firmware e in FluidNC il nome dell'asse *è* la mappatura dei pin, quindi cambiare i commenti e basta avrebbe lasciato i pulsanti attaccati al motore sbagliato. Scambiati i `#define STEP/DIR` della dashboard, i blocchi `x:`/`y:` del config FluidNC — step, direction **e** finecorsa, perché i pulsanti stanno fisicamente sugli assi — e le etichette dei pin nell'interfaccia e nel README. Il cablaggio in breadboard non cambia
- **Scritta la scheda di misura del primo asse** (`misure/primo-asse.md`), poi corretta due volte prima ancora di essere usata. Primo errore mio: avevo chiesto 6400 impulsi e una misura di 188,496 mm, che **in un calibro da 150 non ci sta**. Secondo: il metodo differenziale con le punte del calibro infilate nelle cave cancella l'errore sistematico di appoggio ma non la dispersione, perché una punta piatta in una cava a V appoggia ogni volta a un'altezza diversa. Riscritta col **metodo dei perni** — due tondini identici nelle cave, `p = (R30 - R10)/20`, dove il diametro si cancella nella sottrazione e la campata lunga dimezza l'errore
- **Documentato nel README della dashboard perché i motori fischiano** appena arrivano i 12 V, con la prova che distingue il caso benigno (togliere la spunta ai driver: il fischio deve cessare di colpo) e la tabella dei suoni che invece segnalano un guasto — compreso il ticchettio da hiccup, che è il sintomo inseguito per due giorni col servo
- **Prova di movimento a macchina montata:** motori senza difficoltà anche alla velocità massima, gioco d'ingranamento "quasi zero" a mano, struttura rigida. Numeri grezzi non ancora presi

**Decisioni prese:**

1. **Nomi degli assi secondo la convenzione cartesiana del foglio.**
   - Contesto: in fase di prova X e Y erano assegnati come capitava, e risultavano scambiati rispetto a come li legge chi guarda il foglio
   - Decisione: **X** è la trave del portale (staffa LL), **Y** sono le due rotaie di base (staffe TT)
   - Conseguenza documentale: tutte le voci e le note anteriori a oggi usano i nomi vecchi e **non sono state riscritte**. L'avvertenza è nelle Convenzioni in testa alla Pipeline
   - Da rivedere se: mai. Scoprirlo guardando un disegno ruotato di 90° sarebbe peggio

2. **La quota di appoggio della penna la dà il servo, in presa rigida.**
   - Contesto: l'architettura del 2026-10-01 prevedeva discesa per gravità con servo staccato in appoggio. L'utente teme che la catena non sia abbastanza sciolta perché il peso della penna la porti giù, e preferisce dare l'altezza e provare
   - Decisione: presa rigida nei due versi, angolo di appoggio tarato e salvato nelle impostazioni
   - **Supera la decisione del: 2026-10-01** — scelta dell'utente dopo aver sentito l'argomento opposto
   - Alternativa accantonata, non scartata: discesa per gravità. I tre motivi originali restano validi (carta non piana, nessuna taratura di Z, nessun jitter sulla punta). Nota tecnica per quel giorno: la discesa per gravità **non chiede un servo reversibile** — il servo allontana attivamente il braccetto — quindi il fattore che decide è l'attrito della guida, non la scioltezza del servo
   - Da rivedere se: la linea esce di spessore diverso secondo il punto del foglio, o se l'angolo di appoggio va rifatto a ogni cambio di foglio
   - Vincolo di progetto che la decisione porta con sé: con braccetto da 30 mm, 1° di servo vale 0,52 mm alla punta e la corsa di 4 mm sta in 7,6° — otto posizioni in tutto. Va risolto nel CAD accorciando il braccetto, non dopo la stampa

3. **La webapp si chiama GDC CNC 2D SLICER, e la sua tab Impostazioni è l'unica fonte di verità.**
   - Contesto: gli stessi numeri di taratura vivono oggi in tre posti che non si parlano — i `#define` del firmware, il `cnc2d-config.yaml` e i default dell'anteprima
   - Decisione: la tab Impostazioni contiene, salva ed esporta i valori; anteprima, generatore di G-code e macchina leggono da lì. La lista dei gruppi di valori è nello Step 4
   - Alternativa scartata: continuare a cambiare lo stesso numero in tre file, che è il modo per ritrovarsi un'anteprima che mostra un disegno diverso da quello che la macchina fa

4. **Misure di taratura rinviate dopo il modulo penna.**
   - Contesto: le tre misure erano la priorità dichiarata dal 2026-10-13
   - Decisione dell'utente: aspettare la penna, perché a quel punto la taratura si fa disegnando una linea lunga e misurandola — una misura di tutta la catena, per asse, invece del solo passo della cremagliera
   - Da rivedere se: la linea disegnata non torna e serve separare i contributi; allora si usa la procedura col calibro, che resta scritta

**File consegnati/modificati:**
- `misure/primo-asse.md` — nuovo, poi rivisto due volte (metodo dei perni, limite della dilatazione del PLA)
- `firmware/cnc2d_dashboard/cnc2d_dashboard.ino` — `#define` STEP/DIR scambiati, etichette dei pin nell'interfaccia
- `firmware/cnc2d_dashboard/README.md` — sezione sul fischio a motore fermo, pin aggiornati
- `firmware/fluidnc/cnc2d-config.yaml` — blocchi `x:`/`y:` scambiati con i rispettivi finecorsa
- `documento-sessione-cnc-2d.md` — questa voce, le Convenzioni, Step 4, 5 e 6

**Impatto su Vision/Pipeline:** aggiunto un blocco **Convenzioni** in testa alla Pipeline (nomi assi, nomi staffe, nome dell'applicazione) valido per tutti gli step. Step 4 rinominato col nome dell'applicazione e arricchito della specifica della tab Impostazioni. Step 5 passa a **completato nella struttura**. Step 6 passa a **in corso** e diventa il collo di bottiglia di tutto il progetto.

---

### [2026-10-13 12:31] (contenuti) Registro episodi ancorato al lavoro reale, archivio firmware storico, tracker costi e primi asset grafici

**Riepilogo:** sul fronte contenuti/serie social sono stati creati e consolidati i tre strumenti di produzione della serie Instagram — registro episodi con script, archivio storico del firmware per rigirare i test passati, tracker costi materiali — e avviato il lavoro sulla grafica (Higgsfield per i concetti, asset overlay costruiti direttamente per le icone precise).

**Cosa è stato fatto:**

- **Serie Instagram (`content/instagram-series.md`):** creato il registro pubblicazione, scritti gli script completi (voice over, note di ripresa, testo overlay) per gli episodi 0-7, incluso un cold open/trailer per l'Ep. 0 (fail reali in stacchi rapidi + "in questa serie..."). Il registro è stato poi **ristrutturato**: aggiunta una colonna "Sessione reale" che collega ogni episodio alla voce corrispondente di questo stesso storico sessioni, e i 5 episodi generici originariamente immaginati per lo Step 5 sono stati sostituiti con 9 episodi ancorati alle sessioni meccaniche reali del 24-27/9 (modulo/pignone, scelta di stampare la cremagliera, calcolo cuscinetti, i quattro errori pre-stampa, bilancio di coppia, falso allarme attrito, salto di formato A5→A4, apertura asse Y). Aggiunti link diretti al codice/file di riferimento per ogni episodio
- **Archivio storico firmware (`firmware/archivio-storico/`):** estratti dalla cronologia git 14 snapshot del firmware dashboard (01-14, dal LED singolo al servo pen-lift), con README che spiega cosa fa ciascuna versione e a quale commit corrisponde — servono per rigirare i test degli episodi passati con il codice esattamente com'era in quel momento, dato che le riprese sono partite dopo il lavoro tecnico vero e proprio
- **Costi materiali (`content/costi-materiali.md` + `.pdf`):** creato il tracker con una colonna "prezzo effettivo" che stima quanto di ogni acquisto (spesso in confezioni multiple/kit misti) è davvero attribuibile alla macchina, al netto di scorte. Processati più round di screenshot di acquisto forniti dall'utente; generata anche una versione PDF stilizzata (reportlab). Aggiornamenti successivi: nuova base in legno che sostituisce quella stimata nello scontrino Brico, viti M4 aggiunte (non in sostituzione) alle M3
- **Consolidamento repository:** il lavoro di questa sessione era partito su un branch separato (`claude/eager-albattani-kv9tn5`); mergiato nel branch di default (`claude/elegant-knuth-0396no`, quello usato dal fronte meccanica) così entrambe le sessioni condividono tutto in un unico posto. Branch ridondante poi cancellato dall'utente su GitHub
- **Workflow Higgsfield/overlay:** definito il workflow di produzione video (DaVinci Resolve Free — niente scripting Python esterno dalla versione 21.1, import OTIO preferibile a FCPXML in quella versione); scelto di usare Higgsfield solo per grafiche concettuali/organiche (schemi, trasformazioni), mai per overlay precisi o per simulare la macchina reale. Costruito e consegnato all'utente un primo asset overlay reale (animazione Ctrl+C/Ctrl+V in stile blueprint, sfondo nero per blend "Screen" in Resolve), renderizzato interamente in locale con HTML/CSS + Playwright (registrazione) + ffmpeg (encoding) — nessuna generazione AI necessaria per questo tipo di grafica precisa

**Decisioni prese:**

- Contesto: come strutturare il registro episodi della serie Instagram
- Decisione: ogni episodio è ancorato a una voce reale dello storico sessioni, non più a un piano narrativo scritto in anticipo
- Alternative scartate: piano narrativo precompilato per tutti gli step (usato inizialmente per Step 5, poi abbandonato perché non rifletteva il lavoro meccanico reale nel frattempo documentato)

- Contesto: dove e come usare Higgsfield nella serie
- Decisione: solo per grafiche concettuali/organiche; per overlay precisi (icone, testo, tasti) costruzione diretta via HTML/CSS + rendering locale, non generazione AI
- Alternative scartate: generare anche gli overlay precisi con Higgsfield — scartato per inaffidabilità nota dei modelli video AI su testo/icone piccole

- Contesto: un timelapse ha un ostacolo (mano + attrezzo) fermo in inquadratura per l'intera durata della clip
- Decisione: raccomandato il taglio diretto della clip invece della rimozione AI, perché l'ostacolo copre l'area per tutta la durata — non esiste nessun frame reale di cosa c'è sotto, quindi un tool di rimozione inventerebbe lavorazione mai filmata, in contrasto con l'autenticità della serie
- Alternative scartate: nessuna di principio — su richiesta esplicita dell'utente, che ha scelto comunque di provare lo strumento "Remove Object from Video" di Higgsfield, sono stati forniti il prompt e le indicazioni per farlo
- Da rivedere se: l'utente decide poi di non usare il risultato della prova Higgsfield nel montaggio finale

**File consegnati/modificati:**

- `content/instagram-series.md` — creato e aggiornato più volte
- `content/costi-materiali.md` — creato e aggiornato più volte
- `content/costi-materiali.pdf` — creato e rigenerato più volte
- `firmware/archivio-storico/01-*.ino` … `14-*.ino` (14 file) + `firmware/archivio-storico/README.md` — creati
- Asset overlay "Ctrl+C/Ctrl+V" (video mp4, stile blueprint) — consegnato direttamente all'utente, non committato nel repository
- Branch `claude/eager-albattani-kv9tn5` — mergiato nel branch di default e poi cancellato

**Impatto su Vision/Pipeline:** nessuno — lavoro sul fronte contenuti/serie social, parallelo alla pipeline tecnica.

---

### [2026-10-13 07:28] (meccanica) Tagli in proprio, cremagliera X con rialzo integrato, e due giorni persi dietro a un servo che non aveva corrente

**Riepilogo:** settimana in cui la macchina è passata dal CAD al banco: l'utente ha comprato il seghetto e tagliato da solo la prima staffa TT, ha riprogettato la cremagliera X inglobando il rialzo in legno, ha scoperto che l'interasse delle rotaie è quantizzato dai fori della trave — e poi si è fermato due giorni su un servo immobile che si è rivelato un problema di alimentazione, chiuso con due 7805 separati e una spina sola.

**Cosa è stato fatto:**

- **Lista tagli consegnata e poi superata dall'utente**, che ha comprato un seghetto a pendolo e ha tagliato in proprio. Scelta della lama motivata sulla geometria del taglio (T118G, passo 0,7, perché per 64 dei 67 mm la lama attraversa l'ala da 1,5 mm) e non sul materiale generico. **Prima staffa TT tagliata, risultato ottimo**
- **Nomenclatura allineata su richiesta dell'utente:** staffa TT = le due da 400, staffa LL = quella da 550
- **Assiemi prova_2 e prova_3 analizzati.** Scoperto che l'interasse delle rotaie non è libero: i fori dell'anima della staffa LL sono a passo 25,000 e i fori di serraggio delle guance distano esattamente un passo, quindi **473,400 è il massimo ottenibile** e la trave da 550 lo copre con 0,600 mm di avanzo. Misurati per bisezione i limiti di corsa del carrello Y contro ogni ostacolo
- **Cremagliera X prova_5 verificata:** rialzo in legno eliminato, pezzo alto 68,375 (+55,000 esatti), 59 denti e passo invariati. Verificato che il restringimento della sezione sopra i primi 10 mm restituisce **21,339 mm** di margine al carrello Y
- **Firmware della dashboard riscritto** per la trasmissione reale (timer hardware, millimetri, microstep impostabili, prove quadrato/cerchio, slider servo) e poi esteso con la rampa del servo
- **Architettura di alimentazione definitiva** progettata e montata dall'utente: una spina, 12 V / 3 A, due L7805CV separati

**Bug: il servo non si muove e la scheda si spegne**

**Sintomo:** a ogni comando del servo si spegnevano il LED dell'ESP32 e quello del modulo di ricarica; il servo immobile. I LED comandati dalla dashboard funzionavano.
**Causa:** servo e logica sullo stesso 5 V del modulo 18650. Lo spunto del servo faceva collassare il ramo, l'ESP32 andava in brownout e smetteva di generare il PWM.
**Fix applicato:** due 7805 indipendenti dai 12 V. **Confermato, tutti i test passano.**

**Bug: lo sketch non compila dopo la riscrittura**

**Sintomo:** `variable or field 'setDir' declared void` e `'Motor' was not declared in this scope`, su righe scritte correttamente.
**Causa:** l'IDE Arduino inserisce i prototipi generati prima della prima funzione del file; spostando le costanti in cima, la prima funzione era finita sopra `struct Motor`.
**Fix applicato:** struct spostate in una sezione "Tipi" in testa. **Confermato.**

**Bug: lo slider della rampa servo etichettato al contrario**

**Sintomo:** l'utente ha provato "il movimento morbido al massimo" e il problema restava.
**Causa:** lo slider si chiamava "Movimento morbido" ma il valore sono i **gradi per passo**, quindi più alto = più duro. Portandolo a 20 chiedeva 2000°/s, cioè il salto secco con un altro nome: la prova più dolce è 1.
**Fix applicato:** rinominato "Passo della rampa — più basso = più morbido", con il nome della condizione accanto al numero e fondo scala ridotto a 10. **Errore di interfaccia mio, non di lettura dell'utente.**

**Quattro errori miei di metodo, non di calcolo**

- **L'alimentazione classificata come causa poco probabile.** Avevo scritto "non aspettarti che sia quello" mettendo in cima la massa mancante. La massa era a posto e l'alimentazione era la causa. L'avevo anche elencata, come ramo del brownout, ma l'ordine di probabilità ha mandato l'utente a cercare altrove per un giro
- **L'ingombro del carrello X lungo la rotaia dato come 51 mm**: sono **82,000**, perché i 51 sono la sola gabbia motore mentre i 608 stanno a passo 60,000 e con Ø22 arrivano a 82
- **L'interasse rotaie dato come `lunghezza trave − 76,0`** = 474,0: è **473,400** e lo quantizzano i fori, non la lunghezza
- **Il controllo di sintassi con g++ non poteva vedere l'errore dei prototipi**, perché g++ non li inietta. Buco del metodo, non sfortuna: il controllo ora emula quel passaggio ed è stato validato facendogli riprodurre l'errore sulla versione vecchia

**Decisioni prese:**

- **Contesto:** il rialzo in legno sotto la cremagliera X era il termine dominante della catena delle quote (planarità ±0,50 su 284 mm, contro un budget di ±0,275). **Decisione (dell'utente):** stamparlo insieme alla cremagliera, pezzo unico alto 68,375. **Alternative scartate:** tenere il riporto in legno curandone la planarità, che non è un'operazione che si fa in casa. **Da rivedere se:** il ritiro del PLA su 68 mm (~0,21 mm, sempre verso il gioco largo) risultasse non compensabile con spessori
- **Contesto:** servo e logica sullo stesso 5 V, e l'utente non vuole più di una spina per accendere la macchina. **Decisione:** una spina da 12 V / 3 A e **due L7805CV indipendenti**, uno per la logica e uno per il servo. **Alternative scartate:** un solo regolatore condiviso (è la configurazione che ha causato il guasto); uno switching LM2596, più efficiente e indicato come upgrade futuro, ma non disponibile — e due lineari separati sono elettricamente più puliti di uno switching condiviso; una seconda presa dedicata al servo, rifiutata dall'utente. **Da rivedere se:** il calore dei due lineari (1,75 W e 0,7 W medi) desse fastidio sulla base
- **Contesto:** l'utente vuole lasciare il circuito su breadboard e fissarla alla base. **Decisione:** **sì per i segnali, no per la potenza** — i due 7805 su millefori saldata, il ramo 12 V su morsetti a vite, breadboard fissata e cavi ancorati. **Alternative scartate:** tutto su breadboard (contatti dati per ~1 A contro 2 A di picco, e la vibrazione del portale rende intermittenti i contatti a frizione: un STEP intermittente si manifesta come errore di quota e manda a cercare il guasto nella meccanica); tutto saldato subito, che toglierebbe la flessibilità proprio mentre il modulo penna deve ancora nascere
- **Contesto:** la staffa LL non è ancora tagliata. **Decisione:** **aspettare il primo test di movimento.** Dalla stecca da 1002 restano 452 mm, meno di un secondo pezzo: è l'unico taglio senza seconda possibilità, e rimandarlo non costa niente

**File consegnati/modificati:**

- `firmware/cnc2d_dashboard/cnc2d_dashboard.ino` — riscritto (timer hardware a 20 kHz, interfaccia in millimetri, microstep impostabili, slider servo dal vivo, prove quadrato/cerchio, rampa del servo)
- `firmware/cnc2d_dashboard/README.md` — aggiornato su microstep, millimetri, generazione dei passi e rampa del servo
- `firmware/archivio-storico/15-microstep-millimetri-prove-insieme.ino` e `README.md` — nuovo snapshot
- `gcode/test/README.md` — corretta la nota "40 mm = un giro d'albero", vera con le cinghie e non più con pignone e cremagliera
- STEP analizzati (upload, non in repo): `Assembly_1_prova_2`, `Assembly_1_prova_3`, `cremagliera_X_dx_prova_5`

**Impatto su Vision/Pipeline:**

- **Step 1:** tre decisioni nuove (una spina con due 7805 separati; il 18650 fuori dal progetto; la breadboard definitiva solo per i segnali) e due note, fra cui il bug del brownout
- **Step 2:** sei note nuove, fra cui la riscrittura della dashboard, il bug dei prototipi dell'IDE e la conferma dei microstep a 1/16
- **Step 5:** nove note nuove; blocco dei problemi aperti riscritto con **tre voci chiuse** (la priorità del calibro, la lista tagli, il piano di base) e **cinque nuove**, fra cui la nuova priorità: le tre misure del primo test di movimento
- **Step 6:** una nota — il requisito dell'alimentazione dedicata al servo è stato soddisfatto in anticipo, pagandolo con due giorni di diagnosi

---

### [2026-10-06 18:58] (meccanica) Modulo penna progettato e rinviato, asse X raddoppiato, portale assemblato: la lista tagli e quattro errori di calcolo miei

**Riepilogo:** sessione lunga che ha chiuso l'altezza della cremagliera Y (stampata, gioco ottimo), progettato per intero il modulo penna e poi rinviato, deciso di motorizzare un solo lato dell'asse X con numeri alla mano, portato il carrello X alla v2 in due revisioni (stampato e funzionante), raddoppiato il lato sinistro e misurato il portale assemblato — da cui esce la lista tagli (trave 550, rotaie 2 × 400) e la scoperta che il piano di base non basta più; lungo la strada ho sbagliato quattro conti e li ho corretti tutti con misure booleane invece che con stime.

**Cosa è stato fatto:**

**Bug: altezza della cremagliera Y sbagliata di 0,119 mm**

**Sintomo:** avevo dato H = 44,381 come quota da mandare in stampa.
**Causa:** il Ø di testa dell'ingranaggio l'avevo letto dal **bounding box** (33,237) invece che dai cilindri veri (33,000). Su una dentatura a spina di pesce OCC circoscrive le facce NURBS con 0,1185 di margine per lato, ed è esattamente metà di 33,237 − 33,000: quello scarto l'avevo interpretato come una correzione di profilo x = +0,079, e il raggio operativo come 15,119 invece di 15,000.
**Fix applicato:** **H = 44,500 = 46,000 − t_ala**, verificata tre volte in modo indipendente — catena di quote dall'estradosso dell'ala, gioco di testa che viene 0,375 = 0,25·m senza essere stato imposto, e gioco misurato 0,226 mm mettendo in presa la geometria dell'utente (ribaltata) con scansione di fase e bisezione. Verificato: cremagliera stampata, gioco dichiarato ottimo dall'utente.

**Bug: margine di corsa calcolato sull'estremità sbagliata**

**Sintomo:** avevo detto all'utente che gli restavano 0,320 mm di margine fra guancia e cuscinetto laterale, e che doveva allungare la trave con urgenza.
**Causa:** avevo usato l'estremità del **pezzo** cremagliera invece dell'estremità della **dentatura**. Fra le due ci sono 7,748 mm di base piena, distribuiti in modo asimmetrico (1,874 da un lato, 5,874 dall'altro).
**Fix applicato:** margine vero **4,194 mm**. L'urgenza non c'era. Corretto esplicitamente all'utente.

**Bug: l'argomento del baricentro era sbagliato di segno**

**Sintomo:** avevo detto all'utente di non riempire il vuoto dietro al motore del carrello X perché 50 g a quota 74 avrebbero alzato il baricentro e peggiorato l'effetto pendolo inverso.
**Causa:** avevo guardato il carrello X **da solo**. Il baricentro dell'assieme che si muove davvero sta a **Z ~94**, dominato dalla trave di alluminio a Z 114 e dal carrello Y a ~103; il materiale aggiunto sta a Z ~74, quindi **lo abbassa** di ~1,5 mm.
**Fix applicato:** ritirato. E anche il "non riempirlo" era sopravvalutato: su un pezzo stampato lo slicer svuota comunque, quindi un blocco pieno a 15% di infill fa ~37 g contro i ~35 di una scatola progettata a pareti da 4 mm. Il cuneo autoportante che l'utente ha fatto è meglio di entrambe le mie proposte.

**Bug: ingombro del carrello Y sottostimato di 33,5 mm per estremità**

**Sintomo:** trave Y consigliata prima 430, poi 500, poi 550 nella stessa sessione.
**Causa:** stimavo l'ingombro contando le guance (49,5) e i cuscinetti laterali (33,0 dal pignone), ignorando che a quelle distanze **le due gabbie motore si toccano corpo contro corpo**.
**Fix applicato:** misurato montando i due solidi nello stesso sistema e cercando il primo contatto per bisezione — **px = −78,000**, zona di contatto X −38,00…−36,00 / Z 81,65…85,93. Quindi `A = 38 + 78 = 116,000` per estremità, e `L = corsa + 2A + 2g`. La lezione: su questa macchina le stime da bounding box hanno sbagliato tre volte su tre, le booleane zero.

**Bug: `steps_per_mm` sbagliato di 2,36× in configurazione**

**Sintomo:** nessuno ancora osservabile — la macchina non ha mai girato sotto G-code con la trasmissione definitiva.
**Causa:** `firmware/fluidnc/cnc2d-config.yaml` porta ancora `steps_per_mm: 80`, dimensionato per cinghia GT2 e puleggia a 20 denti. La trasmissione è pignone e cremagliera m1.5 z=20, dove il giro vale `π · m · z = 94,2478` mm.
**Fix applicato:** nessuno — il valore corretto è **33,953** (3200 microstep / 94,2478) ma non è ancora stato scritto. È il primo numero da correggere, perché finché è sbagliato ogni limite di corsa inserito è sbagliato dello stesso fattore e nessun pannello può accorgersene: il pannello parla in mm e il mm è falso.

**Bug: gli MR63 laterali penetrano nella rotaia X di 0,500 per lato**

**Sintomo:** le booleane sull'assieme piazzato trovano 8 interferenze da 2,81 mm³, una per ogni cuscinetto laterale dei due carrelli X, con zona di contatto spessa esattamente 0,500 mm. I carrelli però scorrono bene nella realtà.
**Causa:** non accertata con certezza. L'indizio decisivo è che **gli MR63 laterali del carrello Y non interferiscono per niente** (lì il gioco modellato è 0,050 e torna): quindi è il profilo della rotaia TT nel modello a essere sbagliato — luce interna 20,000 contro perni a ±7,500 — non lo schema di guida.
**Fix applicato:** nessuno — serve il calibro sulla rotaia vera. Vedi Problemi aperti, è l'unica misura rimasta e blocca la squadratura.

**Altre attività:**
- **Modulo penna progettato per intero** (architettura, forze, incastri, servo, interfaccia utensili) e poi **rinviato** dopo l'assemblaggio del portale, su obiezione dell'utente. Confluito nel nuovo Step 6
- **Architettura dei limiti di spazio definita** su richiesta dell'utente: corse in FluidNC, foglio nell'app, margine come numero proprio, e la scoperta che i due pulsanti d'angolo già cablati possono diventare riferimenti di azzeramento sbloccando `soft_limits`. Confluito nello Step 3
- **Carrello X v2 rivisto in due giri** (prova 1 e 2) con misure sulle facce e mappe dello spazio libero; l'utente l'ha stampato e funziona, la staffa Y si alloggia
- **Cremagliera Y misurata dente per dente:** 62 denti, passo 4,71240 su tutti, spessore sulla primitiva 2,15620 su tutti — variazione zero su 290 mm. E verificato che ci sta sul piatto **in un pezzo solo** a 45° (`297,360 + 28,456 = 325,8` contro 362,04), quindi niente giunto e niente gradino di passo
- **Assieme completo analizzato:** 52 istanze piazzate estratte dalla gerarchia doppia dell'export, interferenze su tutte le coppie, interasse rotaie 473,40, trave da esterno a esterno 549,40, due rotaie sfalsate di 62,08 in Y, cremagliera Y decentrata di 25,88, piano di base fuori di 154 mm, area di disegno centrata su X −102,6 / Y −87,9
- **Due voci chiuse come non-problemi** dopo essere state segnalate rispettivamente quattro e tre volte: i 608 a filo del bordo d'ala (lo sbordamento è lo 0,7% della larghezza del cuscinetto) e la fila di fori motore a passo 31,500 (le viti entrano, i 0,500 stanno dentro il gioco Ø4 su M3)

**Decisioni prese:**

- **Contesto:** la penna va mossa su e giù in modo ripetibile su una carta che non è piana. **Decisione:** parallelogramma articolato, discesa per gravità, servo che fa **solo** il sollevamento con 1,5 mm di gioco morto che lo stacca mentre si disegna. **Alternative scartate:** leva basculante su due MR63 (un solo giunto, gioco quasi nullo, ma obbliga a una penna ≤46 mm); tubi telescopici in ottone (la migliore sul trascinamento, ma accetta un refill non una penna); slitta su bronzine stampate (gioco diretto sulla punta); servo in presa rigida nei due versi. **Da rivedere se:** si accetta di lavorare con refill D1 da 67 mm, e allora la leva torna la scelta migliore
- **Contesto:** l'utente vuole più moduli penna per usare pennarelli diversi, e in prospettiva un taglierino. **Decisione:** l'interfaccia diventa un **riferimento** (due spine Ø3 asimmetriche + connettore + secondo canale servo riservato) e la sede utensile permette la rotazione, così la **lama trascinata** si ha gratis. **Alternative scartate:** lama tangenziale orientata attivamente, che vuole un asse A vero coordinato (un servo non basta, accumula angolo) e la punta esattamente sull'asse di rotazione
- **Contesto:** serviva decidere se motorizzare anche il secondo carrello X. **Decisione:** **un solo lato motorizzato, l'altro folle**, stesso pezzo specchiato con la sede motore predisposta ma vuota. **Alternative scartate:** motore unico con albero di collegamento; due motori in serie su un driver; due in parallelo; due driver con squadratura in firmware. Il conto: ritardo elastico 3÷9 µm a 0,3 g con trave 430, contro 235 µm di gioco e 0,83 mrad di imbardata che il secondo motore non tocca; e coppia disponibile 40× quella richiesta. **Da rivedere se:** la spinta a mano sul lato folle varia di più del doppio lungo la corsa, o è uniformemente oltre 3 N
- **Contesto:** due staffe rigide alle estremità della trave sovravincolano il portale. **Decisione:** **fisso e flottante** — lato motorizzato vincola tutto, lato folle ha scorrimento permanente lungo l'asse della trave più registrazione di squadratura bloccabile in direzione di corsa. **Alternative scartate:** vincolare rigidamente entrambi i lati e fidarsi del parallelismo delle rotaie
- **Contesto:** l'utente vuole i limiti di spazio inseriti a mano in un pannello, con due valori per posizione (foglio e fine corsa). **Decisione:** **corse in FluidNC** (`max_travel_mm`, con azzeramento sui due pulsanti esistenti e `soft_limits` attivi), **foglio nell'app**, **margine come numero esplicito suo**, limite effettivo calcolato e mai salvato. **Alternative scartate:** tutto nell'app (un limite che vive solo nella UI non è una protezione ma un suggerimento: una riga battuta nella console di FluidNC lo scavalca); margine sommato dentro ai limiti (il numero mostrato non sarebbe più quello vero)
- **Contesto:** ordine di lavoro fra secondo asse X e modulo penna. **Decisione:** **asse X → tagli e assemblaggio → modulo penna**, su obiezione dell'utente. **Supera la raccomandazione data poche ore prima** nella stessa sessione (modulo penna prima, perché è lo strumento di misura della macchina) — argomento valido ma secondario: senza il secondo appoggio il portale non si può muovere, e una macchina che si muove senza penna dà già informazioni
- **Contesto:** lunghezza di taglio della trave Y. **Decisione:** **550 mm**, rotaie 2 × 400. Non è il minimo (549,40 a filo): a 550 la capacità di corsa sale a 308 e ci sta anche la cremagliera Y più lunga stampabile in un pezzo solo, per 29 g di massa in più. **Supera** le indicazioni di 430 e di 500 date prima nella stessa sessione
- **Contesto:** il formato dichiarato era "A4 in orizzontale". **Decisione:** **~242 × 256 mm**, A4 rinviato. Con cremagliere in un pezzo solo il massimo raggiungibile è 281,6 × 292,8: il lato da 297 non entra su nessuno dei due assi. L'area è equivalente a un A4, la forma è quadrata. **Da rivedere se:** l'A4 diventa un requisito, e allora serve una cremagliera giuntata

**File consegnati/modificati:**
- `documento-sessione-cnc-2d.md` — v16 → v17
- `firmware/fluidnc/cnc2d-config.yaml` — **non modificato**, ma `steps_per_mm` va portato da 80 a 33,953 e va aggiunto il blocco `homing` per asse
- Nessun file di codice toccato: la sessione è stata tutta analisi geometrica su STEP e progettazione
- STEP analizzati (upload, non in repo): `asse_Y_tot_prova_5`, `asse_X_dx_-carrello_v2_prova_1` e `_prova_2`, `Assembly_1_prova_1`, più i file cremagliera X prova 2 e 3 per ricavare la corsa dell'asse X

**Impatto su Vision/Pipeline:**
- **Nuovo Step 6 — Modulo penna e interfaccia utensili** (stato: da fare, architettura decisa). Scorporato dallo Step 5 perché è diventato un sottosistema con decisioni proprie e un criterio di completamento proprio, e perché la scelta di farne una famiglia di utensili ne cambia i requisiti
- **Step 5:** stato da "in corso (progettazione)" a "in corso (assemblaggio)"; **obiettivo ridimensionato** da "tutta l'area di un A4 in orizzontale" a "circa 242 × 256 mm" con la motivazione in nota; cinque decisioni progettuali nuove; dodici note; blocco dei problemi aperti riscritto con **otto voci chiuse** e la nuova priorità unica (luce interna della rotaia X)
- **Step 3:** tre decisioni progettuali nuove, di cui una **supera** "nessun azzeramento automatico" del 2026-09-21; due note, fra cui la discrepanza su `steps_per_mm`. Lo stato resta **completato** perché il criterio (quadrato e cerchio verificati a vista sui motori) era e resta soddisfatto — ma va registrato che le quote eseguite erano 2,36× quelle comandate
- **Vision:** non modificata

---

### [2026-10-01 18:00] (meccanica) Trave Y comprata, carrello Y dalla prova 1 alla 4, e la catena di quote che si sposta tutta sulla trave

**Riepilogo:** comprata e misurata la trave a T dell'asse Y, progettato il carrello Y in quattro iterazioni fino alla prima stampa, trovati e corretti tre errori geometrici (dentature con elica di mano opposta, pattern fori motore, cremagliera che non raggiunge le asole), e deciso di mettere il motore sotto la trave a cavallo dell'anima — scelta che obbliga la cremagliera a scendere su una base alta 44 mm e sposta le tolleranze critiche su tre quote di un profilo comprato e non ancora misurato.

**Cosa è stato fatto:**

- **Trave Y acquistata e rilevata dallo STEP**: alluminio, T asimmetrica, ala 67,100 × 1,500, anima 3,100, altezza totale 23,500, due bande asolate sull'ala. Verificato che le piste dei cuscinetti cadono fuori dalle asole (2,40 e 4,20 mm di margine) e che il bordo inferiore dell'anima è continuo per tutta la lunghezza — condizione che ha poi reso possibile l'anti-sollevamento
- **Carrello Y progettato in quattro versioni** (prova 1 → 4), con controllo booleano di compenetrazione a ogni passo: dall'ultima versione tutte le coppie (ruota, mozzo, dieci cuscinetti, carrello, trave) danno zero
- **Catena verticale chiusa**: asse pignone a Z −36,000, primitiva cremagliera a −20,881, altezza cremagliera 44,381
- **Lunghezza della cremagliera Y decisa**: due pezzi identici da 37 passi, stampati dritti sul piatto

**Bug: le due dentature avevano l'elica di mano opposta**

**Sintomo:** 74,1 mm³ di compenetrazione booleana fra pignone e cremagliera Y nell'assieme. Non scendeva sotto ~35 mm³ né ruotando il pignone sul suo asse, né facendolo rotolare davvero (rotazione + traslazione r·θ), né aumentando l'interasse fino a 0,8 mm.
**Causa:** inseguendo un singolo dente al variare di Y, la cremagliera dà pendenza dX/dY **+0,60** e il pignone **−0,576**. Stesso angolo d'elica (30°), ma le punte delle V guardano da parti opposte: le tracce dei denti si incrociano a 60° invece di essere parallele nel punto di contatto. Probabile origine: la cremagliera Y è stata ricavata da quella X ribaltandola per portare i denti in giù, e quel ribaltamento inverte la mano.
**Fix applicato:** si gira la ruota sottosopra. Essendo simmetrica rispetto al piano di mezzeria, ribaltarla inverte la mano senza spostare nient'altro. Verificato: compenetrazione **0,000 mm³** con finestra di gioco ~0,26 mm. **Non** si risolve ruotandola sul mozzo, che era l'istinto iniziale: quella cambia la fase, non la mano. Da verificare la stessa cosa sull'asse X, dove potrebbe servire l'orientamento opposto.

**Bug: il carrello Y si solleva sotto una forza applicata al motore**

**Sintomo:** alla prima stampa, premendo con un dito sul retro del motore il carrello si alzava dalla trave.
**Causa:** niente teneva giù il lato −Y (i 608 di quel lato solo appoggiano sull'ala) e il motore sta 59 mm sotto il piano di appoggio, quindi qualsiasi forza lì genera un momento grande. Confermato dai numeri: la forza tangenziale agisce sul punto primitivo a Z −20,881, l'attrito che la contrasta sui 608 a Z 23,500, braccio 44,381 mm scaricato sui 60 mm di passo perni → a stallo ±5,4 N contro 2,15 N di peso per stazione.
**Fix applicato:** due MR63 ad asse Y che spingono verso l'alto contro il bordo inferiore dell'anima. Verificato in CAD, da verificare sul pezzo stampato. In marcia normale il momento non solleva ma dimezza il carico su una stazione, ed è quella cedevolezza che si traduce in isteresi nel disegno.

**Bug: pattern dei fori motore sbagliato per tre versioni**

**Sintomo:** interasse fori NEMA 17 misurato 31,000 × 32,000 su prova 2 e 3, 31,000 × 31,450 su prova 4. Il valore corretto è 31,000 × 31,000.
**Causa:** l'utente aveva riprodotto i fori del carrello X, che però ha **una sola fila di due viti** (31,000 in una direzione sola, perché la coppia superiore cadrebbe fuori dal pezzo): la seconda quota non c'era da copiare ed è stata disegnata a mano.
**Fix applicato:** parziale. Su prova 4 la fila inferiore è esatta (−51,500 = −36,000 − 15,500), **la superiore è ancora alta di 0,450** e va portata a −20,500. Non impedisce il montaggio (Ø4 su M3 dà 0,5 di raggio libero) ma consuma tutta la registrazione proprio su Z, che è l'asse dell'interasse.

**Decisioni prese:**

- *Contesto:* dove mettere il motore dell'asse Y. **Decisione:** sotto la trave, con la gabbia centrata sul piano dell'anima. *Alternative scartate:* **motore sopra il carrello** — verificato che l'argomento dei "5 cm di penna in più" non regge (l'attacco del modulo è più basso di soli 13 mm col motore sotto, ma la macchina deve stare 19 mm più alta, quindi il modulo verrebbe 6 mm più corto col motore sopra); ha deciso l'argomento vero, cioè che **il corpo del motore è alluminio** e quei millimetri di discesa non li fa un braccio stampato in PLA. **Motore tutto fuori sul lato −Y** con la cremagliera direttamente sotto l'ala — geometricamente funziona, ma porta il baricentro a Y ≈ −37, fuori dalla carreggiata, e l'ala finisce a −42,05 quindi non c'è dove allargare l'appoggio. *Da rivedere se:* il modulo penna risultasse scomodo da attaccare dietro al motore, o se il franco verticale sotto il portale diventasse critico
- *Contesto:* come impedire al carrello di sollevarsi. **Decisione:** due MR63 ad asse Y sotto il bordo inferiore dell'anima. *Alternative scartate:* una seconda coppia di 608 sotto l'ala, che avrebbe leva migliore (Y −19,45 invece di Y 0) ma cade esattamente dove scende la cremagliera. *Da rivedere se:* l'altezza reale della trave si rivelasse troppo variabile per un gioco di 0,000 — nel qual caso serve comunque l'asola in Z
- *Contesto:* lunghezza della cremagliera Y, servendo ~343 mm di dentatura. **Decisione:** due pezzi identici da 37 passi (174,359), incastro maschio/femmina al giunto, stampati dritti sul piatto. *Alternative scartate:* pezzo unico — il piatto a 45° con larghezza 28,456 ammette 333,6 mm teorici e ~300 pratici, non bastano. *Da rivedere se:* la corsa Y richiesta cambiasse
- *Contesto:* il carrello stampato scorreva con troppo gioco. **Decisione (dell'utente):** stringere i nominali — 608 da 0,150 a 0,100, MR63 laterali da 0,100 a 0,050, anti-sollevamento a 0,000. *Riserva registrata:* 0,050 è sotto la tolleranza di stampa, quindi la prossima stampa può uscire con 0,15 di gioco o 0,05 di interferenza senza modo di aggiustare. Il rimedio strutturale resta l'**asola**, non il nominale più stretto, che aggiunge precarico su tutta la corsa e lo fa pagare dove il profilo è più spesso

**Correzioni a quanto detto in sessione:**
- Avevo scritto che stringendo la cremagliera contro l'ala l'ingranamento si stringe. È il contrario: denti in giù e pignone sotto, quindi tirandola su l'interasse **aumenta**. Il margine di montaggio voluto dall'utente andava nel verso giusto
- Avevo concluso che la coppia pignone-cremagliera "non può ingranare" e che andava specchiata la cremagliera. La diagnosi (mano opposta) era giusta ma la correzione no: basta **girare la ruota sottosopra**, cioè si risolve in montaggio come aveva intuito l'utente, solo con un movimento diverso da quello che pensava

**File consegnati/modificati:**
- `documento-sessione-cnc-2d.md` — versione 16
- STEP analizzati (non in repo): `asse_Y_-_staffa_carrello_prova_1`, `asse_Y_prova_2`, `asse_Y_prova_3`, `asse_Y__prova_4`, più il confronto con `tot_prova_3` (carrello X) e `ingranaggio_e_cremagliera_prova_1`

**Impatto su Vision/Pipeline:** Step 5 — aggiunte due decisioni progettuali (motore Y sotto la trave a cavallo dell'anima; anti-sollevamento sul bordo inferiore dell'anima), 17 note di cronologia, e riscritto il blocco dei problemi aperti: chiusi il profilo della trave Y e il layout del carrello Y, aperta come priorità la misura delle tre quote della trave.

---

### [2026-09-27 17:32] (meccanica) Carrello completo misurato, falso allarme sullo strisciamento, cremagliera chiusa e apertura dell'asse Y

**Riepilogo:** Il carrello X completo scorre e l'attrito che sembrava strisciamento si è rivelato attrito interno dei cuscinetti — cioè costante, quindi destinato a migliorare sotto carico — e con la massa che smette di essere un vincolo il formato sale ad A4 orizzontale; la cremagliera arriva a una versione geometricamente corretta dopo tre difetti trovati sullo STEP, e si apre l'asse Y con due principi che hanno già riscritto lo sketch.

**Cosa è stato fatto:**

- **Carrello X completo stampato e assemblato.** 290 g, distacco ~10°, moto costante ~15°. In forza sono 0,50 e 0,76 N contro 4,42 disponibili: margine 5,8×
- **Test della calamita**: profili non magnetici, quindi alluminio a 452 g/m invece dei 1314 dell'acciaio
- **Controllo dello STEP della cremagliera v2**, tre difetti trovati, e **verifica della v3** che li ha chiusi tutti: 59 denti tutti a 2,1562 sulla primitiva, tutti i passi a 4,7124, chevron simmetrico a ogni altezza di fascia fino all'ultima cifra
- **Ricostruita la catena verticale** dal carrello: asse pignone Z 74,150, primitiva Z 59,150, e l'equazione `D = t_binario + 59,150 − t_cremagliera` che lega le due quote di legno allo spessore stampato
- **Analisi delle tolleranze della catena verticale**, che ha ribaltato una raccomandazione data poche ore prima (vedi sotto)
- **Aperta la progettazione dell'asse Y**: quattro sketch discussi (1, 1.1, 1.2, 2), scritta la specifica del profilo da comprare, e calcolate frequenze proprie (145 Hz verticale, 388 orizzontale) e contributi d'errore del carrello

**Bug: l'attrito del carrello scambiato per strisciamento**

**Sintomo:** angolo di distacco 10° e moto costante 15° su un carrello da 290 g, cioè μ apparente 0,18÷0,27 contro lo 0,01÷0,02 che darebbero dei cuscinetti a sfere. Un test con 300 g aggiunti non ha fatto scendere l'angolo, il che indicava attrito **proporzionale al carico**, cioè radente.
**Causa:** nessun meccanismo di strisciamento esisteva davvero. La verifica diretta — far girare a dito tutti e 12 i cuscinetti e cercare contatti del PLA sul binario — li ha trovati tutti liberi e nessun contatto. Il drag è **attrito interno dei cuscinetti**: otto 608ZZ con coppia di spunto 0,3÷1,0 mN·m su raggio 11 danno 0,25÷0,83 N, che copre esattamente i 0,50÷0,76 misurati. Il test con i 300 g era l'unica misura fatta a occhio su una differenza sottile (15° contro ~8°) ed è stato battuto da un'osservazione binaria.
**Fix applicato:** nessuna modifica al pezzo — il carrello va bene com'è. Cambia l'interpretazione: essendo il drag **costante e non proporzionale**, caricando il portale il μ effettivo **scende** (da 0,27 a ~0,082 a 1,1 kg totali) invece di restare. Metodo migliore per una prossima verifica: tirare il carrello in piano con una bilancia da valigia e leggere i grammi, invece di stimare angoli a occhio.

**Bug: due fori passanti distruggevano la dentatura della cremagliera**

**Sintomo:** sullo STEP della v2, scansione sulla primitiva a Y=0: fra il dente a X 6,586 e il successivo a 18,137 c'erano 11,551 mm invece di 4,712, e un secondo salto di 9,425 a X≈256.
**Causa:** due viti di battuta erano state messe al centro della cremagliera, con fori Ø8 passanti **dall'alto**, che salivano fino a Z 3,375 tagliando i denti fino in testa. Il danno era un intaglio a V centrato sull'apice: a |Y|≥4,5 i denti erano interi, a Y=0 ne mancavano due. Restavano anche due schegge di dente spesse 0,030 mm, sotto la larghezza dell'ugello.
**Fix applicato:** fori rimossi in v3, verificato sullo STEP. Verificato anche che le sole 11 asole laterali bastano: la forza di separazione dell'ingranamento (1,60 N) spinge la cremagliera **verso il legno**, mai in su, e il rollio residuo attorno alla fila di viti vale 0,008 mm, il 4% del gioco.

**Decisioni prese:**

- Contesto: la massa mobile sembrava il vincolo che teneva la macchina piccola. Una volta stabilito che il drag è costante, il tetto è salito da 1283 a 3410 g contro ~1150 stimati, e fra il formato più piccolo e il più grande ballavano 84 g.
  Decisione: **formato A4 in orizzontale**, corsa X ~230 con la cremagliera da 59 denti, corsa Y ~317.
  Alternative scartate: A4 verticale e formato quadro 300×300 — richiedono 317÷320 mm di corsa X, quindi una cremagliera giuntata; e l'A4 verticale non serve, perché per disegnarlo basta ruotare il file di 90° nel software. A5, che non aveva più nessuna ragione di essere.
  Da rivedere se: il portale finito pesa molto più dei ~1150 g stimati.

- Contesto: allungare la corsa X richiederebbe due segmenti di cremagliera.
  Decisione: **un pezzo solo, 282,743 mm (60 passi esatti)**, che resta giuntabile in futuro senza ridisegnare nulla.
  Alternative scartate: segmentare subito. Il rischio al giunto è asimmetrico — largo di 0,10 è un neo estetico in un punto, **stretto di 0,20 inceppa** — ed è un difetto permanente che si scopre dopo aver forato il listello.
  Da rivedere se: serve un formato oltre l'A4.

- Contesto: la catena delle quote verticali non chiude sui nominali. Sensibilità 0,728 mm di gioco per mm di altezza, budget ±0,275, tolleranze reali ±0,60 col multistrato.
  Decisione: **la cremagliera si stampa dopo aver misurato il legno**, impostando D sulle misure reali; il residuo si registra ai fori Ø4 del motore (±0,5 mm = ±0,364 di gioco) con il metodo della carta da 0,10 mm nel punto più stretto.
  **Supera la raccomandazione data poche ore prima nella stessa sessione** («lascia il file com'è e taglia il legno a 55,3»), che valeva solo finché il legno lo tagliava l'utente. Comprandolo già dimensionato, l'unico pezzo controllabile diventa quello stampato.
  Alternative scartate: **stare stretti e comprimere legno o PLA con le viti**. Il PLA a 15 MPa resta elastico e cede 0,02 mm, inutile; il legno di costa a quella pressione si impronta in modo permanente e continua a scorrere per settimane, di una quantità dello stesso ordine dell'intero budget. E stretto è il lato pericoloso: largo si shimma in dieci minuti, stretto va piallato un listello già forato e montato.
  Da rivedere se: il listello arriva imbarcato oltre 0,27 mm su 284 — allora si passa alle staffe stampate sul binario.

- Contesto: legno massello o multistrato per il riporto della cremagliera.
  Decisione: **multistrato, ricavato di costa da un pannello.**
  Alternative scartate: massello, che trasversalmente alla fibra si muove dell'1,2% su un'escursione stagionale — **0,66 mm su 55**, più del doppio dell'intero budget, con la macchina che si inceppa d'inverno e balla d'estate. Il multistrato nel piano si muove 0,05 mm.

- Contesto: scelta del riempimento della cremagliera fra gyroid, nido d'ape e triangoli.
  Decisione: **gyroid 25%, 4 perimetri, layer 0,16 mm.** Con 4 perimetri i denti sono massicci ovunque, quindi il pattern conta solo per la stabilità dimensionale: il gyroid non ha tratti rettilinei lunghi (nessuna direzione di ritiro privilegiata su 284 mm) e non si incrocia mai con se stesso.
  Alternative scartate: nido d'ape, che ripassa ogni cella più volte per layer sprecando tempo per una resistenza non necessaria; griglia (l'impostazione di partenza), che fa passare l'ugello sopra linee già depositate a ogni intersezione.

- Contesto: dove attaccare la trave dell'asse Y. Il piano iniziale erano le 4 viti superiori del motore, lasciate libere apposta.
  Decisione: **la trave Y si attacca al corpo del carrello.** Rafforza il punto già aperto il 2026-09-26 con una ragione nuova e decisiva: il motore sta a 58÷74 °C e il PLA ha la Tg a 60 — una staffa imbullonata sulla sua faccia sarebbe il pezzo di plastica **più caldo e più caricato della macchina**, in condizioni da manuale di scorrimento viscoso, mentre tutto il resto lavora a temperatura ambiente. Accettata dall'utente.
  Alternative scartate: attacco sulle viti del motore. Oltre al termico: rende i due estremi del portale diversi per costruzione (il motore ce l'ha un lato solo), e cambierebbe da entrambe le parti se si aggiunge il secondo motore.

- Contesto: dove mettere penna, motore e cremagliera sul carrello Y.
  Decisione: **tutti sul piano di simmetria della sezione**, con penna al centro dell'impronta dei cuscinetti e motore sfalsato **lungo la corsa** invece che di fianco. Azzera due errori su tre: l'imbardata non sposta ciò che sta sull'asse, e una forza sul piano di simmetria non genera torsione. Corollario: **la sezione deve avere un piano di simmetria**, quindi T e non L.
  Alternative scartate: penna all'estremità di un carrello a C (sketch 2) — 0,250 mm di imbardata più 0,209 di torsione, contro uno spessore di tratto di 0,3÷0,5.
  Da rivedere se: non si trova una T e nemmeno due angolari accoppiabili.

- Contesto: la cremagliera dell'asse Y su una seconda trave dedicata.
  Decisione: **cremagliera e guida sullo stesso corpo rigido**, con la cremagliera su una staffa stampata della trave che porta i cuscinetti.
  Alternative scartate: seconda trave. Farebbe dipendere la profondità d'ingranamento da quanto due pezzi distinti restano paralleli su 437 mm. Una staffa stampata si flette di 0,002 mm: per tenere una cremagliera non serve una trave.

- Contesto: il tratto di perno stampato fra due cuscinetti superiori coassiali, ~30 mm all'aria.
  Decisione: **due tronchetti contrapposti**, uno per cuscinetto, radicati ciascuno nella propria parete — la stessa soluzione già in uso sull'asse X, che mantiene l'accoppiamento Ø8,1/collare Ø10,1 già validato.
  Alternative scartate: **ingrossare il perno in mezzo** (suggerimento sbagliato, corretto dall'utente: il cuscinetto interno si infila dalla punta e non passerebbe oltre un tratto più grosso). Scartato anche il perno d'acciaio, che introdurrebbe un accoppiamento nuovo da mettere a punto per un guadagno che non serve — la resistenza ha già un coefficiente 84×, e il motivo per irrigidire è solo lo scorrimento viscoso.

**File consegnati/modificati:**
- `documento-sessione-cnc-2d.md` — v14 → v15
- Controllati (non modificati da me): `cremagliera_prova_2.step`, `cremagliera_prova_3.step`, `tot_prova_3.step`
- Nessun file di progetto toccato: la sessione è stata di analisi, misura e progettazione

**Impatto su Vision/Pipeline:** Step 5 — l'obiettivo passa da **A5 a A4 in orizzontale**, e la decisione sul formato del 2026-09-21 viene superata (testo precedente conservato). Aggiornato il blocco dei problemi aperti: chiusi il test della calamita, la caratterizzazione dell'attrito e la profondità del vano motore; aperti la misura del legno prima della stampa, il piano B con staffe sul binario, la specifica del profilo Y e il layout del carrello Y.

---

### [2026-09-26 17:48] Carrello validato in stampa, cremagliera verificata, e bilancio di coppia del motore

**Riepilogo:** il carrello a U rovesciata passa tutte le verifiche strutturali sullo STEP e scorre perfettamente in stampa con mezzo set di cuscinetti; la cremagliera modulo 1,5 con gioco 0,2 è disegnata, verificata al centesimo e provata con il pignone a doppia elica; intercettati prima della stampa quattro errori (interasse fori NEMA sbagliato di 2 mm, due perni fuori quota di 5 centesimi, cremagliera asimmetrica rispetto all'apice, dato di coppia del motore sbagliato di 3,3× nell'annuncio); e chiuso il bilancio di coppia, che con un motore pancake da 130 mN·m rende l'angolo di distacco del carrello un passa/non passa sotto i 7°.

**Cosa è stato fatto:**
- **Messa a punto della lettura degli STEP** come strumento di verifica: estrazione dei nomi dei componenti, ingombri, volumi, tutti i cilindri con diametro/asse/direzione, distanze e compenetrazioni fra solidi, sezioni ASCII e sonde puntuali per la continuità del materiale. Su questa base sono state fatte tutte le verifiche sotto
- **Carrello (`tot_prova_3`) verificato e approvato.** Corpo unico, fianchi da 3 mm continui su tutti gli 80 mm fra Z 10,8 e Z 34,2, perno alto annegato con 18 mm di materiale sopra (non a sbalzo come temuto), ponte a Z 52 che lega i fianchi al centro, **0,4 mm di aria dal binario** su tutta la corsa, 12 cuscinetti tangenti senza compenetrazione, 7,95 mm dal legno
- **Prova di stampa del carrello riuscita**: con i cuscinetti di sinistra e quelli centrali, inclinando il binario di ~30° il carrello scorre su tutta la lunghezza e torna indietro senza impuntarsi
- **Cremagliera disegnata, quotata e validata.** Consegnato il disegno con la cella unitaria da 6 punti per il pattern, la tabella nominale/con gioco e il posizionamento rispetto all'asse motore. Verificata sullo STEP dell'utente: passo 4,7124, spessore in testa 1,065, vano al piede 1,191, altezza 3,375 — tutto entro il mezzo centesimo
- **Stampa di prova della cremagliera riuscita e ingranamento con il pignone perfetto**, il che conferma anche che i due V della doppia elica sono concordi
- **Bilancio di coppia chiuso** sui dati reali dell'etichetta del motore (130 mN·m, 1,0 A, ~4,0 Ω, 204 g, pancake da 23 mm): punto di lavoro a 0,6 A con culla alleggerita → 4,42 N alla cremagliera, e target di attrito sotto i 7° di angolo di distacco. Trovato e quantificato il legame **corrente → calore → coppia**: alleggerire la culla del motore vale 0,1 A, cioè il 13% di coppia
- **Verifica del vano motore chiusa**, e il problema aperto segnalato in questa stessa voce risulta inesistente: il motore è un pancake da 23,1 mm, quindi il vano da 23,5 mm va bene. Emersi però 0,4 mm di gioco assiale, che superano i ±0,17 mm di centraggio della doppia elica
- **Montaggio del motore a 2 viti anteriori + 2 posteriori validato coi numeri**: le quattro viti formano un rettangolo di 31 × 40 mm nel piano orizzontale, e i carichi dell'ingranamento si traducono in 1,5 N e 4,1 N per coppia di viti. Confermata anche la scelta di non appendere l'asse Y al motore
- **Trovata un'interferenza geometrica** fra la cremagliera e il fianco del carrello: con il pignone a 1 mm dal fianco, il bordo interno della cremagliera cade 0,8 mm dentro il carrello. Vincolo ricavato: asse pignone a X ≤ −46,8
- **Alimentatore cambiato**: non più il 24 V della striscia LED ma un DVE DSA-36W-12 da **12 V / 3 A / 36 W**. Verificato che tre motori a 0,6 A assorbono 0,85 A (28% della portata) e che la tensione non incide né su coppia né su temperatura, perché l'A4988 regola corrente e non tensione

**Bug: interasse dei fori di fissaggio del motore sbagliato di 2 mm**

**Sintomo:** nessuno ancora — intercettato nel file `tot_prova_2` mentre la stampa di prova era in corso
**Causa:** i fori erano a 33,0 mm di interasse; il NEMA 17 li ha normati a 31,0. Ogni foro fuori di 1 mm, contro i ±0,5 che perdona un foro Ø4 attraversato da una vite M3
**Fix applicato:** corretto a 31,0 in `tot_prova_3`, verificato. Resta uno scarto di 0,62 mm fra il centro del pattern e l'asse del foro Ø37 (0,37 in Y, 0,50 in Z), che però è innocuo perché la cremagliera verrà posizionata a partire dal motore già montato

**Bug: due perni alti fuori quota di 5 centesimi**

**Sintomo:** nessuno — trovato confrontando tutti i cilindri dello STEP fra loro
**Causa:** i due perni della stazione a Y 0 erano Ø8,05 con collare Ø10,05, gli altri sei Ø8,1 / Ø10,1. Uno sketch modificato su una stazione e non sull'altra. Cinque centesimi stanno dentro il campo in cui la tolleranza dei perni era stata tarata, quindi quei due cuscinetti sarebbero venuti più lenti — e sono i perni alti, quelli che portano il peso
**Fix applicato:** uniformati tutti e otto a Ø8,1 — confermato dall'utente

**Bug: dato di coppia contraddittorio nell'annuncio del motore**

**Sintomo:** la descrizione dichiara "coppia elevata (130 mN·m (60 oz.in))", ma i due valori non sono la stessa cosa — 60 oz·in valgono 424 mN·m, cioè 3,3 volte 130
**Causa:** copia-incolla dalla variante da 40 mm, venduta sulla stessa pagina dal medesimo venditore
**Fix applicato:** assunto **130 mN·m**, verificato per coerenza fisica — la coppia scala col volume del rotore, e un 40 mm a 1,7 A dà 40 N·cm, quindi dimezzando il pacco e scendendo a 1,0 A si arriva esattamente a 12÷13 N·cm. Usando il dato sbagliato il bilancio di coppia sarebbe stato sovrastimato di tre volte, con il rischio di scoprirlo solo a macchina montata

**Bug: cremagliera asimmetrica rispetto all'apice del chevron**

**Sintomo:** nessuno in funzionamento, ma margine del pignone ridotto a 0,93 mm su un lato contro 2,66 sull'altro
**Causa:** nel trimmare la larghezza da 17,321 a 15,588 il taglio è stato fatto su un solo lato, lasciando l'apice del V a 8,660 da un bordo e 6,928 dall'altro. Con ±0,17 mm di tolleranza di centraggio, 0,93 è sottile — e soprattutto impedisce di riferire la cremagliera al proprio bordo in fase di montaggio
**Fix applicato:** resa simmetrica — confermato dall'utente

**Decisioni prese:**

- Contesto: la staffa del binario va rialzata di ~5 mm, e con l'asse motore a Z 74,65 la cremagliera cade a 53 mm sopra il piano del legno, servendo un supporto molto alto
- Decisione: **rialzo in legno, e motore lasciato alla quota attuale.** Un listello alto 53 mm avvitato alla base è più rigido di qualunque cosa stampata di quell'altezza, costa due euro e si fa in venti minuti
- Alternative scartate: (a) abbassare il motore infilandolo fra le due stazioni di cuscinetti, che avrebbe portato il supporto a 30 mm ma richiedeva di allargare l'interasse ruote da 60 a 70 mm perché il corpo da 42,3 entrasse nella finestra da 38; (b) motore ad asse verticale con cremagliera a denti laterali, supporto a 15 mm, scartata perché il pignone sarebbe finito in fondo a 24 mm di albero a sbalzo
- Da rivedere se: il listello di legno si muove con l'umidità in modo da alterare l'ingranamento lungo la corsa

- Contesto: serviva decidere se l'alloggiamento del motore fosse un pezzo separato bullonato o integrato nel carrello, e come garantire la regolazione dell'ingranamento in assenza di asole
- Decisione: **alloggiamento integrato nel carrello, e la cremagliera viene posizionata a partire dal motore già montato.** È il motore a dire dove va la cremagliera, non il contrario
- Alternative scartate: alloggiamento bullonato con asole verticali da ±2 mm, che era la raccomandazione iniziale. Diventa superfluo se l'elemento regolabile è la cremagliera
- Conseguenza operativa: la regolazione deve comunque esistere, e si sposta tutta sulla cremagliera — spessori sotto per la profondità di ingranamento, fori Ø5 nel listello per viti M3 per il centraggio laterale della doppia elica, e fori pilota della cremagliera forati **dopo** aver trovato la posizione. Ordine di montaggio: binario → carrello → motore → cremagliera
- Da rivedere se: si rende necessario smontare il motore dopo aver fissato la cremagliera, perché a quel punto non resta margine di recupero

- Contesto: il motore ha quattro fori di fissaggio anche sul coperchio posteriore, e l'utente voleva riservare i fori superiori all'attacco dell'asse Y
- Decisione: **due viti sulla flangia anteriore e due sul coperchio posteriore.** Verificato coi numeri: le quattro viti formano un rettangolo di 31 × 40 mm nel piano orizzontale, e i carichi dell'ingranamento si traducono in 1,5 N e 4,1 N per coppia di viti. Il motore è pienamente vincolato
- Alternative scartate: quattro viti sulla sola flangia anteriore, che avrebbe richiesto di portare la flangia fino a Z 90 occupando lo spazio destinato all'asse Y

- Contesto: il motore è un pancake da 23 mm con 130 mN·m, un terzo di un NEMA 17 da 40, e serviva capire quanto margine di coppia resta
- Decisione: **punto di lavoro a 0,6 A con la culla del motore alleggerita** (4,42 N alla cremagliera, carcassa a 58 °C), e **l'angolo di distacco del carrello diventa un passa/non passa: target sotto i 7°**, non più solo una metrica di qualità
- Alternative tenute in riserva, in ordine: accelerazione a 400 mm/s², pignone z17 (+18% forza *e* risoluzione migliore, stessa cremagliera), secondo motore, motore da 40 mm
- Da rivedere se: l'angolo misurato sul carrello completo supera i 10°

- Contesto: l'utente ha 5 motori e ha proposto di motorizzare anche il lato passivo per raddoppiare la forza sull'asse
- Decisione: **tenuta come riserva, non adottata adesso.** Raddoppia davvero la forza (4,42 → 8,84 N) e porta l'angolo tranquillo da 7° a 17°, al costo di 214 g di massa in più
- Realizzazione preferita se si adotta: **due motori in serie su un solo driver** — zero GPIO in più, zero driver in più, lockstep elettrico perfetto. A 12 V però la caduta resistiva si mangia 6,0 V dei 12 contro i 3,0 di un motore per driver, quindi con un A4988 di scorta conviene la strada dei due driver separati (`motor0`/`motor1` sullo stesso asse in FluidNC). In entrambi i casi i due lati vanno messi in fase meccanicamente al montaggio, facendo scorrere la seconda cremagliera con i motori alimentati
- Avvertenza registrata: **il secondo motore non riduce l'attrito, dà solo la forza per vincerlo.** Se il carrello parte a 20° e si aggiunge il motore, si è nascosto un difetto che continuerà a consumare alluminio e a fare rumore. Misurare prima l'angolo, decidere dopo

**File consegnati/modificati:**
- Disegno quotato della cremagliera m1,5 con gioco 0,2 — pubblicato come artefatto, aggiornato una volta (orientamento di stampa e metodo di fissaggio)
- `documento-sessione-cnc-2d.md` — questa voce, correzioni alle decisioni di Step 5 superate, nuove note di Step 5

**Impatto su Vision/Pipeline:** Step 1 — registrato il cambio di alimentatore (12 V / 3 A), che supera il dato del 2026-09-19. Step 5 — due decisioni progettuali superate (cuscinetti 623ZZ → 608 + MR63; precarico a molla → gioco sul dente più registrazione dell'ingranamento), quindici note nuove di cronologia, e la sezione dei problemi aperti rivista: il vano motore risulta risolto, mentre si aggiungono il parallelismo cremagliera-binario entro 0,17 mm e l'interferenza geometrica fra cremagliera e fianco. Nessun cambio alla Vision.

---

### [2026-09-25 12:17] Materiali acquistati: il progetto si adatta a quello che esiste in ferramenta

**Riepilogo:** scelto il cuscinetto giusto con un calcolo di pressione di contatto (623ZZ, Ø10, foro M3), acquistati i materiali reali, e scoperto che il profilo a U trovato in ferramenta ha esattamente le misure che servono per il canale progettato.

**Cosa è stato fatto:**
- Calcolata la pressione di contatto per nove misure di cuscinetto, da cui la scelta del 623ZZ
- Prodotto un modello 3D navigabile del carrello, con guide semitrasparenti per mostrare le ruote dentro il canale
- Acquistati i materiali: base, viti, angolare forato, profilo a U
- Verificate le corse ottenibili sulla base reale contro quelle necessarie per un A5
- Riviste tre proposte successive di carrello dell'utente, con le correzioni caso per caso

**Decisioni prese:**

- Contesto: i 608 acquistati risultavano troppo grandi (Ø22, metà della larghezza del motore) e gli MR62 disponibili in casa troppo piccoli
- Decisione: **623ZZ, 3 × 10 × 4**. A 3 N di carico preme sull'alluminio con 53 MPa, contro i 150 a cui cede — tre volte di margine. Canale interno 12 mm invece dei 24 richiesti dai 608
- Il motivo che ha pesato di più non è la pressione ma il foro: **3 mm significa M3, la stessa vite di tutto il resto della macchina.** Una sola misura di viteria su tutto il progetto
- Alternative scartate: 624ZZ (Ø13, più margine ma introduce le M4 come seconda misura); restare sugli MR62 (margine risicato e M2 scomode); restare sui 608 (canale da 24 mm, carrello sproporzionato)
- Supera la decisione del 2026-09-24 sui 608

- Contesto: l'utente proponeva un cuscinetto grande montato perpendicolare, in mezzo agli altri, per premere sulla guida
- Decisione: **scartata**
- Motivo: un cuscinetto rotola solo se il suo asse è perpendicolare alla direzione di marcia; con l'asse parallelo alla corsa striscia e si appiattisce in un punto. E un Ø32 in mezzo a quattro Ø22 sporgerebbe di 5 mm, diventando l'unico a toccare e sollevando gli altri
- È stata però recuperata l'intuizione sotto: un cuscinetto centrale su molla è un'alternativa valida all'eccentrico, scartata perché sulla guida serve rigidezza, non cedevolezza

- Contesto: l'utente proponeva superfici di rotolamento in gomma per chiudere il gioco da sole
- Decisione: **scartata sulle guide**
- Motivo: la gomma non elimina il gioco, lo trasforma in cedevolezza. Il carico cambia a ogni accelerazione e inversione, quindi il carrello si sposterebbe in modo variabile lungo tutto il disegno — peggio del gioco, che almeno è costante e compensabile. In più l'attrito di rotolamento si impenna e la gomma prende la forma se la macchina resta ferma
- Dove la cedevolezza serve è già prevista: la molla di precarico del pignone

- Contesto: come fissare i cuscinetti senza annegare nel calcolo degli ingombri di dadi e bulloni
- Decisione: **perni stampati Ø3 per le ruote fisse, viti M3 con tratto liscio per quelle regolabili**, e **asole al posto degli eccentrici**
- Motivo: il perno stampato regge (5,7 MPa contro i 50 del PLA) ma non si regola; l'asola dà tre millimetri di corsa dove un eccentrico ne dà uno. Una vite M8 con dado richiederebbe 30 mm di spazio contro i 7 del cuscinetto
- Supera l'indicazione sull'eccentrico data il 2026-09-24

- Contesto: l'utente proponeva di accorciare il carrello avvicinando le ruote, per guadagnare foglio
- Decisione: **non accorciare**, tenere le ruote a 80-100 mm lungo la corsa
- Motivo: con un decimo di gioco e la penna 60 mm sotto il piano delle ruote, 80 mm di interasse danno 0,075 mm di errore sulla punta e 40 mm ne danno 0,15 — al limite del visibile. E la corsa guadagnata non serve: sulla base reale ne avanzano già 65 mm
- Da rivedere se: la struttura definitiva riducesse la corsa disponibile sotto i 260 mm in Y

**File consegnati/modificati:**
- Pagina pubblicata: modello 3D navigabile del carrello — https://claude.ai/artifact/CTT88x6q9LKyBt84rNhPLA
- Pagina aggiornata: disposizione dei cuscinetti, con la tavola sulla disposizione in larghezza — https://claude.ai/artifact/KyA5zQpxbfWVwYeRFV9S6S

**Impatto su Vision/Pipeline:** Step 5 aggiornato nelle decisioni su cuscinetti, fissaggio, regolazione e base. Aggiunta la decisione del profilo unico a U, che rende superflua sull'asse X la regola della guida maestra (mantenuta per l'asse Y, dove le guide restano due pezzi distinti). Sostituita l'indicazione della base in MDF con il compensato effettivamente acquistato. Aggiunto il principio che lunghezza e larghezza del carrello hanno costi diversi.

---

### [2026-09-24 18:44] Dall'SVG al G-code nell'interfaccia, e progetto meccanico con modulo 1,5

**Riepilogo:** costruita da zero l'interfaccia web che porta un SVG fino al G-code ottimizzato con stima del tempo, e impostato il progetto meccanico — modulo 1,5 stampato, primo pignone provato, carrello su cuscinetti radiali 608 al posto dei cuscinetti lineari previsti.

**Cosa è stato fatto:**
- Servo validato al banco: cablaggio ripassato, prova partendo dal centro della corsa verso gli estremi, nessun ronzio di fondo corsa. Prodotto il G-code di prova con i movimenti della penna (Z-3 alzata, Z-7 abbassata, valori provvisori al centro della corsa)
- Costruita l'interfaccia web in `webui/`: impalcatura, piano macchina fisso con reticolo, foglio trascinabile, importazione SVG, ottimizzazione del percorso, generazione del G-code, stima del tempo
- Consegnate tre pagine pubblicate: anteprima dell'interfaccia, disegno quotato della cremagliera, disposizione dei cuscinetti sul carrello
- Stampato e provato il primo pignone, in versione dritta e a doppia elica
- Definite tutte le quote della cremagliera, i segmenti di stampa e lo schema di fissaggio

**Bug: quota della cremagliera etichettata male**

**Sintomo:** nel primo elenco di quote consegnato, la voce "larghezza del vano al fondo" riportava 3,721 mm.
**Causa:** 3,721 mm è lo spessore del *dente* misurato sulla linea di fondo. Il vano fra due denti è 0,992 mm. Errore di etichetta mio, non di calcolo.
**Fix applicato:** corretto e segnalato all'utente prima che disegnasse lo sketch. Nel disegno quotato definitivo le quote ambigue sono sostituite dalle **coordinate dei sei punti del profilo**, che non si prestano a interpretazioni.

**Bug: orientamento di stampa della cremagliera consigliato male**

**Sintomo:** avevo indicato di stampare la cremagliera coricata su un fianco, per avere il profilo del dente tracciato dall'ugello invece che dalla sovrapposizione degli strati.
**Causa:** il consiglio ignorava la flangia di fissaggio — che in quella posizione resta in aria — e sopravvalutava la debolezza fra gli strati.
**Fix applicato:** rifatto il conto. La forza sul dente è al massimo 9 N, che sulla sezione di base dà 0,08 MPa contro i 20÷30 MPa a cui cede l'adesione fra strati: trecento volte di margine. Consiglio cambiato in **denti in su, flangia sul piatto**, con strati da 0,10 mm perché a 20° di fianco ogni layer arretra di 0,036 mm.

**Decisioni prese:**

- Contesto: il modulo 1 previsto è al limite di quanto una FDM stampa in modo affidabile
- Decisione: **modulo 1,5 con 20 denti**, 33,95 passi/mm, risoluzione 0,029 mm
- Alternative scartate: modulo 1 (denti troppo fragili) e modulo 2 (risoluzione 0,039 mm e dente più alto, che rende l'allineamento col precarico più critico)
- Supera la decisione del 2026-09-21 — la risoluzione non è il fattore limitante, visto che l'errore reale sarà dieci volte maggiore, quindi il margine si spende in robustezza

- Contesto: avevo consigliato di comprare cremagliera e pignone in POM per contenere il gioco
- Decisione: **stampare tutto**, comprese le dentature
- Alternative scartate: acquisto della cremagliera — l'utente ha scelto la stampa, e la prova sul primo pignone ha confermato che le tolleranze reggono
- Da rivedere se: il provino da 25 denti mostrasse un ingranamento inaccettabile

- Contesto: erano stati consigliati cuscinetti lineari LM8UU su barre rettificate, ma l'utente ha acquistato cuscinetti radiali 608
- Decisione: **carrello con 608 che rotolano su guide in alluminio**, 11 per carrello, con una guida maestra e una secondaria libera lateralmente e un eccentrico per il contrasto laterale
- Alternative scartate: cuscinetto grande montato con l'asse parallelo alla corsa — non rotolerebbe, striscerebbe, appiattendosi in un punto; e un Ø32 in mezzo a quattro Ø22 diventerebbe l'unico a toccare, sollevando gli altri
- Supera la decisione del 2026-09-21 sulle guide a barre tonde

- Contesto: il pignone sembrava troppo grande perché i cuscinetti non trovavano spazio
- Decisione: **bande laterali separate** per motore, pignone con cremagliera e cuscinetti
- Alternative scartate: rimpicciolire il pignone — non risolverebbe, perché il vincolo viene dal corpo del motore che resta 42 × 42 comunque

**File consegnati/modificati:**
- `webui/` — nuova: `index.html`, tre fogli di stile, dieci moduli JavaScript, `tools/build.py`, `tools/make-sample.py`, `README.md`
- `gcode/test/quadrato-e-cerchio-penna.gcode` — nuovo, con i movimenti del servo
- `gcode/test/README.md` — aggiornato con le quote provvisorie della penna
- Pagina pubblicata: anteprima dell'interfaccia — https://claude.ai/artifact/Sq9d4MVjUBujRCgK682BXA
- Pagina pubblicata: disegno quotato della cremagliera — https://claude.ai/artifact/5TmiPjPf3sXv4orV8ntco7
- Pagina pubblicata: carrello su cuscinetti 608 — https://claude.ai/artifact/KyA5zQpxbfWVwYeRFV9S6S

**Impatto su Vision/Pipeline:** Step 4 passa da "da fare" a **in corso**, con cinque decisioni progettuali aggiunte e la cronologia dei progressi. Step 5 aggiornato nelle decisioni su guide, pignone e corse: le voci su LM8UU, modulo 1 e corsa Y da 260 mm sono state sostituite, e la sostituzione è motivata qui sopra.

---

### [2026-09-21 11:18] FluidNC installato, configurato e validato: la macchina si muove sotto G-code

**Riepilogo:** FluidNC 4.1.0 installato e messo in rete, configurazione accettata senza modifiche dallo schema 4.x, microstepping 1/16 verificato su entrambi gli assi e primi movimenti coordinati eseguiti — ma solo dopo aver trovato un errore di polarità che avevo introdotto io nella configurazione dell'ENABLE condiviso.

**Cosa è stato fatto:**
- Installazione di FluidNC v4.1.0 dal web installer, variante esp32-wifi, fresh-install con WebUI-2
- Configurazione WiFi in modalità client: hostname `cnc2d`, IP 192.168.1.11, mDNS attivo
- Caricamento e attivazione di `cnc2d-config.yaml`, con verifica riga per riga dell'output del validatore
- Verifica funzionale dei tre LED di stato via `M62`/`M63`
- Realizzazione dei ponticelli di microstepping (MS1/MS2/MS3 a VDD) su entrambi i driver, e verifica a 3,3 V con il multimetro prima di dare corrente
- Esecuzione del quadrato da 40 mm e del cerchio da raggio 20 mm: **Step 3 completato**
- Creati due file di G-code di prova nel repository, con il relativo README

**Bug: i motori non si muovono nonostante gli impulsi siano corretti**

**Sintomo:** FluidNC eseguiva i comandi di movimento in modo apparentemente perfetto — `ok` in risposta, coordinate che avanzavano da 0 a 40.000 alla velocità giusta, stato che passava da `Jog` a `Idle`, nessun errore da nessuna parte — ma i motori restavano completamente immobili e gli alberi molli al tatto. Ripetibile su entrambi gli assi.

**Causa:** nella configurazione avevo scritto `shared_stepper_disable_pin: gpio.27:low`. Il `:low` è sbagliato, e il motivo è controintuitivo: il pin dell'A4988 si chiama ENABLE ed è attivo basso, il che suggerisce appunto `:low`. Ma il campo di FluidNC si chiama *disable*, e ci viene scritto "vero" quando i motori vanno spenti; sull'A4988 si spegne portando il pin ALTO. Visto da FluidNC è quindi un disable **attivo alto**, cioè senza modificatore. Con `:low` la logica si ribalta e FluidNC, volendo tenere i motori sempre energizzati per via di `idle_ms: 255`, teneva il pin alto — cioè li teneva spenti.

**Fix applicato:** rimosso il `:low` dalla configurazione, file ricaricato sull'ESP32 e riavviato. Verificato: i motori ora sono energizzati fin dall'avvio e rispondono ai comandi. La prova diagnostica che ha isolato la causa è stata staccare il filo ENABLE dal lato del driver: l'A4988 ha un pull-down interno su quel pin, quindi scollegato si abilita da solo, e vedere il motore girare in quelle condizioni ha dimostrato che tutto il resto (VMOT, STEP, DIR, taratura del Vref, cablaggio) era a posto e che il guasto era nella polarità in configurazione.

**Bug: due errori di battitura diagnosticati come guasti hardware**

**Sintomo:** in due occasioni distinte, comportamenti che sembravano guasti seri. Primo caso: FluidNC continuava a caricare la configurazione di default ignorando la nostra. Secondo caso: nessun movimento dei motori accompagnato da una disconnessione dell'interfaccia.

**Causa:** nel primo caso il comando inviato era `$Config/Filename=cnc2d-config.yalm` — estensione `.yalm` invece di `.yaml`, con le due lettere centrali invertite. FluidNC cercava un file inesistente e ricadeva sul default, dicendolo chiaramente con `Cannot open configuration file`. Nel secondo caso il comando era `$J=G91 X40 F500v`, con una `v` in fondo: incollando con Ctrl+V, il campo comandi della WebUI in alcuni browser intercetta la scorciatoia a metà e scrive la lettera insieme al testo. Il comando veniva rifiutato con `error:2 Bad GCode number format` e non veniva eseguito nulla.

**Fix applicato:** comandi reinviati corretti. Nessuna modifica al sistema. Registrato nel README dei file di prova, perché la `v` fantasma è un comportamento del browser che si ripresenterà.

**Decisioni prese:**
- Contesto: i file di G-code di prova andavano eseguiti con il servo non ancora tarato
- Decisione: **nessun comando sull'asse Z nei file di prova**. Si muovono solo X e Y
- Alternative scartate: includere un alza/abbassa penna per provare anche il servo. Scartata perché gli estremi `min_pulse_us`/`max_pulse_us` in configurazione sono valori di partenza non verificati, e mandare un SG90 a una posizione arbitraria rischia di portarlo in battuta meccanica, dove assorbe molto e forza gli ingranaggi
- Da rivedere se: dopo la taratura del servo, i file di prova possono essere estesi con i movimenti di penna

**File consegnati/modificati:**
- `firmware/fluidnc/cnc2d-config.yaml` — corretta la polarità di `shared_stepper_disable_pin`, con commento esteso sul perché
- `firmware/fluidnc/README.md` — aggiunta la trappola della polarità dell'ENABLE e la prova diagnostica
- `gcode/test/quadrato-40mm.gcode` — nuovo
- `gcode/test/cerchio-r20.gcode` — nuovo
- `gcode/test/README.md` — nuovo

**Impatto su Vision/Pipeline:** Step 3 passa da "in corso" a **completato**. Aggiunte alle sue note la conferma che lo schema 4.1.0 accetta la configurazione scritta sul 3.x (il dubbio sollevato nella voce delle 09:57 è risolto), la procedura di attivazione effettivamente funzionante e l'esito delle verifiche su LED e microstepping.

---

### [2026-09-21 09:57] Progetto della struttura meccanica e installazione di FluidNC

**Riepilogo:** Progettata la meccanica — portale a cremagliera e pignone stampati in 3D su base di legno, formato A5 — e avviata l'installazione di FluidNC sull'ESP32 con le scelte di versione e interfaccia.

**Cosa è stato fatto:**

- Definita l'architettura meccanica completa e aggiunto lo **Step 5** alla pipeline, che finora non prevedeva nessuno step per la struttura fisica
- Individuato il rischio principale della cremagliera — il gioco fra i denti stampati — e la contromisura: motore su piastrina oscillante con precarico a molla contro la cremagliera
- Chiarito che il vincolo di ritegno del carrello e la libertà di flottare del motore non sono in conflitto, perché agiscono su corpi diversi
- Definito il metodo di taratura in loco di `steps_per_mm` e la misura del gioco
- Avviata l'installazione di FluidNC dal web installer, con le scelte guidate passo per passo

**Decisioni prese:**

- Contesto: come trasmettere il moto ai due assi
- Decisione: **cremagliera e pignone stampati in 3D**, con precarico a molla del pignone
- Alternative scartate: cinghia GT2 con motori fissi, che avrebbe gioco quasi nullo e meno massa mobile, ma richiede componenti acquistati. Resta la via di ripiego, sostituibile senza rifare la struttura
- Da rivedere se: il gioco misurato restasse sopra 0,3 mm anche dopo aver messo a punto il precarico
- Supera l'assunzione implicita del 2026-09-21 09:15, dove `steps_per_mm` era stato ipotizzato a 80 partendo da una trasmissione a cinghia

- Contesto: il formato massimo di lavoro, che fissa le corse e la luce del portale
- Decisione: **A5**, con corse di circa 200 × 260 mm
- Alternative scartate: A4, rimandato — un portale più largo accentua la tendenza del ponte a mettersi di traverso, essendo spinto da un lato solo

- Contesto: quale interfaccia web installare fra WebUI-2, WebUI-3 e FigUI
- Decisione: **WebUI-2**, perché è quella su cui è costruita la documentazione del wiki e nei prossimi giorni servirà leggerla
- Alternative scartate: le altre due, non per demerito ma perché se ne può installare una sola e occupano lo stesso spazio; tenerne una lascia anche memoria libera per la pagina che costruiremo

**File consegnati/modificati:**

- `documento-sessione-cnc-2d.md` — aggiornato alla versione 6, aggiunto lo Step 5

**Impatto su Vision/Pipeline:** Aggiunto **Step 5 — Struttura meccanica**, che copre una parte del progetto finora assente dalla pipeline. Aggiornata la nota sul microstepping dello Step 3, che assumeva una trasmissione a cinghia.

---

### [2026-09-21 09:15] Secondo asse, pen-lift e scelta di FluidNC come firmware definitivo

**Riepilogo:** Completato lo Step 2 con il secondo motore e il controllo del servo, poi presa la decisione architetturale del progetto — FluidNC al posto del firmware custom — e progettata l'interfaccia web che farà da slicer e da pannello di controllo.

**Cosa è stato fatto:**

- Cablato e collaudato l'asse Y (STEP D25, DIR D33, ENABLE condiviso su D27); firmware esteso a due assi con velocità e rampa indipendenti per asse, regolabili da slider
- Aggiunta l'inversione di direzione per asse, salvata in memoria non volatile: serve a rimediare a un asse montato al contrario senza toccare cavi né codice
- Aggiunto il controllo del servo pen-lift su D32 con due posizioni calibrabili, pilotato dal periferico LEDC nativo senza librerie esterne. All'accensione il servo parte rilasciato: uno che va in battuta contro un vincolo meccanico appena riceve corrente assorbe moltissimo
- Scritta la configurazione FluidNC di partenza e riqualificato lo sketch esistente come strumento di collaudo

**Bug: il motore Y gira da solo appena alimentato**

**Sintomo:** al primo collegamento del secondo driver, il motore Y ruotava in continuo verso destra senza nessun comando.
**Causa:** D25 e D33 non erano ancora configurati come uscite nel firmware. Restando ingressi ad alta impedenza raccoglievano il ronzio di rete e il rumore di commutazione, che il driver leggeva come impulsi di STEP.
**Fix applicato:** i pin STEP vengono portati a livello basso come prima istruzione di `setup()`, prima di qualsiasi altra inizializzazione. **Confermato.**

**Decisioni prese:**

- Contesto: per disegnare servono interpretazione del G-code, movimento coordinato dei due assi e pianificazione dell'accelerazione fra segmenti consecutivi — la parte dove si sbaglia in modi difficili da diagnosticare
- Decisione: **FluidNC diventa il firmware definitivo**; lo sketch custom retrocede a banco di collaudo hardware e resta nel repo, perché è lo strumento che ha permesso di trovare un driver con l'ingresso STEP in corto
- Alternative scartate: completare il firmware custom, stimato in settimane di lavoro per riprodurre funzionalità già collaudate su migliaia di macchine
- Nota: il lavoro sul generatore di G-code non dipende da questa scelta, perché produce G-code standard in entrambi i casi
- Da rivedere se: FluidNC si rivelasse troppo rigido per qualche esigenza specifica del pen-lift

- Contesto: come passare da un'immagine al G-code
- Decisione: tutta l'elaborazione nel browser con algoritmi di tracciamento deterministici, partendo dal solo SVG
- Alternative scartate: delegare la vettorializzazione a un modello generativo esterno con prompt da copiare e incollare — un modello linguistico non ricalca un'immagine, inventa percorsi plausibili e non ripetibili; e l'elaborazione a bordo dell'ESP32, fuori portata per la sua RAM

- Contesto: come conoscere l'area di lavoro senza finecorsa di riferimento
- Decisione: **azzeramento manuale** — le dimensioni del foglio si calibrano una volta sola e si salvano, l'origine si ristabilisce a inizio sessione portando il carrello nell'angolo. Due pulsanti nell'angolo in basso a sinistra restano come finecorsa rigidi di emergenza
- Alternative scartate: finecorsa di riferimento su entrambi gli assi, rimandabili in qualsiasi momento perché automatizzerebbero semplicemente la procedura manuale
- Conseguenza: i driver non vanno mai disabilitati, altrimenti un asse spostato a mano farebbe perdere la posizione. Annulla l'idea di un auto-spegnimento dopo inattività, discussa nella stessa sessione

- Contesto: l'alimentazione, dopo aver valutato di alimentare tutto dai 12 V con un regolatore
- Decisione: **si resta sulla batteria 18650** per la logica e il servo, con i motori sui 12 V. Consumo medio ~140 mA a 5 V, che su una cella da 3000 mAh dà una decina di ore — ben oltre le 5-6 richieste
- Alternative scartate: step-down 12 V→5 V per alimentare tutto dalla presa, e regolatore lineare 7805, scartato perché dissiperebbe 5 W con il servo in movimento e andrebbe in protezione termica facendo riavviare l'ESP32

**File consegnati/modificati:**

- `firmware/fluidnc/cnc2d-config.yaml` — creato
- `firmware/fluidnc/README.md` — creato
- `firmware/cnc2d_dashboard/cnc2d_dashboard.ino` — modificato (due assi, inversione, servo)
- `firmware/cnc2d_dashboard/README.md` — modificato (riqualificato come strumento di collaudo)

**Impatto su Vision/Pipeline:** Step 2 completato. Step 3 riscritto attorno a FluidNC e passato a "in corso". Step 4 riscritto da "software slicer" a "interfaccia web e generazione G-code", con le decisioni di architettura prese in questa sessione.

---

### [2026-09-20 18:18] Motore X funzionante: la causa era l'alimentatore, non il cablaggio

**Riepilogo:** Dopo una lunga diagnosi sistematica si è scoperto che l'alimentatore "24V" riciclato era in realtà un controller per strisce LED RGB con uscite in PWM — causa di tutti i sintomi della sessione e della distruzione di due driver A4988; sostituito con un alimentatore DC 12V/3A e con il terzo modulo, il motore X gira correttamente.

**Cosa è stato fatto:**

- Revisione completa del firmware, con tre difetti reali corretti: il movimento a giro completo bloccava per 3 secondi dentro l'handler HTTP affamando web server e OTA; lo stepping in `loop()` subiva il blocco di `server.handleClient()` producendo cadenze irregolari; DIR veniva riscritto a ogni impulso invece che una volta a inizio movimento
- Aggiunta una tab "Motore" con intervallo dei passi, numero di passi, rampa di accelerazione, abilitazione diretta del driver e forzatura dei singoli pin per la misura col multimetro; ogni movimento registra nel log i passi effettivamente emessi
- Scartata l'ipotesi delle resistenze di shunt sbagliate: lette `R100` sul modulo, quindi il Vref di 0,55 V per 0,69 A/fase era corretto fin dall'inizio
- Diagnosi condotta misurando uno per uno tutti i pin del driver (VDD, MOT, RST, SLP, EN, STEP, DIR) invece di procedere per ipotesi

**Bug: alimentatore di potenza inutilizzabile**

**Sintomo:** VMOT oscillante tra 1 V e 20 V invece che ferma; coppia di tenuta debolissima; passi singoli a volte corretti, rotazione continua mai; comportamento che cambiava toccando i fili.
**Causa:** l'alimentatore riciclato è un controller per strisce LED RGB. Il bianco è il +24V comune, rosso/verde/blu sono uscite di canale pilotate in PWM. Usare il rosso come massa significava alimentare il driver attraverso un interruttore che si apriva e chiudeva continuamente. Confermato misurando sotto carico su tutti e tre i canali.
**Fix applicato:** sostituito con alimentatore switching DC 12V/3A, misurato stabile a 12,2 V. **Confermato.**

**Bug: secondo driver A4988 con ingresso STEP in corto**

**Sintomo:** con l'alimentazione risolta l'albero era finalmente bloccato e il test ENABLE rispondeva, ma nessun comando muoveva il motore e il pin STEP sul driver leggeva sempre 0 V pur avendo continuità verso D4.
**Causa:** ingresso STEP in corto verso massa dentro il chip. Localizzato dividendo il nodo in due metà: lato ESP32 muto, lato driver 0,2 Ω, e sfilando il modulo la breadboard tornava muta. Danno provocato dall'alimentatore RGB.
**Fix applicato:** terzo modulo A4988, collaudato prima dell'installazione. **Confermato.**

**Bug: il motore gira solo con passi singoli (aperto dalla sessione precedente)**

**Sintomo:** vedi voce del 2026-09-20 09:45.
**Causa:** l'alimentatore RGB. L'ipotesi precedente sui pin GPIO16/17 riservati al PSRAM era **sbagliata**.
**Fix applicato:** risolto dalla sostituzione dell'alimentatore. **Confermato** — il motore X ora gira su comando dalla dashboard.

**Decisioni prese:**

- Contesto: l'alimentatore riciclato dalla striscia LED si è rivelato un controller PWM e aveva già distrutto due driver A4988
- Decisione: passare a un alimentatore switching DC **12V/3A**, e rendere obbligatorio un condensatore elettrolitico da 100 µF / 50 V tra VMOT e GND del driver
- Supera la decisione del 2026-09-20 09:45 sull'uso dell'alimentatore 24V riciclato, e corregge il dato allora registrato secondo cui "il filo bianco è il vero 24V+ e il rosso è il GND": il rosso non è una massa, è un'uscita di canale
- Alternative scartate: aprire l'alimentatore per bypassare il controller (pericoloso, è collegato alla rete); impostare il controller su un colore fisso al massimo (il MOSFET di canale non è dimensionato per un carico induttivo e qualsiasi cambio di modalità fermerebbe il motore)
- Da rivedere se: servisse più coppia ad alta velocità, caso in cui si potrebbe passare a 24V con un alimentatore DC vero

- Contesto: due moduli A4988 persi senza accorgersene subito, con ore di diagnosi spese a cercare il guasto altrove
- Decisione: collaudare ogni nuovo modulo prima di alimentarlo, verificando che la continuità tra STEP, DIR, EN e GND sia muta su tutti e tre
- Da rivedere se: si adottasse un driver diverso con pull-down interni sugli ingressi, che renderebbero il test non significativo

**File consegnati/modificati:**

- `firmware/cnc2d_dashboard/cnc2d_dashboard.ino` — modificato
- `firmware/cnc2d_dashboard/README.md` — modificato (formula del Vref e dipendenza dalle resistenze di shunt, condensatore di bulk obbligatorio, documentazione della tab Motore)
- `documento-sessione-cnc-2d.md` — aggiornato alla versione 4

**Impatto su Vision/Pipeline:** Step 2 resta "in corso" ma il primo motore è validato; restano il secondo asse e la verifica della velocità di lavoro. Aggiornata la decisione sull'alimentazione di potenza e aggiunto il collaudo di accettazione dei driver.

---

### [2026-09-20 09:45] Dashboard estesa (LED, OTA, log) e avvio debug driver A4988/motore X

**Riepilogo:** Ampliata la dashboard con più LED, aggiornamento firmware via Wi-Fi (OTA) e una tab di log da remoto; avviato lo Step 2 con il cablaggio completo del driver A4988 e del motore X, un primo driver risultato guasto e sostituito, Vref tarato correttamente, ma il motore gira in modo affidabile solo a passi singoli — bug non ancora risolto a fine sessione, in attesa di verifica dopo aver spostato DIR/ENABLE dai pin D16/D17 a D26/D27.

**Cosa è stato fatto:**
- Aggiunti alla dashboard 2 nuovi LED (verde D18, giallo D19) con pulsanti dedicati Rosso/Giallo/Verde; disabilitato il pulsante centrale del joystick (non più usato per il LED)
- Aggiunto supporto ArduinoOTA per aggiornare il firmware via Wi-Fi dopo il primo upload via USB (password uguale a quella dell'AP di emergenza)
- Aggiunta una tab "Log" nella dashboard che mostra via web gli stessi messaggi altrimenti visibili solo sul Serial Monitor — necessaria perché il Serial Monitor via USB non è utilizzabile quando si carica il firmware via OTA
- Collegato fisicamente il driver A4988 al motore X (fase logica: GND/VDD/RESET-SLEEP/STEP/DIR/ENABLE; fase di potenza: VMOT/GND da alimentatore 24V riciclato da striscia LED RGB, identificando con il multimetro che il vero 24V+ è il filo bianco e il GND è il filo rosso, non il contrario)
- Riadattata una scheda "Nano Terminal Adapter" (per Arduino Nano) a morsettiera generica per i collegamenti di potenza, sfruttando la sua natura puramente passiva
- Identificate le due bobine del motore (rosso+blu, nero+verde) via continuità e collegate al driver
- Collegati sulla dashboard i controlli motore: frecce sinistra/destra (passo singolo al click, rotazione continua non bloccante tenendo premuto) e due pulsanti "Giro completo" per un test rapido da 200 passi
- **Bug: primo driver A4988 non muoveva il motore** — Sintomo: nessuna reazione a "Giro completo", solo un leggero ronzio. Causa: sospetto danneggiamento del chip (tutti i controlli di continuità risultati corretti). Fix applicato: sostituito con un secondo modulo di scorta, che ha mostrato un primo movimento (parziale)
- **Bug: Vref bloccato a 0,20V, il trimmer sembrava non avere effetto** — Causa: misura instabile per il motore collegato durante la prova. Fix applicato: misurato a motore scollegato, tarato correttamente a 0,55V
- **Bug: il motore gira solo a passi singoli, non in sequenza continua** — Sintomo: click singoli puliti e senza perdita di passi, ma pressione prolungata o "Giro completo" non muovono il motore (o lo muovono a scatti di ~1/5 di giro senza completare la rotazione). Causa non confermata: un test del "wiggle" ha mostrato che muovere il filo ENABLE (D17) durante il funzionamento fa partire il motore, anche sostituendo il filo o cambiando i fori della breadboard, pur con continuità elettrica corretta a riposo — si sospetta un comportamento specifico dei pin GPIO16/17 su alcune varianti ESP32 con PSRAM (WROVER), non confermato con certezza dalla foto del modulo (etichettato solo "ESP-32"). Fix applicato: spostati DIR (D16→D26) ed ENABLE (D17→D27); esito del test non ancora riportato a fine sessione

**Decisioni prese:**
- Contesto: serviva un modo per vedere i log del firmware una volta passati all'aggiornamento via OTA, dato che il Serial Monitor USB non è più disponibile in quel caso
- Decisione: aggiunta una tab "Log" nella dashboard che replica via HTTP i messaggi altrimenti mandati solo su Serial
- Alternative scartate: nessuna, soluzione diretta senza alternative valutate
- Contesto: servivano morsetti a vite per i collegamenti di potenza (24V e motore) ma non erano disponibili morsetti dedicati
- Decisione: riadattata una scheda "Nano Terminal Adapter" (per Arduino Nano) come morsettiera generica, usando ogni colonna come nodo elettrico indipendente
- Alternative scartate: acquistare morsetti dedicati — scartata per procedere subito con quello che si aveva già disponibile
- Da rivedere se: si rendono disponibili morsetti a vite dedicati, più adatti per un assemblaggio permanente

**File consegnati/modificati:**
- `firmware/cnc2d_dashboard/cnc2d_dashboard.ino` (modificato: LED aggiuntivi, OTA, log, controlli motore, pin DIR/ENABLE spostati)
- `firmware/cnc2d_dashboard/README.md` (aggiornato di pari passo)

**Impatto su Vision/Pipeline:** Step 2 passato da "da fare" a "in corso"; aggiunte le decisioni progettuali su pin driver, mappatura bobine, alimentatore riciclato e uso della morsettiera adattata. Bug del motore non ancora risolto: da riprendere nella prossima sessione verificando l'esito dello spostamento pin DIR/ENABLE.

---

### [2026-09-19 09:25] Dashboard web ESP32 con controllo LED e configurazione Wi-Fi

**Riepilogo:** Creata e validata una dashboard web autonoma sull'ESP32 (frecce direzionali placeholder, pulsante centrale per il LED, tab Wi-Fi e tab Codice) con provisioning Wi-Fi da browser e fallback ad Access Point di emergenza; testata con successo sia via USB sia a batteria.

**Cosa è stato fatto:**
- Analizzata la fattibilità di una dashboard web ospitata direttamente sull'ESP32 e di un "tab codice" stile Arduino IDE nel browser; chiarito che l'ESP32 non può compilare sketch C++ da solo, quindi il tab Codice sarà usato in futuro per l'upload diretto di file G-code (non di sorgenti da compilare), da attivare dopo aver validato motori/servo (Step 2-3)
- Implementato lo sketch `firmware/cnc2d_dashboard/cnc2d_dashboard.ino`: web server nativo (`WebServer.h`) con pagina unica a 3 tab (Controllo, Wi-Fi, Codice), pulsante centrale che accende/spegne il LED su D2, frecce direzionali presenti ma non collegate
- Aggiunta gestione Wi-Fi via web: credenziali salvate in NVS (`Preferences`), form nella tab Wi-Fi per cambiarle senza ricompilare, fallback automatico ad Access Point `CNC-2D-Setup` se la connessione alla rete salvata fallisce, mDNS (`cnc2d.local`) per raggiungere la dashboard senza dipendere dall'IP assegnato dal router
- **Bug: errore di compilazione "unterminated raw string"**
  **Sintomo:** Arduino IDE segnalava stringa raw non terminata durante la compilazione dello sketch
  **Causa:** l'utente aveva copiato il codice a mano in un nuovo sketch anziché aprire il file `.ino` originale, con probabile perdita dell'ultima riga di chiusura della stringa raw durante il copia-incolla
  **Fix applicato:** scaricato il file raw direttamente da GitHub e incollato per intero — verificato e compilazione riuscita
- Testata l'intera dashboard: provisioning Wi-Fi di casa dalla tab dedicata, raggiungibilità su `http://cnc2d.local`, controllo LED su D2 funzionante sia con ESP32 alimentato da USB sia da batteria 18650+interruttore

**File consegnati/modificati:**
- `firmware/cnc2d_dashboard/cnc2d_dashboard.ino` (nuovo)
- `firmware/cnc2d_dashboard/README.md` (nuovo)

**Impatto su Vision/Pipeline:** Aggiunto il nuovo sotto-step "Step 1.1 — Dashboard web di controllo e test" (completato) all'interno dello Step 1, non previsto esplicitamente nella pipeline originale ma propedeutico al controllo assi (Step 2) e al futuro upload G-code (Step 4).

---

### [2026-09-19 10:03] Bring-up hardware ESP32: alimentazione USB e batteria completati

**Riepilogo:** Verificata la compatibilità dei componenti scelti (batteria, motori, driver, alimentatore), completato il bring-up dell'ESP32 con test LED su D2 sia via USB che via batteria 18650+interruttore; prossimo passo il codice per driver A4988/motori.

**Cosa è stato fatto:**
- Analizzata e corretta la conversazione tecnica avuta con Gemini sulla compatibilità batteria NASTIMA / motori NEMA17 17HS4023 / driver A4988 / alimentatore 24V riciclato da striscia LED (corretta imprecisione sulla corrente nominale motore: 0.7A/fase, non 1.0A; segnalata mancanza di un regolatore dedicato per la logica ESP32; chiarito l'uso del PWM spindle/laser per il pen-lift invece di un asse Z vero)
- Verificato il modulo di carica/boost per 18650 (Type-C, boost 5V, supporto "discharge while charging")
- Pianificata la sequenza di bring-up: GND comune → ESP32 standalone → driver a vuoto → un motore → due motori → config FluidNC
- Montato l'ESP32 su breadboard e identificate le etichette reali sulla scheda fisica (prefisso D, es. D2, VIN, GND — diverse dal pinout generico GPIO/ADC del listing Amazon)
- Test funzionale con sketch Blink su D2 + LED + resistenza 220 ohm via Arduino IDE — riuscito
- Aggiunto interruttore sulla linea 5V+ (tra modulo batteria 18650 e VIN dell'ESP32, non sulla batteria) e verificato il funzionamento su alimentazione a batteria
- Preparato uno sketch base con ArduinoOTA per l'upload firmware via Wi-Fi (il primo upload resta comunque necessario via USB)

**Decisioni prese:**
- Contesto: bisognava scegliere come alimentare la logica ESP32 separatamente dai 24V dei motori
- Decisione: batteria 18650 con modulo boost/carica 5V Type-C, interruttore solo sulla linea 5V+ (non sulla batteria), per permettere la ricarica anche a macchina spenta
- Alternative scartate: alimentare l'ESP32 direttamente dai 24V tramite un regolatore dedicato — scartata per ora in favore della soluzione a batteria separata, più semplice da testare in questa fase
- Da rivedere se: emergono problemi di autonomia o di stabilità della tensione 5V sotto carico Wi-Fi

**File consegnati/modificati:** nessun file di codice consegnato in questa sessione (solo sketch inline in chat: Blink su D2, sketch base ArduinoOTA)

**Impatto su Vision/Pipeline:** Prima creazione del documento — Vision e Pipeline stabilite sulla base delle decisioni già prese nelle sessioni precedenti (non tracciate qui perché antecedenti alla creazione di questo documento).

---
