giandcdalcorso11-coder/CNC-2D/firmware/fluidnc/cnc2d-config.yaml

# GDC CNC 2D SLICER — configurazione FluidNC
#
# ATTENZIONE: questa è una configurazione di partenza, non definitiva.
# I valori marcati DA TARARE dipendono dalla meccanica, che non è ancora montata.
# FluidNC valida il file all'avvio e segnala gli errori sulla console: se qualcosa
# non gli torna te lo dice, quindi si procede per correzioni successive.
#
# Riferimento schema: http://wiki.fluidnc.com/en/config/overview

name: GDC CNC 2D
board: ESP32 Dev Module

stepping:
  engine: RMT
  # 255 = i driver restano sempre abilitati, non si disabilitano mai da fermi.
  # Scelta voluta: l'azzeramento è manuale, quindi un asse che si ammorbidisce
  # e viene spostato a mano farebbe perdere la posizione senza accorgersene.
  idle_ms: 255
  pulse_us: 4
  dir_delay_us: 1
  disable_delay_us: 0

axes:
  # ENABLE condiviso tra i due driver A4988.
  #
  # NESSUN ":low" QUI, ed è controintuitivo: il pin dell'A4988 si chiama ENABLE
  # ed è attivo basso, quindi verrebbe spontaneo scrivere gpio.27:low. Ma il
  # campo di FluidNC si chiama *disable*: ci viene scritto "vero" quando i
  # motori vanno spenti. Sull'A4988 si spegne portando il pin ALTO, quindi
  # visto da FluidNC è un disable attivo alto, cioè senza modificatore.
  # Con ":low" la logica si ribalta: FluidNC tiene i motori "accesi" portando
  # il pin alto, che sull'A4988 li spegne. Sintomo: gli impulsi su STEP
  # vengono generati regolarmente, le coordinate avanzano, ma i motori
  # restano immobili e gli alberi molli.
  shared_stepper_disable_pin: gpio.27

  # X = trave del portale (staffa LL): il carrello che porta la penna.
  x:
    # DA TARARE: 80 vale per cinghia GT2 + puleggia 20 denti + microstep 1/16.
    # Formula: (200 * microstep) / (passo_cinghia * denti_puleggia)
    steps_per_mm: 80.000
    max_rate_mm_per_min: 2000.000
    acceleration_mm_per_sec2: 200.000
    max_travel_mm: 300.000     # DA TARARE sulla corsa reale della guida
    soft_limits: false         # richiede l'azzeramento automatico, che non abbiamo

    motor0:
      # Pulsante di emergenza nell'angolo in basso a sinistra.
      # :low:pu = attivo basso con pull-up interno, cioè pulsante verso GND.
      limit_neg_pin: gpio.14:low:pu
      hard_limits: true
      pulloff_mm: 1.000
      stepstick:
        step_pin: gpio.25
        direction_pin: gpio.33

  # Y = rotaie di base (staffe TT): ci scorre sopra tutto il portale,
  # motorizzato su un lato solo.
  y:
    steps_per_mm: 80.000
    max_rate_mm_per_min: 2000.000
    acceleration_mm_per_sec2: 200.000
    max_travel_mm: 300.000     # DA TARARE
    soft_limits: false

    motor0:
      limit_neg_pin: gpio.13:low:pu
      hard_limits: true
      pulloff_mm: 1.000
      stepstick:
        step_pin: gpio.4
        direction_pin: gpio.26

  z:
    # Z non è un asse vero: è il servo del pen-lift, pilotato come asse
    # così il G-code può dire "G0 Z5" per alzare e "G0 Z0" per appoggiare.
    steps_per_mm: 100.000
    max_rate_mm_per_min: 1000.000
    acceleration_mm_per_sec2: 100.000
    max_travel_mm: 10.000
    soft_limits: false

    motor0:
      rc_servo:
        output_pin: gpio.32
        pwm_hz: 50
        # DA TARARE guardando la penna: min = Z0 (appoggiata), max = Z10 (alzata).
        # Partire vicino al centro e allargare a piccoli passi: portare un SG90
        # a fine corsa meccanica lo fa ronzare e ne forza gli ingranaggi.
        min_pulse_us: 1000
        max_pulse_us: 2000

# LED di stato, comandati dall'interfaccia web con M62/M63.
# P0 = verde (tutto bene), P1 = giallo (attenzione), P2 = rosso (errore)
user_outputs:
  digital0_pin: gpio.18
  digital1_pin: gpio.19
  digital2_pin: gpio.2

start:
  must_home: false
