giandcdalcorso11-coder/CNC-2D/(commit log)

2026-09-19 Add ESP32 web dashboard: LED control and Wi-Fi config tab
    Serves a single-page dashboard from the ESP32 with a Controllo tab
    (directional pad placeholders + center button toggling the D2 LED)
    and a Wi-Fi tab that saves SSID/password to NVS and reboots, with
    automatic fallback to a CNC-2D-Setup access point if the stored
    credentials fail to connect. Codice tab is a placeholder reserved
    for future G-code upload once motors/servo are validated.
    Claude-Session: https://claude.ai/code/session_01B9QYaZ22yQtQe7sA7gRsH6
    [cnc2d_dashboard.ino]
2026-09-19 Update session document: web dashboard step done, move to Step 2
    Records the new Step 1.1 (ESP32 web dashboard + Wi-Fi provisioning),
    the raw-string compile bug and fix, and the successful USB/battery
    test of the dashboard.
    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
2026-09-19 Dashboard: add red/yellow/green LED buttons, disable center joystick button
    Adds a row of three dedicated buttons (Rosso, Giallo, Verde) below the
    directional pad to drive the three status LEDs on D2/D19/D18
    independently, replacing the single center-button LED toggle. The
    center joystick button is now disabled, reserved for future motor
    control once the axes are wired up.
    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
2026-09-19 Add ArduinoOTA support for wireless firmware updates
    After the first USB flash, future sketch updates can be uploaded over
    Wi-Fi from Arduino IDE (network port "cnc2d") once the device is on
    the home network, avoiding the cable for routine iteration. OTA is
    password-protected with the same passphrase as the emergency AP.
    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
    [cnc2d_dashboard.ino]
2026-09-19 Add web-based log tab as a substitute for the Serial Monitor over OTA
    Serial Monitor only works over the USB connection, not over the OTA
    network port, so there was no way to see boot/connection/OTA messages
    once uploading wirelessly. Adds a logMsg() helper that mirrors every
    message to both Serial and an in-memory ring buffer, exposed via
    /api/log and rendered in a new Log tab that polls every 2 seconds.
    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
2026-09-19 Log LED toggle events to the web log tab
    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
2026-09-19 Add motor control on left/right arrows and full-turn buttons
    Wires STEP/DIR/ENABLE (D4/D16/D17) to the A4988 driver for motor X.
    Left/right arrows do a single step on tap and continuous stepping
    (non-blocking, timed in loop()) while held; two new buttons below the
    LED row drive a full 200-step revolution in each direction for a
    quick end-to-end test from the dashboard.
    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
2026-09-19 Slow down step timing to diagnose stall-on-start
    Dropping to 15ms/step (from 4ms) as a diagnostic: a stepper stalls if
    driven at cruising speed from a standstill with no acceleration ramp.
    If this fixes the stall, next step is a proper ramp so normal speed
    can be restored without losing steps at start.
    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
    [cnc2d_dashboard.ino]
2026-09-20 Move DIR/ENABLE off D16/D17 to rule out pin-specific flakiness
    ENABLE intermittently failed to hold the motor enabled unless the
    D17 jumper was physically disturbed, despite verified continuity and
    correct Vref, pointing at the pin itself rather than the wiring.
    D16/D17 are reserved for PSRAM on WROVER-class ESP32 modules; moving
    DIR to D26 and ENABLE to D27 is a clean, free test regardless of the
    exact root cause.
    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
    [cnc2d_dashboard.ino]
2026-09-20 Update session document: dashboard extensions, Step 2 driver/motor debug
    Records the new LEDs, OTA support, and log tab on the dashboard, plus
    the Step 2 progress (A4988+motor X wiring, dead first driver replaced,
    Vref calibration, and the still-open motor-stall bug now being tested
    after moving DIR/ENABLE off D16/D17).
    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
2026-09-20 Make motor stepping non-blocking and add motor diagnostics tab
    The full-turn handler busy-waited 3 seconds inside the HTTP handler, starving
    server.handleClient() and ArduinoOTA.handle(). Both full turns and continuous
    motion now run from a step scheduler serviced in loop(), so the handlers return
    immediately and the move can be stopped mid-flight.
    DIR is set once per move with a settle delay instead of being rewritten on every
    pulse, giving the A4988 the setup time it expects before each STEP rising edge.
    Adds a Motore tab to vary step interval, step count and acceleration ramp from
    the browser, plus a direct ENABLE toggle, so a stall can be told apart from a
    wiring fault without reflashi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
    [cnc2d_dashboard.ino]
2026-09-20 Add pin-level forcing endpoint for multimeter diagnosis
    Forces STEP, DIR or ENABLE to a fixed level from the Motore tab so each control
    line can be measured at the driver's own pin, isolating a broken signal path
    from a faulty driver. Any move in progress is stopped first.
    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
    [cnc2d_dashboard.ino]
2026-09-20 Update session document: root cause found, motor X working
    Records that the recycled "24V" supply was an RGB LED controller with PWM
    channel outputs, which caused every symptom of the session and destroyed two
    A4988 modules. Supersedes the earlier power-supply decision and the incorrect
    GPIO16/17 PSRAM hypothesis, and adds the driver acceptance test.
    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
2026-09-20 Add Y axis: second A4988 on D25/D33 with shared ENABLE
    Motor state moves into a struct so both axes share the stepping engine, the
    ramp and the step interval. The up/down arrows now drive Y, the Motore tab
    takes an axis selector including both at once, and the pin test covers all four
    step/dir lines.
    STEP pins are driven low first thing in setup(): left floating they pick up
    noise that the driver reads as step pulses, which spun the Y motor freely as
    soon as it was powered.
    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
    [cnc2d_dashboard.ino]
2026-09-20 Give each axis its own speed and ramp, with sliders
    Speed and ramp length move into the Motor struct so X and Y can be tuned
    separately, which they will need once they carry different masses. Speed is now
    expressed in steps per second rather than microseconds per step, capped at 400
    against the 500 the motor was validated at.
    The Motore tab becomes two per-axis columns with sliders; the full-turn buttons
    move next to the arrow each one belongs to, and the pin test collapses out of
    the way.
    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
2026-09-20 Add per-axis direction inversion, persisted in NVS
    Once the mechanics are mounted an axis will likely run against the arrow that
    drives it. A checkbox per axis flips the DIR level instead of requiring the
    wiring or the code to change, and the choice survives reboots.
    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
    [cnc2d_dashboard.ino]
2026-09-21 Add servo pen lift on D32 with two calibrated positions
    A pen lift needs two well-adjusted positions rather than a continuous angle, so
    the Motore tab gets a slider for each; releasing a slider drives the servo there
    so it can be set by eye, and both are stored in NVS. The joystick's centre
    button, reserved until now, toggles the pen.
    Driven through the native LEDC peripheral rather than a servo library, guarded
    for the API change in arduino-esp32 3.x, so updates stay OTA-only with nothing
    to install.
    The servo starts released and stays that way until asked to move: one driven
    into a mechanical stop the moment it gets power draws a great deal of current.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
2026-09-21 Add FluidNC configuration and reframe the sketch as a bring-up tool
    FluidNC becomes the machine's firmware: it already does coordinated motion,
    acceleration planning across segments and G-code parsing, which is the part the
    custom sketch would have taken weeks to get right. The sketch stays as the
    hardware bench tool it proved to be.
    The config maps the pins we validated, drives the pen servo as a real Z axis
    rather than through the spindle output, keeps the drivers always energised
    (manual origin cannot survive an axis going limp) and exposes the status LEDs
    as user outputs so the web interface can still drive them.
    Claude-Session: htt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
    [cnc2d-config.yaml]
2026-09-21 Update session document: FluidNC decision and interface design
    Records Step 2 as complete, rewrites Step 3 around FluidNC as the machine's
    firmware and Step 4 around the browser-side interface, and captures the
    decisions behind both along with the manual-origin and power supply choices.
    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
2026-09-21 Update session document: mechanical design and FluidNC install
    Adds Step 5 for the physical structure, which the pipeline had no step for at
    all, with the rack-and-pinion decision and the spring preload that answers its
    main weakness. Records the in-situ calibration and backlash measurement methods,
    and the choices made during the FluidNC installation.
    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
2026-09-21 Fix shared stepper disable pin polarity
    The A4988 ENABLE pin is active low, so gpio.27:low looked correct. But
    FluidNC's field is named disable, and the A4988 is disabled by driving
    that pin high -- an active-high disable, written without a modifier.
    With :low the logic inverted and the drivers stayed off exactly when
    they should have been energised: step pulses were generated, the
    coordinates advanced and the state cycled Jog -> Idle, but the motors
    never moved and the shafts stayed loose.
    Both the config comment and the README now carry the reasoning and the
    diagnostic test (unplug ENABLE at the driver: the A4988 pull-down
    enables it, so the motor turning proves the polarity is the fault)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
    [cnc2d-config.yaml]
2026-09-21 Add square and circle test G-code
    Two minimal programs to exercise the axes before the structure exists:
    the square moves one axis at a time and reverses direction at each
    corner, the circle exercises interpolation.
    Sides are 40 mm because that is 3200 microsteps at the configured 80
    steps/mm and 1/16 microstepping -- exactly one shaft revolution, so the
    test is verifiable by eye with a piece of tape on the shaft.
    Neither file touches Z. The servo pulse extremes in the config are
    starting values, and driving an uncalibrated servo risks running it into
    a mechanical stop.
    Claude-Session: https://claude.ai/code/session_01B9QYaZ22yQtQe7sA7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
2026-09-21 Add web interface scaffolding
    Structure and placeholders for the drawing interface: three-column
    workspace with the sheet at the centre, controls on the left and a
    vertical scrubber on the right, plus the log and settings tabs.
    Working: sheet formats and custom sizes, the demo path, the scrubber
    that walks the pen along it, tab navigation, the log with filters, and
    the mock mode. Not implemented yet and marked as such in the interface:
    SVG import, G-code generation, area calibration, pen commands.
    No framework, no libraries, no build step, and classic scripts rather
    than ES modules -- the page has to be served from the ESP32's flash,
    where space is scarce and there is no guaranteed interne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
2026-09-21 Add single-file build, fix sheet sizing and unit labels
    tools/build.py inlines the stylesheets and scripts into one HTML file:
    that is the shape the page needs to take on the ESP32, where separate
    files mean extra HTTP requests served while the machine is driving the
    motors. Gzipped the whole interface is about 14 KB, against the 111 KB
    of WebUI-2 already in that flash.
    Three fixes from rendering the page: the unit was wrapping onto its own
    line below each field, the file panel ignored its hidden attribute
    because display:flex outranked the user-agent rule, and the sheet was
    not using the available height. Sizing the sheet is now the stylesheet's
    job rather than JavaScript's.
    Co-Authored-B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
2026-09-21 Draw a fixed machine bed with the sheet placed on it
    The centre of the workspace is now the machine's travel area, fixed at a
    provisional 300x300 mm, with the sheet drawn inside it at the offset it
    actually sits at. That shows how much travel is left around the paper,
    which is what says whether a drawing fits or runs the carriage into its
    end stop; the sheet's border turns red when it leaves the area.
    It also fixes the sheet distorting when a dimension changed. The size
    was being settled by a CSS aspect ratio competing with the available
    space over the same edge. Now the SVG fills the stage and the viewBox
    scales the bed to fit: no dimension is decided in JavaScript.
    Adds a 10 mm grid with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
2026-09-21 Let the sheet be dragged across the bed
    The sheet can now be dragged with the pointer, and the drawing follows
    by construction rather than by recalculation: the artwork is held in
    coordinates relative to the sheet's bottom-left corner, and the position
    on the bed is added only when the path is built. An imported SVG stays
    valid however the sheet is later moved.
    Screen pixels are converted to machine millimetres through the flipped
    group's own matrix, so the Y inversion and any window size are handled
    without redoing that arithmetic by hand. Positions snap to the
    millimetre; three decimals would be precision this machine does not
    have.
    Adds a button to centre the sheet in the area, and touc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
2026-09-21 Import SVG, optimise the path and generate G-code
    The interface now goes from a dropped SVG to a G-code file. Curves are
    flattened by sampling the browser's own getPointAtLength by arc length,
    which also identifies sub-path breaks: two consecutive samples can never
    be further apart than the step, so a longer jump is a pen lift inside
    one element -- the counter of a D, the hole of an O. Without that check
    a line would cross the letter.
    The optimiser's cost is time, not distance. A pen lift costs about half
    a second of servo travel and settling; fifty millimetres of rapid at
    2000 mm/min costs one and a half. Joining contiguous strokes therefore
    comes before reordering. The reorder is nearest-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
2026-09-22 Add square and circle test G-code with pen moves
    The servo works on the bench, so there is now a version that lifts and
    drops the pen. It uses Z-3 and Z-7, two values in the middle of the
    travel: the extremes map to the 1000 and 2000 us pulses, where an SG90
    often meets its own mechanical stop and sits pushing against itself.
    G92 zeroes X and Y only. Zeroing Z as well would move the pen's
    reference onto an arbitrary position. G4 dwells after each pen move let
    the servo arrive and stop oscillating before the carriage starts,
    otherwise the first stroke is drawn while the pen is still coming down.
    Claude-Session: https://claude.ai/code/ses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
2026-09-25 Update session document: bearing choice and real materials
    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
2026-09-25 Record the rail riser constraint found in CAD
    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
2026-09-26 Aggiunge tracker serie Instagram/TikTok con script Ep. 0-3
    Registro pubblicazione con tutti gli episodi pianificati e voice over
    in bozza per l'episodio introduttivo e i primi tre episodi tecnici
    (Step 1: primo LED, batteria, dashboard web).
    Claude-Session: https://claude.ai/code/session_01Cn9pc1RxFgJ8d4TE23pQ3U
2026-09-26 Aggiunge tracker costi materiali
    Registro spese per elettronica, meccanica, filamento e varie, con la
    spesa Brico registrata come aggregato in attesa dello scontrino
    dettagliato.
    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
2026-09-26 Documento di sessione v11: carrello validato, cremagliera verificata, tre errori intercettati
    Nuova voce di storico [2026-09-26 15:27] con:
    - verifica strutturale del carrello a U rovesciata sullo STEP (fianchi continui,
    anello di forza chiuso, 0,4 mm di aria dal binario)
    - cremagliera m1,5 con gioco 0,2 disegnata e verificata al centesimo
    - tre bug intercettati prima della stampa, in formato Sintomo/Causa/Fix:
    interasse fori NEMA 33 -> 31, due perni Ø8,05 -> Ø8,1, cremagliera
    asimmetrica rispetto all'apice del chevron
    - tre decisioni con alternative scartate: rialzo in legno, alloggiamento motore
    integrato con cremagliera posizionata dal motore, viti anteriori + posteriori
    Step 5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
2026-09-26 Aggiorna costi materiali con elettronica e cuscinetti
    Aggiunge ESP32, breadboard kit, servo, modulo step-up batteria,
    motori NEMA17, driver A4988 e le due varianti di cuscinetti
    (608RS e MR63ZZ) scartate a favore dei 623ZZ, più le calamite.
    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
2026-09-26 Completa costi materiali con LCD, kit starter, PLA+ e totali
    Aggiunge interruttori SPDT, display LCD 1602 I2C, starter kit Miuzei,
    la bobina PLA+ Sunlu e chiarisce l'uso previsto delle calamite
    (ancoraggio del foglio). Calcola i totali per categoria e il totale
    acquistato complessivo.
    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
2026-09-26 Chiarisce voci recuperate/stimate e aggiunge Nano Terminal Adapter
    Segna le batterie NiMH come stima (acquisto originale non ritrovato),
    aggiunge l'alimentatore 12V/3A come stima di un equivalente (materiale
    recuperato, non riacquistato) e il modulo Nano-V3 riadattato a
    morsettiera. Chiarisce che condensatore/pulsanti/resistenze/cavetti
    sono già coperti dallo starter kit e che la batteria NASTIMA 12V non
    è stata usata (sostituita dall'alimentatore).
    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
2026-09-26 Aggiunge colonna prezzo effettivo e chiarisce cuscinetti in uso
    Stima per ogni voce la quota di prezzo attribuibile alla macchina,
    scorporando scorte e materiale non impiegato dai kit multi-pezzo
    (es. Nano Terminal Adapter, starter kit, motori/driver di scorta).
    Rimuove il riferimento ai cuscinetti 623ZZ: il progetto reale usa
    solo 608RS e MR63ZZ. Stima anche lo split del totale Brico tra
    legno, viti e barre di ferro.
    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
2026-09-26 Aggiunge versione PDF del registro costi materiali
    PDF generato da reportlab con tabelle per categoria, stato
    confermato/stima colorato e riepilogo totali evidenziato, a partire
    dai dati di content/costi-materiali.md.
    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
2026-09-26 Documento di sessione v12: corretto l'alimentatore a 12 V 3 A
    L'alimentatore non e piu il 24 V recuperato dalla striscia LED ma un DVE
    DSA-36W-12 da 12 V / 3 A / 36 W. Registrato in Step 1 con le conseguenze:
    la tensione non cambia coppia ne temperatura (driver a corrente controllata),
    bilancio a 0,85 A con tre motori, e il minor margine per il collegamento di
    due motori in serie su un solo driver.
    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
2026-09-26 Documento di sessione v13: bilancio di coppia del motore e opzione doppio motore
    Estesa la voce di sessione del 2026-09-26 (una sola voce per sessione) con la
    seconda meta della giornata:
    - quarto bug intercettato: dato di coppia contraddittorio nell'annuncio del
    motore (130 mN.m contro 60 oz.in, 3,3x di differenza)
    - bilancio di coppia sui dati reali dell'etichetta, con il legame
    corrente -> calore -> coppia e il target di attrito sotto i 7 gradi
    - due decisioni: punto di lavoro a 0,6 A con culla alleggerita, e secondo
    motore tenuto come riserva con le sue avvertenze
    - alimentatore 12 V / 3 A registrato anche nella voce di storico
    Step 5: il problema aperto del vano motore risulta ri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
2026-09-26 Documento di sessione v14: regole di co-editing fra le due sessioni parallele
    Il documento e scritto da due sessioni sullo stesso branch (meccanica/firmware
    e contenuti/social). Aggiunta una sezione in testata con il protocollo: fetch
    e rebase prima di scrivere con push immediato, voci di storico marcate col
    fronte di lavoro, note di Step che si appendono in fondo al proprio Step,
    e regola max(A,B)+1 per risolvere un conflitto sulla Versione senza scartare
    voci.
    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
2026-09-27 Aggiunge archivio storico degli sketch cnc2d_dashboard per le riprese
    Estrae dalla cronologia git 14 snapshot del firmware dashboard, uno per
    ogni tappa significativa (LED singolo, 3 LED/3 pulsanti, OTA, log,
    frecce motore X, debug driver A4988, asse Y, servo pen-lift), con
    README che spiega cosa fa ciascuna versione e a quale commit
    corrisponde. Servono per rigirare i test degli episodi passati con il
    codice esattamente come era in quel momento.
    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
2026-09-27 Collega ogni episodio al codice/file corrispondente nell'archivio
    Aggiunge la colonna "Codice di riferimento" al registro pubblicazione
    con link diretti (relativi, cliccabili su GitHub) ai file
    dell'archivio storico firmware, alla config FluidNC, ai G-code di
    test e ai moduli della webui, per ritrovare subito cosa girare per
    ogni episodio. Aggiunge lo stesso riferimento nelle sezioni già
    scritte (Ep. 1 e Ep. 3).
    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
2026-09-27 Documento di sessione v15: attrito caratterizzato, formato A4, cremagliera chiusa, asse Y aperto
    Sessione del 2026-09-27 sul fronte meccanica.
    Due bug registrati con il pattern Sintomo/Causa/Fix:
    - l'attrito del carrello scambiato per strisciamento: i 12 cuscinetti
    girano tutti liberi e il PLA non tocca, quindi il drag e' attrito
    interno (costante) e non radente (proporzionale). Conseguenza: sotto
    carico il mu effettivo scende invece di restare.
    - due fori passanti che tagliavano la dentatura della cremagliera fino
    in testa, rimossi nella v3.
    Decisioni: formato A4 orizzontale al posto di A5 (la massa ha smesso di
    essere un vincolo); cremagliera in un pezzo solo da 60 passi esatti;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
2026-09-27 Scrive gli script degli episodi 4-7
    Aggiunge voice over, note di ripresa e testo overlay per OTA/log,
    prime frecce sul motore X, primo driver A4988 bruciato e la caccia al
    Vref. Aggiorna lo stato riprese a "da girare" per questi episodi nel
    registro pubblicazione.
    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
2026-09-27 Ancora il registro episodi al lavoro reale, non a un piano ipotetico
    Aggiunge la colonna "Sessione reale" che collega ogni episodio alla
    voce corrispondente dello storico sessioni in
    documento-sessione-cnc-2d.md, con link diretti alle sezioni.
    Sostituisce i 5 episodi generici di Step 5 (immaginati prima che il
    lavoro meccanico fosse documentato) con 9 episodi grounded nelle 4
    sessioni reali del 24, 25, 26 e 27 settembre: modulo/pignone, scelta
    di stampare anche la cremagliera, calcolo cuscinetti, i quattro
    errori intercettati prima di stampare, bilancio di coppia, il falso
    allarme sull'attrito, il salto di formato A5->A4, e l'apertura
    dell'asse Y. L'ultimo episodio (taratura finale) resta s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
2026-10-01 Documento di sessione v16: trave Y, carrello Y prova 1-4, elica invertita e catena di quote sulla trave
    Step 5: due decisioni progettuali nuove (motore Y sotto la trave a cavallo
    dell'anima, anti-sollevamento sul bordo inferiore dell'anima), 17 note di
    cronologia, blocco dei problemi aperti riscritto.
    Voce di storico con tre bug in formato Sintomo/Causa/Fix: dentature con
    elica di mano opposta, carrello che si solleva sotto carico sul motore,
    pattern dei fori motore. Quattro decisioni con alternative scartate e due
    correzioni a quanto avevo detto in sessione.
    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
2026-10-06 Documento di sessione v17: modulo penna, un solo lato X motorizzato, portale assemblato e lista tagli
    Nuovo Step 6 (modulo penna e interfaccia utensili), Step 5 portato in fase
    di assemblaggio con l'obiettivo ridimensionato a 242x256, Step 3 con
    l'azzeramento sui pulsanti d'angolo che supera la scelta di non azzerare.
    Registrati sei bug col pattern Sintomo/Causa/Fix, quattro dei quali sono
    errori di calcolo miei corretti con misure booleane: altezza cremagliera
    letta dal bounding box invece che dai cilindri, margine di corsa preso
    sull'estremita del pezzo invece che della dentatura, argomento del
    baricentro sbagliato di segno, ingombro del carrello Y sottostimato di
    33,5 mm per estremita.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
2026-10-12 Aggiunge nuova base in legno e viti M4 al registro costi
    Nuova base in legno (13 €) e due confezioni di viti M4x20mm (4 €
    totali), entrambe confermate. Segnalate due domande aperte: se la
    nuova base sostituisce quella stimata nello scontrino Brico, e se le
    M4 sono una seconda misura di viteria intenzionale (finora il
    progetto usava solo M3). Aggiornati i totali meccanica e generale nel
    markdown e nel PDF.
    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
2026-10-12 Conferma sostituzione base e viti M4 intenzionali
    La vecchia tavola in legno stimata nello scontrino Brico (3 €) è
    confermata sostituita dalla nuova base da 13 €, segnata come non più
    in uso nel prezzo effettivo. Le viti M4 sono confermate come scelta
    intenzionale di una seconda misura. Ricalcolati i totali meccanica e
    generale nel markdown e nel PDF.
    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
2026-10-12 Chiarisce che le viti M4 si aggiungono alle M3, non le sostituiscono
    Corregge il wording: il progetto ora usa due misure di viteria (M3 +
    M4) invece di una sola, non ha sostituito le M3 con le M4. Nessun
    cambio ai totali, solo alle note descrittive nel markdown e nel PDF.
    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
2026-10-12 Dashboard ESP32: microstep, millimetri, slider servo e prove d'insieme
    I passi non escono piu' da loop(): con i microstep attivi la frequenza sale a
    qualche migliaio di impulsi al secondo e server.handleClient() puo' bloccare il
    loop per centinaia di millisecondi, cioe' passi persi. Ora li emette un timer
    hardware a 20 kHz, con accumulatore a virgola fissa per avere la frequenza
    media esatta anche quando non e' un sottomultiplo del tick.
    L'interfaccia parla in millimetri invece che in passi, perche' la trasmissione
    ora e' nota: pignone m1,5 z20 -> un giro = 94,2478 mm -> 33,953 passi/mm a
    1/16. Il numero di microstep e' impostabile dalla tab Motore ed e' salvato in
    NVS: e' l'unica cosa del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
2026-10-12 Corregge l'hash dello snapshot 15 dopo il rebase
    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
2026-10-12 Sposta le struct prima della prima funzione, per i prototipi dell'IDE
    L'IDE Arduino genera da solo i prototipi di tutte le funzioni dello sketch e li
    inserisce subito prima della PRIMA funzione del file. Nella versione precedente
    la prima funzione era stepsPerMm(), che sta sopra la definizione di struct
    Motor: i prototipi generati di setDir, startMove, stopMotor, axisJson,
    pulseStepOnce e demoStepAt nominavano Motor e DemoStep prima che esistessero, e
    il compilatore si fermava su "variable or field 'setDir' declared void"
    indicando la riga della definizione, che a leggerla e' corretta.
    Nelle versioni precedenti dello sketch il problema non c'era per caso: la prima
    funzione era logMsg(), che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
2026-10-12 Aggiorna Ep.0 con la versione cold open approvata, mai committata
    Lo script con il cold open/trailer (fail reali + "in questa serie...")
    era stato approvato in chat ma non era mai stato scritto nel file,
    che era rimasto alla versione precedente senza il trailer. Allinea
    il file alla versione confermata.
    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
2026-10-12 Rampa del servo, contro il brownout all'avvio del movimento
    Il servo faceva resettare l'ESP32: a ogni comando il LED della scheda e quello
    del modulo di ricarica si spegnevano. Un servo a cui si chiede un angolo
    lontano vede un errore grande e parte alla corrente di stallo (700 mA per un
    SG90, fino a 1,4 A per un MG90S); sull'alimentazione condivisa con la logica
    quel gradino fa cadere il 5 V, l'ESP32 va in brownout e smettendo di generare
    il PWM lascia il servo fermo a meta'.
    servoWriteDeg diventa servoApply (l'unico punto che tocca il PWM) piu'
    servoGoTo, che fissa il bersaglio e lo insegue in serviceServo() di
    servoSlewDeg gradi ogni 10 ms. Default 2 gradi/passo = 200 gradi/s, 0
    disattiv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
2026-10-12 Rinomina lo slider della rampa: l'etichetta diceva il contrario del valore
    "Movimento morbido" con valori 0-20 e' ambiguo: il numero sono i gradi per
    passo, quindi piu' alto = piu' duro, mentre l'etichetta fa pensare il
    contrario e chi lo porta al massimo ottiene il salto secco invece della prova
    piu' dolce. Ora si chiama "Passo della rampa - piu' basso = piu' morbido",
    mostra anche il nome della condizione (molto morbido / morbido / quasi secco /
    salto secco) e il fondo scala scende da 20 a 10, perche' sopra i ~600 gradi/s
    nessun servo riesce a seguire e quel tratto di corsa non distingueva niente.
    Claude-Session: https://claude.ai/code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
2026-10-13 Documento di sessione v18: tagli in proprio, cremagliera X con rialzo integrato, alimentazione a una spina
    Step 1: tre decisioni nuove (una spina da 12 V con due 7805 separati, il 18650
    fuori dal progetto, la breadboard definitiva solo per i segnali) e il bug del
    brownout del servo in Sintomo/Causa/Fix.
    Step 2: riscrittura della dashboard, bug dei prototipi dell'IDE Arduino,
    microstep confermati 1/16 da un dato dell'utente, rampa del servo e la nota sui
    motori che rallentano (costa tempo, non posizione).
    Step 5: nove note, fra cui l'interasse quantizzato dai fori della staffa LL
    (473,400 e' il massimo), la cremagliera X v5 col rialzo integrato e i 21,339 mm
    di margine che restituisce, i ta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
2026-10-13 Scheda di misura del primo asse: come misurare la corsa col solo calibro
    Il numero che serve per FluidNC sono i passi/mm reali, e il modo ovvio di
    ricavarli — comandare 6400 impulsi e misurare i 188 mm risultanti — non si
    puo' fare con un calibro da 150. La scheda li ricava scomponendo la misura
    nei due termini che la compongono:
    - il rapporto di trasmissione, venti denti per giro, che e' esatto per
    costruzione e si verifica contando le cave percorse, senza strumenti;
    - il passo vero della cremagliera stampata, misurato sul pezzo da solo con
    il metodo differenziale (R20 - R10)/10, dove l'errore di appoggio delle
    punte del calibro e' lo stesso nelle due letture e si cancella.
    Le a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
2026-10-13 Documento di sessione v19: registro episodi reale, archivio firmware, costi, primi asset grafici
    Aggiunge la voce (contenuti) che copre tutto il lavoro di questa
    sessione sul fronte social: ristrutturazione del registro episodi
    Instagram per ancorarlo allo storico sessioni reale, archivio storico
    del firmware per rigirare i test passati, tracker costi materiali con
    PDF, consolidamento del branch di lavoro nel default, e primo asset
    overlay costruito direttamente (non via Higgsfield) per icone precise.
    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
2026-10-13 README: perche' i motori fischiano appena arrivano i 12 V
    Domanda ricorrente di chi monta la macchina, e la risposta non e'
    intuitiva: il fischio c'e' prima di qualunque comando perche' l'A4988
    regola la corrente a chopping e la coppia di tenuta richiede corrente
    anche a motore fermo, quindi il chopping non si ferma mai mentre ENABLE
    e' attivo. E driverEnabled parte a true, percio' si sente
    dall'accensione e non dal primo movimento.
    Aggiunta la prova che distingue il caso benigno (togliere la spunta a
    "Driver abilitati": il fischio deve cessare di colpo) da quello che
    viene dall'alimentatore switching, e una tabella dei suoni che invece
    segnalano un problema, incluso il ticchettio da hiccup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
2026-10-13 Prova 1 col metodo dei perni, e il limite vero della misura
    Le punte nude del calibro infilate in una cava appoggiano ogni volta a
    un'altezza diversa, e la lettura cambia a ogni tentativo: l'errore di
    appoggio si cancella nella sottrazione, ma la dispersione fra ripetizioni
    no. Due perni identici appoggiati nelle cave si centrano da soli contro i
    fianchi e il calibro li tocca di tangente, su una superficie definita. Per
    modulo 1,5 il diametro ideale e' 1,68*m = 2,52 mm, quindi due punte da
    trapano da 2,5.
    Campata portata da 10 a 30 passi: la differenza divisa per 20 invece di
    10 dimezza l'errore su p, e 30 passi piu' il perno stanno ancora in un
    calibro da 150.
    Aggiunto il limite che conta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
2026-10-15 Assi rinominati secondo la convenzione cartesiana del foglio
    X e' la trave del portale, quella su cui corre il carrello che porta la
    penna; Y sono le due rotaie di base su cui scorre tutto il portale. Nel
    montaggio iniziale i due nomi erano scambiati rispetto al foglio.
    Non e' solo nomenclatura: nel firmware e in FluidNC il nome dell'asse e'
    la mappatura dei pin, quindi cambiare solo i commenti avrebbe lasciato i
    pulsanti attaccati al motore sbagliato. Scambiati i #define STEP/DIR, i
    blocchi x:/y: del config FluidNC (step, direction e limite, perche' i
    finecorsa stanno fisicamente sugli assi) e le etichette dei pin
    nell'interfaccia e nel README.
    Il cablaggio in breadboard non cambia: il dr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
2026-10-15 Documento di sessione v20: macchina montata, assi rinominati, penna in presa rigida
    Aggiunto un blocco Convenzioni in testa alla Pipeline, valido per tutti
    gli step: nomi degli assi secondo la convenzione del foglio, nomi delle
    staffe, nome dell'applicazione. Con l'avvertenza che tutte le voci e le
    note anteriori a oggi usano i nomi vecchi e non sono state riscritte.
    Step 4 rinominato GDC CNC 2D SLICER e arricchito della specifica della
    tab Impostazioni come unica fonte di verita' dei numeri di taratura, con
    la tabella dei gruppi di valori che dovra' contenere.
    Step 5 passa a completato nella struttura. Tre problemi aperti chiusi
    (disallineamento risolto in montaggio, taglio della staffa L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
2026-10-15 Nomi: GDC CNC 2D SLICER e Pannello di controllo manuale GDC CNC 2D
    Le due applicazioni del progetto avevano nomi descrittivi diversi in ogni
    file ("Interfaccia web CNC-2D", "CNC-2D Dashboard", "CNC-2D - FluidNC") e
    nessun posto in cui fosse detto che sono due cose distinte con ruoli
    diversi. Ora si chiamano:
    - GDC CNC 2D SLICER: la webapp piu' la configurazione FluidNC che la
    esegue. Importa il disegno, genera il G-code, comanda la macchina
    - Pannello di controllo manuale GDC CNC 2D: lo sketch ESP32 di collaudo.
    Serve a montare e diagnosticare, non a disegnare
    La cartella e il file dello sketch restano cnc2d_dashboard: l'IDE Arduino
    esige che cartella e sketch abbiano lo stesso nome e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
2026-10-15 Il rename del repository e' da fare a mano, non e' gia' fatto
    La sessione Claude Code puo' scrivere il contenuto del repository ma non
    le sue impostazioni: la chiamata di rinomina torna 403 dal proxy. Il
    documento lo dava per fatto.
    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
2026-10-15 Documento v21: staffa LL a 550, faccia posteriore, e il confronto pignone/braccetto
    Chiuso l'aperto sulla quota della staffa LL: tagliata a 550, la quota di
    progetto, con 452 mm di avanzo.
    Registrato che l'attacco e' sulla faccia posteriore del motore, senza
    conflitti con pignone e cremagliera, ma che e' la faccia piu' lontana
    dalla trave e quindi lo sbalzo e' massimo.
    Registrato il confronto fra pignone-cremagliera e braccetto per il
    sollevamento della penna. A parita' di raggio la cinematica e' la
    stessa, quindi la scelta non e' sul rapporto: decide il gioco di una
    coppia stampata, ~0,2 mm, che su catena rigida vale 1 N di incertezza
    sulla forza di appoggio e con una molla morbida in ser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
2026-10-15 Schema di principio del modulo Tratto Pen
    Due figure: la catena dal servo alla punta, e i tre stati del
    meccanismo. La seconda e' quella che porta l'informazione, perche' il
    punto del progetto e' difficile da dire a parole: fra primo contatto e
    disegno il servo scende di altri 4 mm e la punta non si muove, perche'
    tutta la discesa va in compressione della molla.
    E' uno schema cinematico, non un disegno di fabbricazione: le quote
    riportate derivano dai conti e sono vincolanti, l'impacchettamento
    dentro l'inviluppo del carrello non lo posso fare senza il CAD.
    Segnato esplicitamente che il pezzo critico sono le bussole di guida e
    non l'ingranaggio, perche' il loro attrito e' l'unico che finis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
2026-10-15 Documento di sessione v22: catalogo riprese e scelta ripresa reale multi-giorno
    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
2026-10-15 Rinomina audio sul posto, storico rinomine, launcher .bat da doppio click
    Cambio su richiesta: niente piu' copie in rinominati/, i file audio vengono
    rinominati direttamente; _elaborati.json diventa uno storico nome originale
    -> nuovo nome con data/ora invece di una semplice lista. Aggiunto il
    launcher "rinomina voice over.bat" per avviare senza aprire un terminale.
    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
2026-10-15 Contatore persistente: la numerazione non si resetta spostando i file
    Prima il numero progressivo veniva ricalcolato scansionando la cartella,
    quindi spostare/archiviare tutti i file numerati (es. in una sottocartella
    per episodio finito) faceva ripartire il conteggio da 1. Ora e' tenuto in
    000-contatore.txt, che non dipende da cosa resta fisicamente in cartella.
    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
2026-10-16 Niente piu' file contatore a parte: riusa lo storico gia' in 000-elaborati.json
    Il numero successivo si ricava dal piu' alto gia' registrato nello storico
    delle rinomine (o nella cartella, se piu' alto), invece di tenere un
    000-contatore.txt dedicato: un file di memoria in meno da non cancellare
    per sbaglio, stesso risultato.
    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
2026-10-16 Schema rev. 2 e documento v22: i cuscinetti tolgono di mezzo la molla
    La scelta dei cuscinetti MR63 al posto delle bussole striscianti porta
    l'attrito della guida da ~0,150 N a ~0,001 N, due ordini di grandezza.
    Sparisce il punto debole segnalato ieri, e con esso la ragione d'essere
    della molla: una volta che l'attrito e' un millesimo di newton il peso
    proprio basta, e un cannotto da 25 g pesa gia' 0,25 N, piu' dei 0,2 che
    si volevano ottenere comprimendo una molla di 4 mm. Una molla che spinge
    in giu' sommerebbe la sua forza al peso invece di darla.
    Schema riscritto di conseguenza: due stadi sulla stessa pista, collegati
    da un giunto a gioco morto da 6 mm invece che da una molla. L'angolo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
2026-10-16 Documento v24: analisi del primo CAD del modulo penna
    Nessuna interferenza fra i 21 componenti e guida vincolata correttamente
    in tutti e cinque i gradi di liberta' che vanno bloccati, imbardata
    compresa.
    Trovato un bug ereditato: il reticolo dei fori motore e' 31,0000 x
    31,4500 invece di 31 quadrato, e lo stesso scarto di 0,450 e' sul
    carrello nello stesso file. E' quello registrato il 2026-10-05 e
    accettato perche' le viti entravano; ora sono due pezzi, e la nota di
    allora diceva gia' che il gioco di registrazione era esaurito.
    Altri quattro numeri: gioco della guida 0,200 per lato che amplificato
    vale 0,942 mm alla punta; massa flottante 44-61 g contro i 20-30
    previsti; corsa in discesa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
2026-10-16 Documento v25: prova_2 del modulo penna, e il pignone che il servo impone
    Chiuso il punto sul reticolo 31,0000 x 31,4500: l'utente ha stampato e
    avvitato piu' volte e le viti entrano, perche' il gioco Ø4 su M3 vale
    0,500 contro 0,450 di scarto, e tutti i pezzi del progetto portano lo
    stesso scarto quindi sono coerenti fra loro. Non e' un errore, e' una
    quota del progetto.
    prova_2: zero interferenze fra 23 componenti, guide allungate di 6 mm
    con la corsa che passa a 16,000 in discesa e 15,350 in salita.
    Trovato che l'albero del servo e' lungo Z e non lungo X, quindi il
    pignone gira nel piano XY. E siccome sta sotto pz1, il suo ingombro
    laterale e' libero: il diametro lo decide solo la dist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
2026-10-16 Cremagliera quotata e ingranaggio sul braccetto del servo
    Disegno del profilo della cremagliera modulo 1,5: fianchi rettilinei,
    quindi bastano tre semilarghezze e due altezze. Con la ricetta in cinque
    passi per rifarlo nel CAD e il vincolo sul raccordo al fondo, che il
    vano da 0,99131 limita a 0,496.
    Decisa la scelta dell'utente di attaccare l'ingranaggio al braccetto in
    dotazione invece di stampare la scanalatura: lo spline di un SG90 ha
    denti alti circa 0,3 mm, meno di una larghezza di estrusione, quindi in
    PLA non ingrana o si spiana. Annegato in una tasca, centrato sul mozzo
    tondo e indicizzato sui bracci, con due viti M2 nei fori gia' presenti.
    Aggiunto il vincolo nuovo sul diametro d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
2026-10-16 Braccetto e ingranaggio: disegno parametrico, perche' le quote non esistono
    Cercate le quote del braccetto a croce dell'SG90: nessun produttore ne
    pubblica un disegno, e le dimensioni cambiano fra i cloni. Sul diametro
    esterno dello spline le fonti danno 4,6 / 4,8 / 4,9, cioe' 0,3 mm di
    divergenza su un accoppiamento a contatto. Concorde solo il numero di
    denti, 21, da cui si deduce il modulo 0,2.
    Quindi il disegno e' parametrico su sei quote da prendere col calibro,
    con le formule che le consumano, invece che su valori medi di internet.
    Il numero di denti del pignone segue da una sola: z >= (A+4)/1,5 + 2,5.
    Corretta una cifra che avevo dato a memoria: i denti dello spline
    sporgono di 0,20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
2026-10-16 Il profilo della cremagliera era a gioco zero: corretto, e i parametri Onshape
    L'utente ha chiesto se avevo tenuto conto delle tolleranze. In parte: le
    quote di accoppiamento le avevo date con il gioco, il profilo del dente
    no, ed erano le quote teoriche. Una coppia stampata a gioco zero non
    ingrana.
    Gioco di ingranamento j = 0,30 scaricato tutto sulla cremagliera,
    assottigliando i denti sulla primitiva: semilarghezza da 1,17810 a
    1,02810. Il perche' di 0,30 e' quantitativo: la catena di tolleranze
    sull'interasse vale +-0,3 e si trasferisce sul gioco moltiplicata per
    2*tan20 = 0,728, quindi a gioco nominale zero grippa meta' delle volte.
    E qui il gioco non costa niente, perche' il giunto a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
2026-10-16 prova_3: corsa in discesa 11 mm, cremagliera a 9 denti, scheda finale
    Misurata la corsa che l'utente chiedeva: pz2 scende di 11,000 mm, e a
    fermarlo sono i cuscinetti inferiori che arrivano in fondo alla pista.
    Fra prova_2 e prova_3 la pista si e' accorciata di 5 mm sul lato basso,
    quindi la discesa e' passata da 16 a 11.
    Da li' i denti: con l'origine sulla faccia inferiore di pz2 il pignone
    ingrana a 25,922 dal fondo della stecca, a fine discesa a 36,922, a
    fine salita a 10,572; con un dente di presa per estremo servono 41,634
    mm, cioe' 9 denti. Otto non bastano.
    Il servo non e' il vincolo: l'intera corsa della guida sta in 80,5 gradi
    su 180, con +-49,7 di margine di montaggio contro i 17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
2026-10-16 Documento di sessione v30: il CAD del modulo penna dalla prova_1 alla prova_3
    Voce di storico per l'arco di lavoro sul CAD: tre revisioni analizzate
    con OCP, le tre schede di disegno consegnate, il calcolo della corsa in
    discesa e i 9 denti della cremagliera che ne derivano.
    Registrato col pattern Sintomo/Causa/Fix il profilo della cremagliera
    dato a gioco zero, che non e' stato trovato da me ma dall'utente che ha
    chiesto esplicitamente delle tolleranze.
    Quattro decisioni, fra cui il pignone z25 che supera la raccomandazione
    z20 data poche ore prima: il pignone sta sulla parte fissa e la
    cremagliera su quella flottante, quindi la massa del disco e' gratis e
    quella della mensola no.
    Corret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
2026-10-17 prova_4: la cremagliera e' esatta ma a gioco zero, e lo schema non e' il CAD
    Analisi di modulo_tratto-pen_tot_prova_4.step.
    La cremagliera modellata e' geometricamente perfetta: passo 4,712,
    profondita' 3,375, fianchi a 20,00 gradi, interasse 18,750, tutto esatto
    al millesimo. 10 denti da Y -30,000 a +16,133, con 1,24 denti di margine
    sotto e 0,95 sopra il campo utile. Corsa invariata.
    Manca solo il gioco: traslando la stecca lungo Y a pignone fermo a passi
    di 0,025 mm, la finestra senza compenetrazione e' larga 0,000 mm. Le
    quote disegnate sono le nominali. Aggiunta alla scheda una sezione 6 con
    due sole quote da cambiare, espresse come larghezze invece che come
    semilarghezze: pianetto di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
2026-10-17 Denti dritti confermati sul pen-lift, con la motivazione dell'utente
    La doppia elica a 40% che l'utente aveva impostato il 2026-10-16 non si
    mette. La motivazione e' sua ed e' migliore di quella che avevo dato io:
    l'ingranaggio e' avvitato a un braccetto, quindi la sua quota assiale non
    e' un riferimento (profondita' del braccetto sullo spline, profondita'
    della tasca, due M2 in torrette stampate). I denti dritti danno un range
    su quella quota, l'elica lo converte in errore nel piano di rotazione.
    Il numero era gia' nel documento, misurato sugli assi X e Y il
    2026-09-26: centraggio ammesso +-0,17 mm con la doppia elica contro +-2
    mm con i denti dritti. Sugli assi il riferimento assiale esis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
